zmetzing/rt-ihu/README

This repo holds the physical design files for the:

     Radiation Tolerant Internal Housekeeping Unit (RT-IHU)

The RT-IHU was conceived as a successor to the Fox-series IHU flight computer.
It aims tp increase reliability in higher Earth orbits where a harsher
radiation environment might cause early failure of the "legacy" IHU design.

The directory hierarchy is as follows:

pcb/<name>              Schematic and layout files for <name> board
kicad_lib               Symbol and footprint libraries for KiCAD
docs                    Design documentation for the supervisor

Z. Metzinger 14-Jan-2025

Credits
-------

Initial design/schematic/layout (v1.0, v1.1, v1.2) by Z. Metzinger (N0ZGO)
Design review and input from J. Brandenburg (KF5IDY), B. Davis, B. Fisher (WB1FJ),
       M. McCann (KB2GHZ), B. Reed (NX5R), E. Skoog (K1TVV), J. Trewitt (KF5COQ),
       and all the team members of AMSAT GOLF -- present and former.
KiCAD 7.x conversion and v1.2.1 layout by C. Castillo (KJ7ILB)

Release Notes
-------------

v1.2.1
    U37 and U39 are wired incorrectly and require blue-wire fixes
    U38 is DNI, but a blue wire must be installed between pins 1 and 5 on PCB
