zmetzing/rt-ihu/docs/rtihu_schematic.pdf

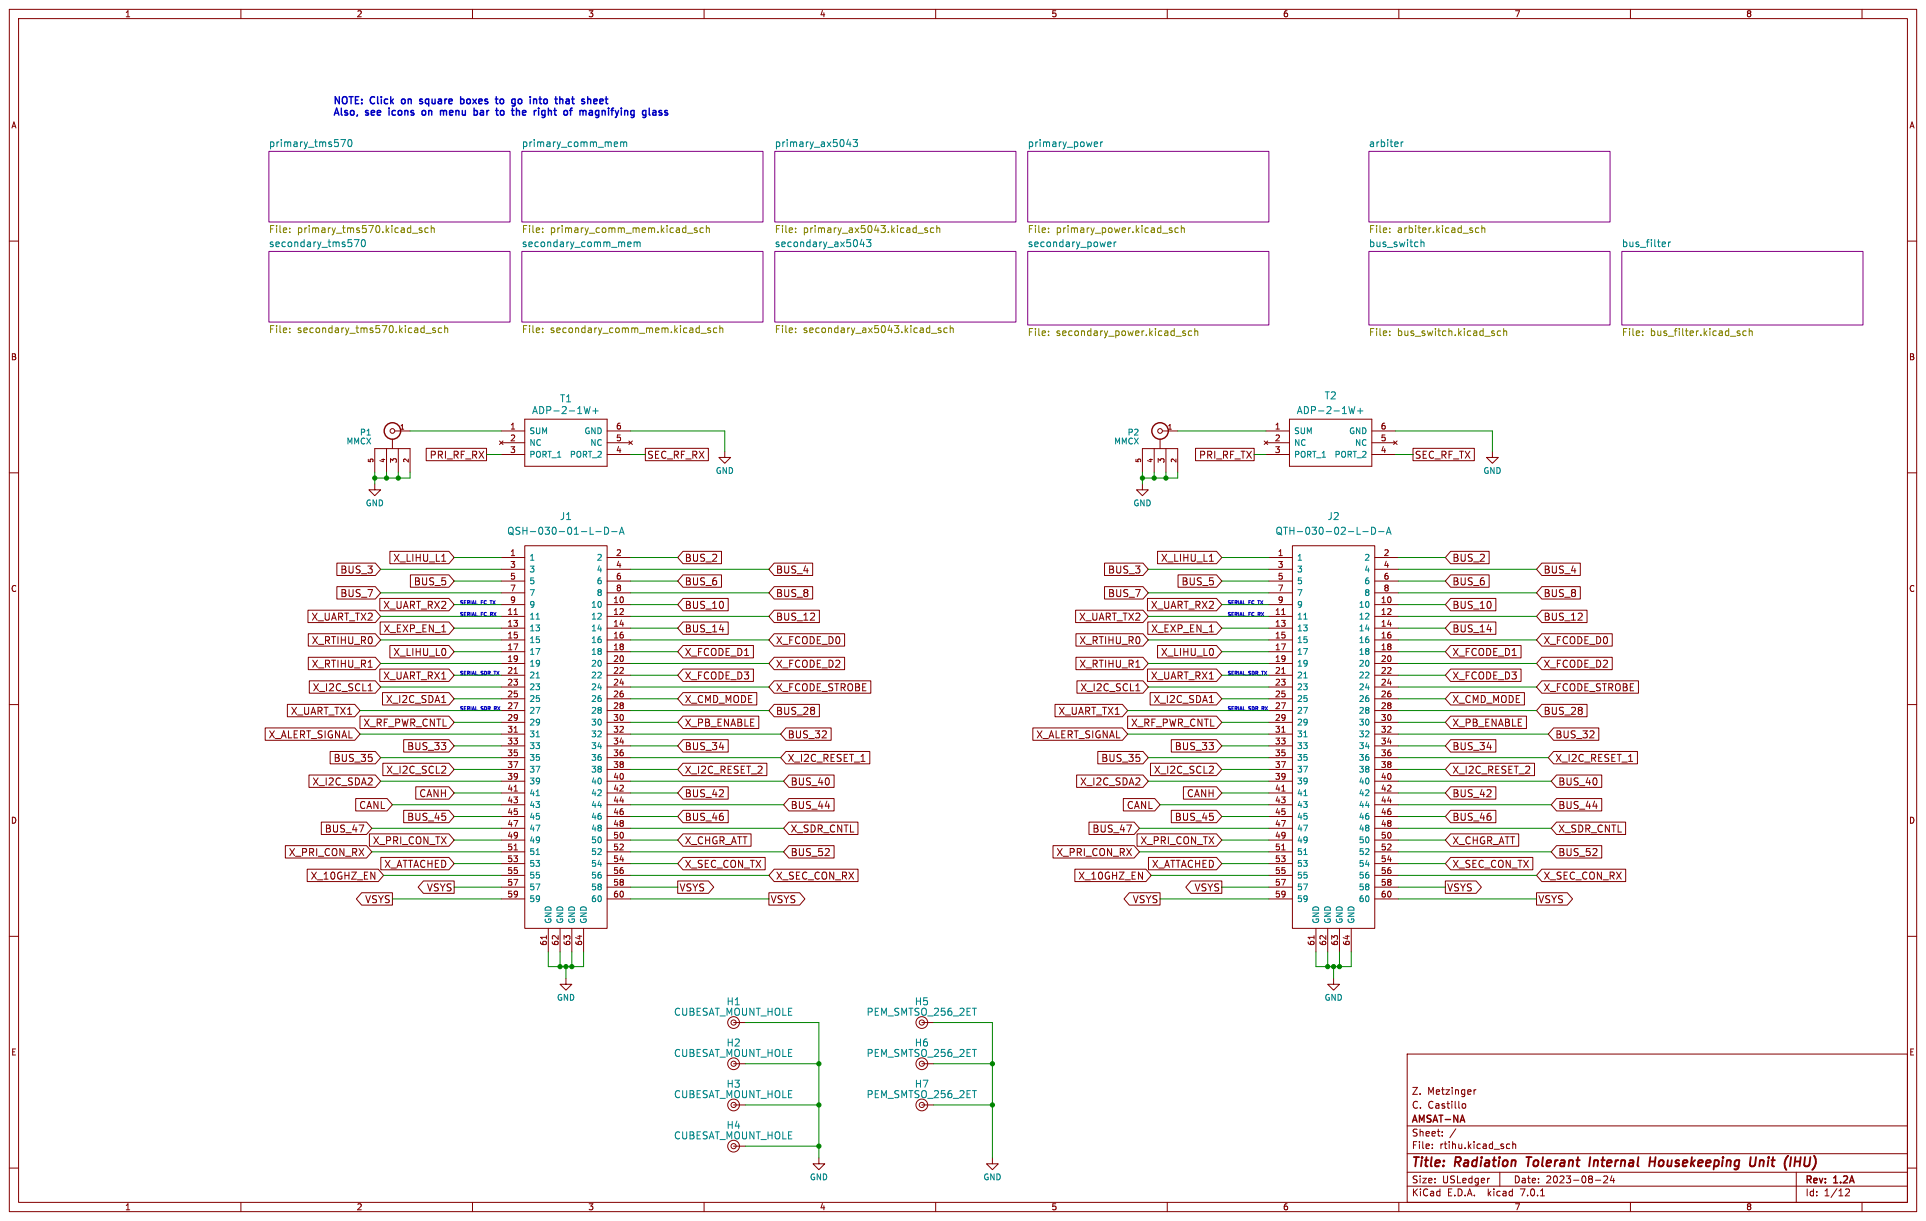
[picture p1: page 1]

NOTE: Click on square boxes to go into that sheet Also, see icons on menu bar to the right of magnifying glass

Id: 1/12 Title: Radiation Tolerant Internal Housekeeping Unit (IHU) File: rtihu.kicad_sch Sheet: / AMSAT-NA

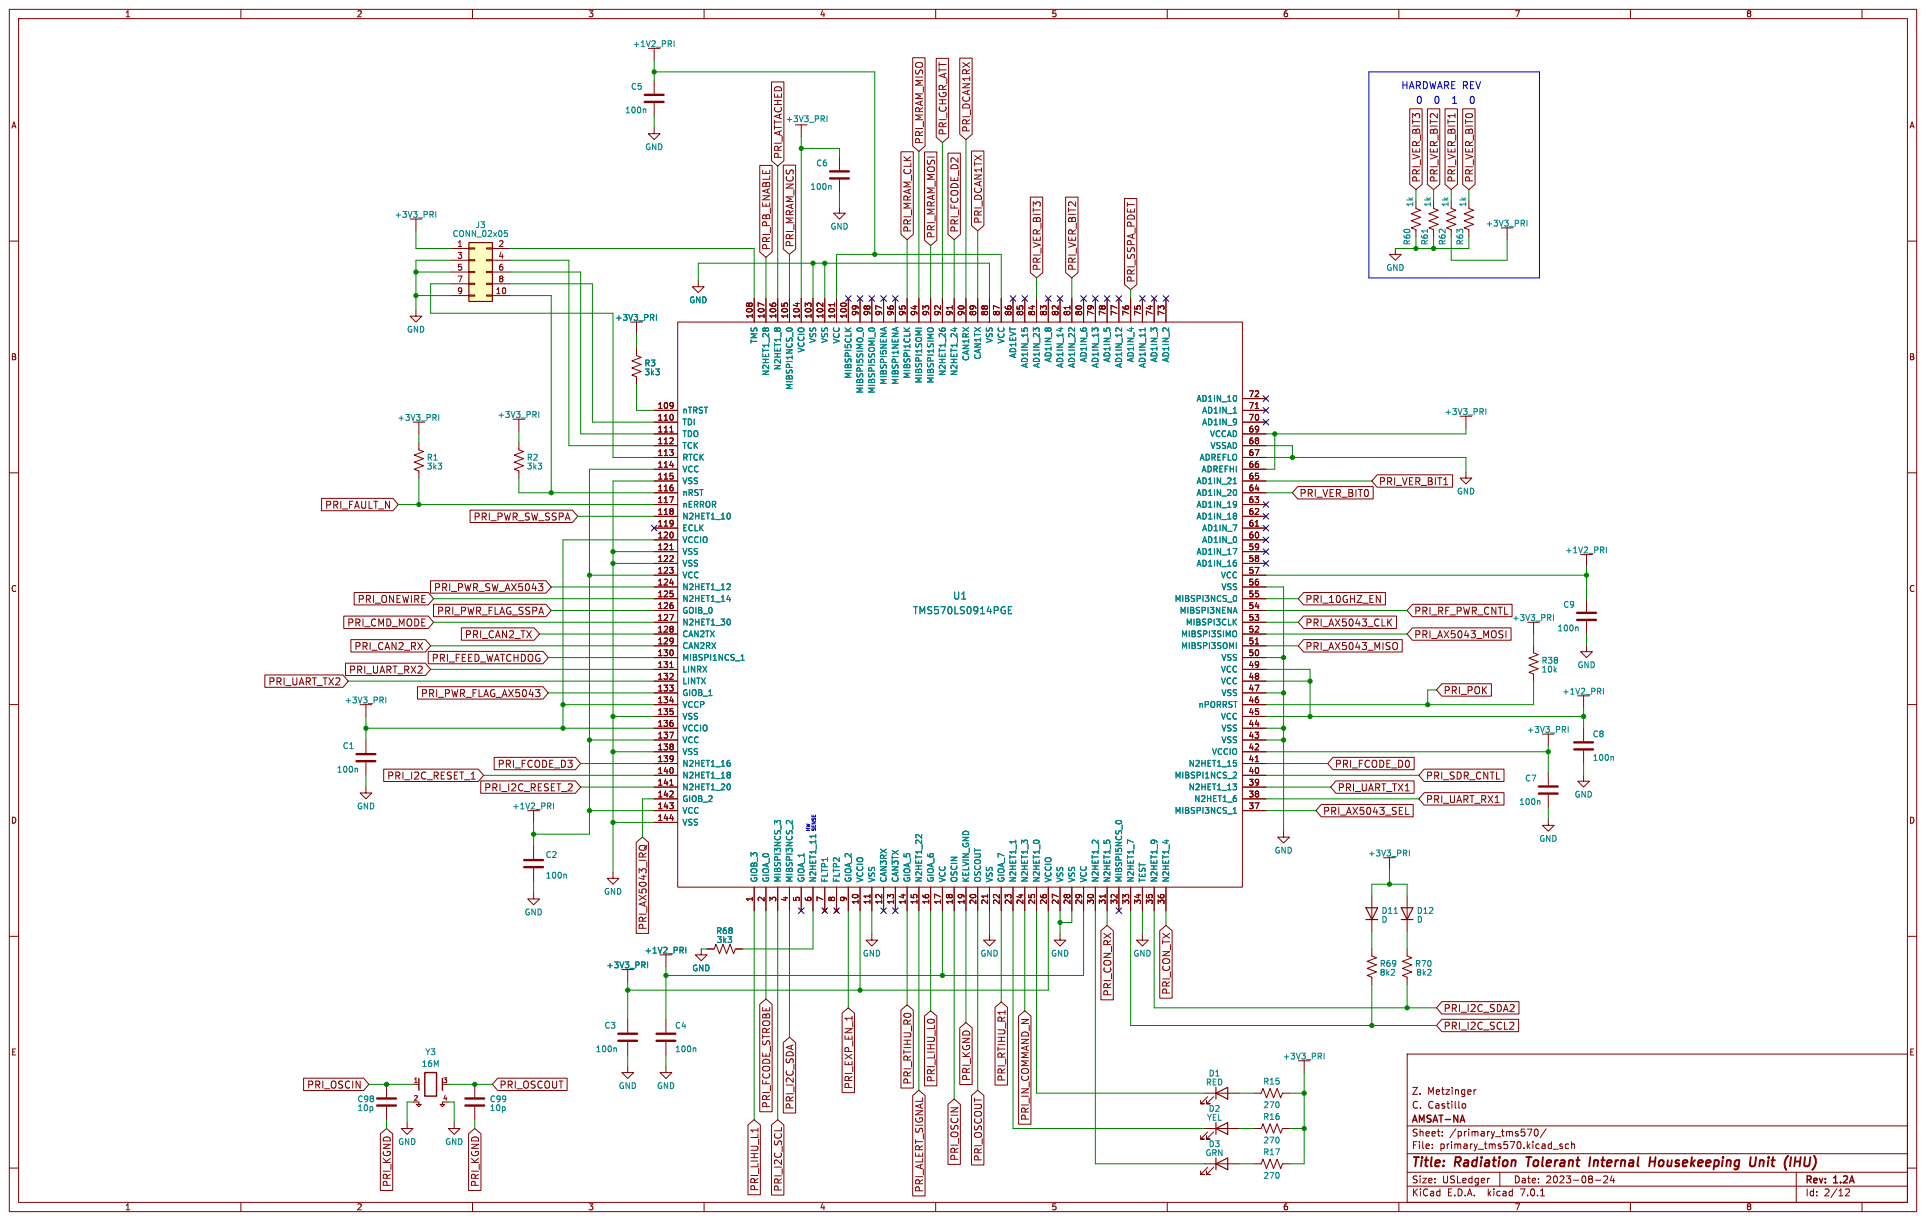
[picture p2: page 2]

C. Castillo Z. | Metzinger

primary_tms570.kicad_sch Sheet: /primary_tms570/ AMSAT-NA Id: 2/12 Title: Radiation Tolerant Internal Housekeeping Unit (IHU) File:

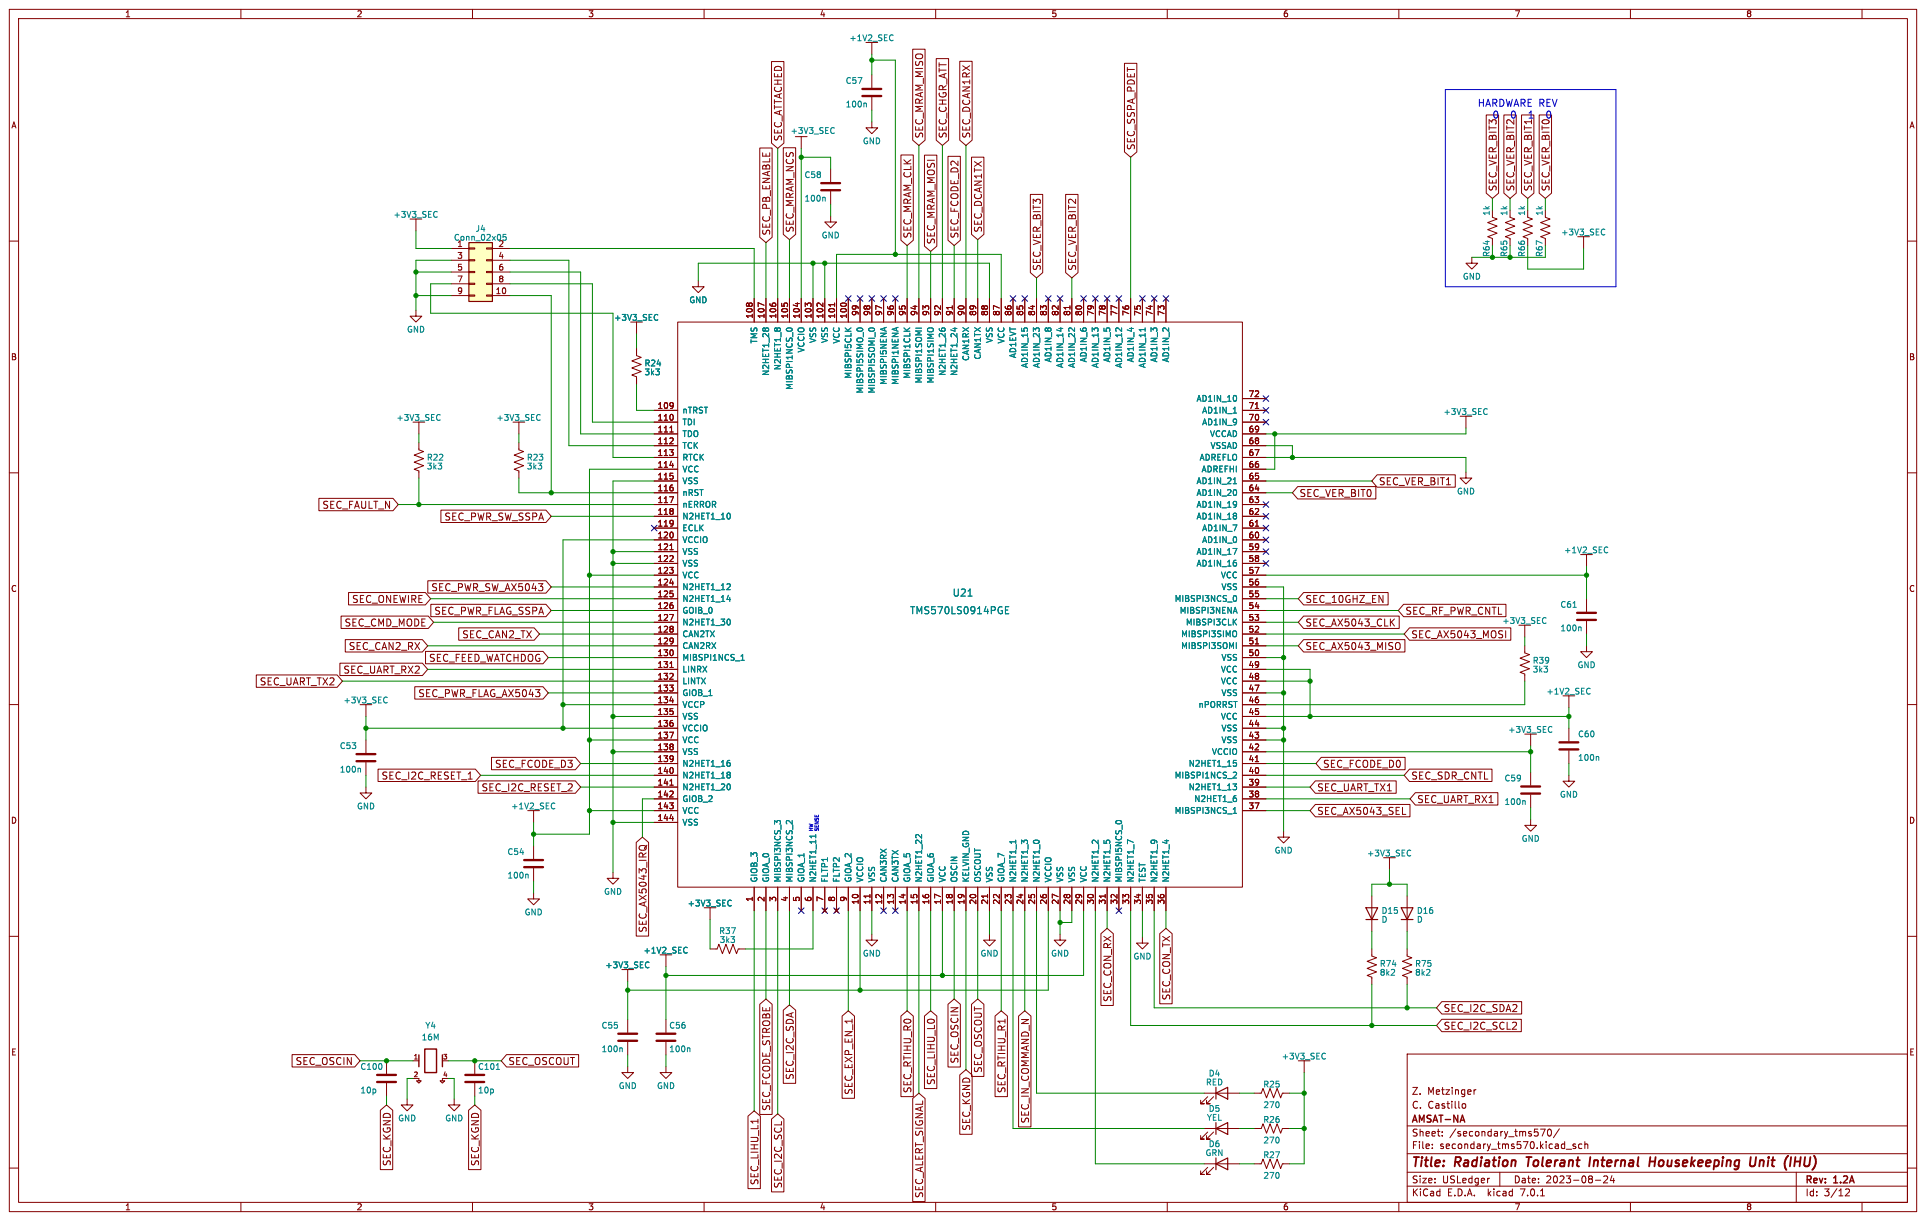
[picture p3: page 3]

Id: 3/12 Title: Radiation Tolerant Internal Housekeeping Unit (IHU) File: secondary_tms570.kicad_sch Sheet: /secondary_tms570/ AMSAT-NA

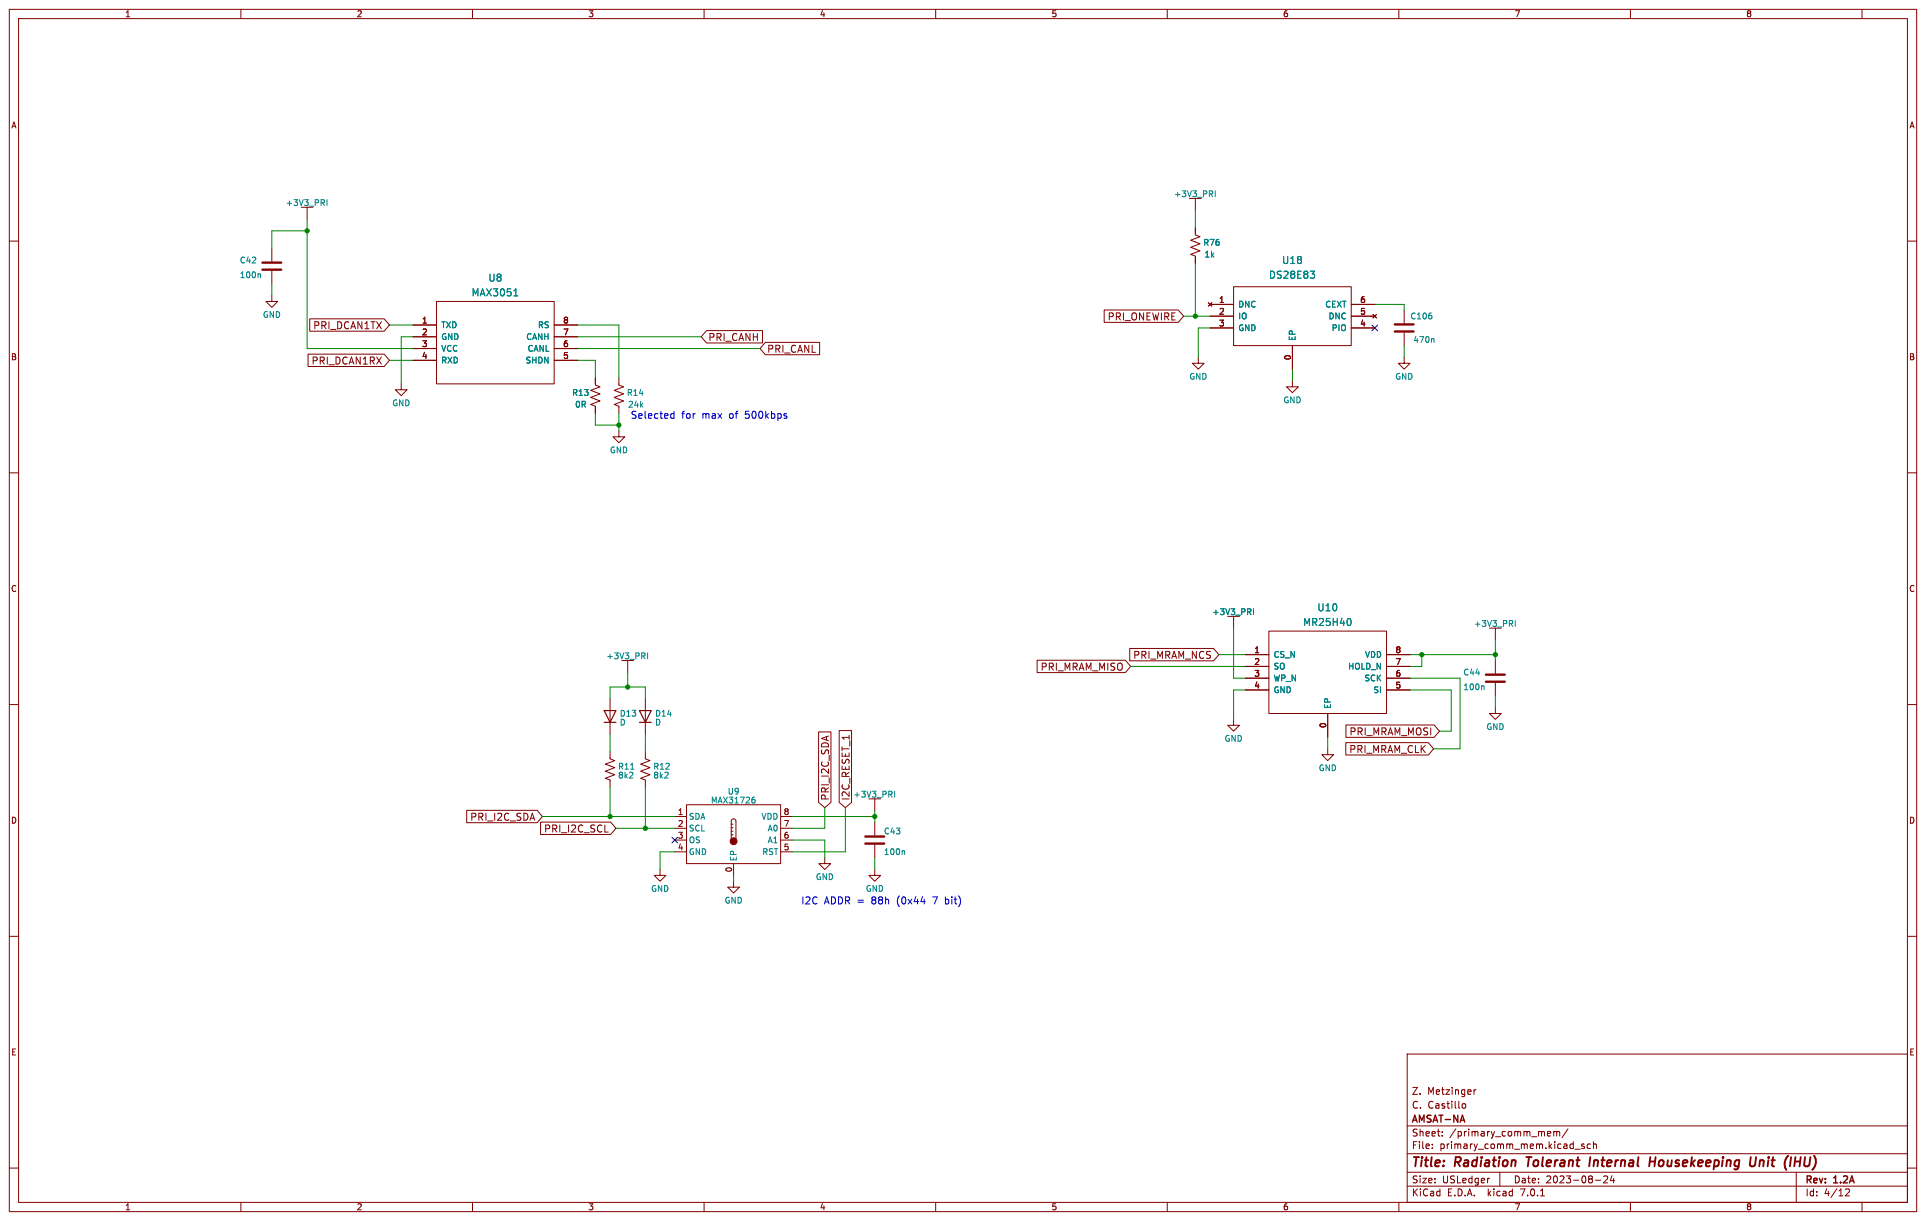
[picture p4: page 4]

0 CS_N 1 SO 2 WP_N 3 GND 4 SI 5 SCK 6 HOLD_N 7 VDD 8 U18 DS28E83 EP

0 CS_N 1 SO 2 WP_N 3 GND 4 SI 5 SCK 6 HOLD_N 7 VDD 8 U10 MR25H40 GND EP

Selected for max of 500kbps

0 SDA 1 SCL 2 OS 3 GND 4 RST 5 A1 6 A0 7 VDD 8 U9 MAX31726 D14 D GND

C. Castillo Z. | Metzinger

primary_comm_mem.kicad_sch Sheet: /primary_comm_mem/ AMSAT-NA Id: 4/12 Title: Radiation Tolerant Internal Housekeeping Unit (IHU) File:

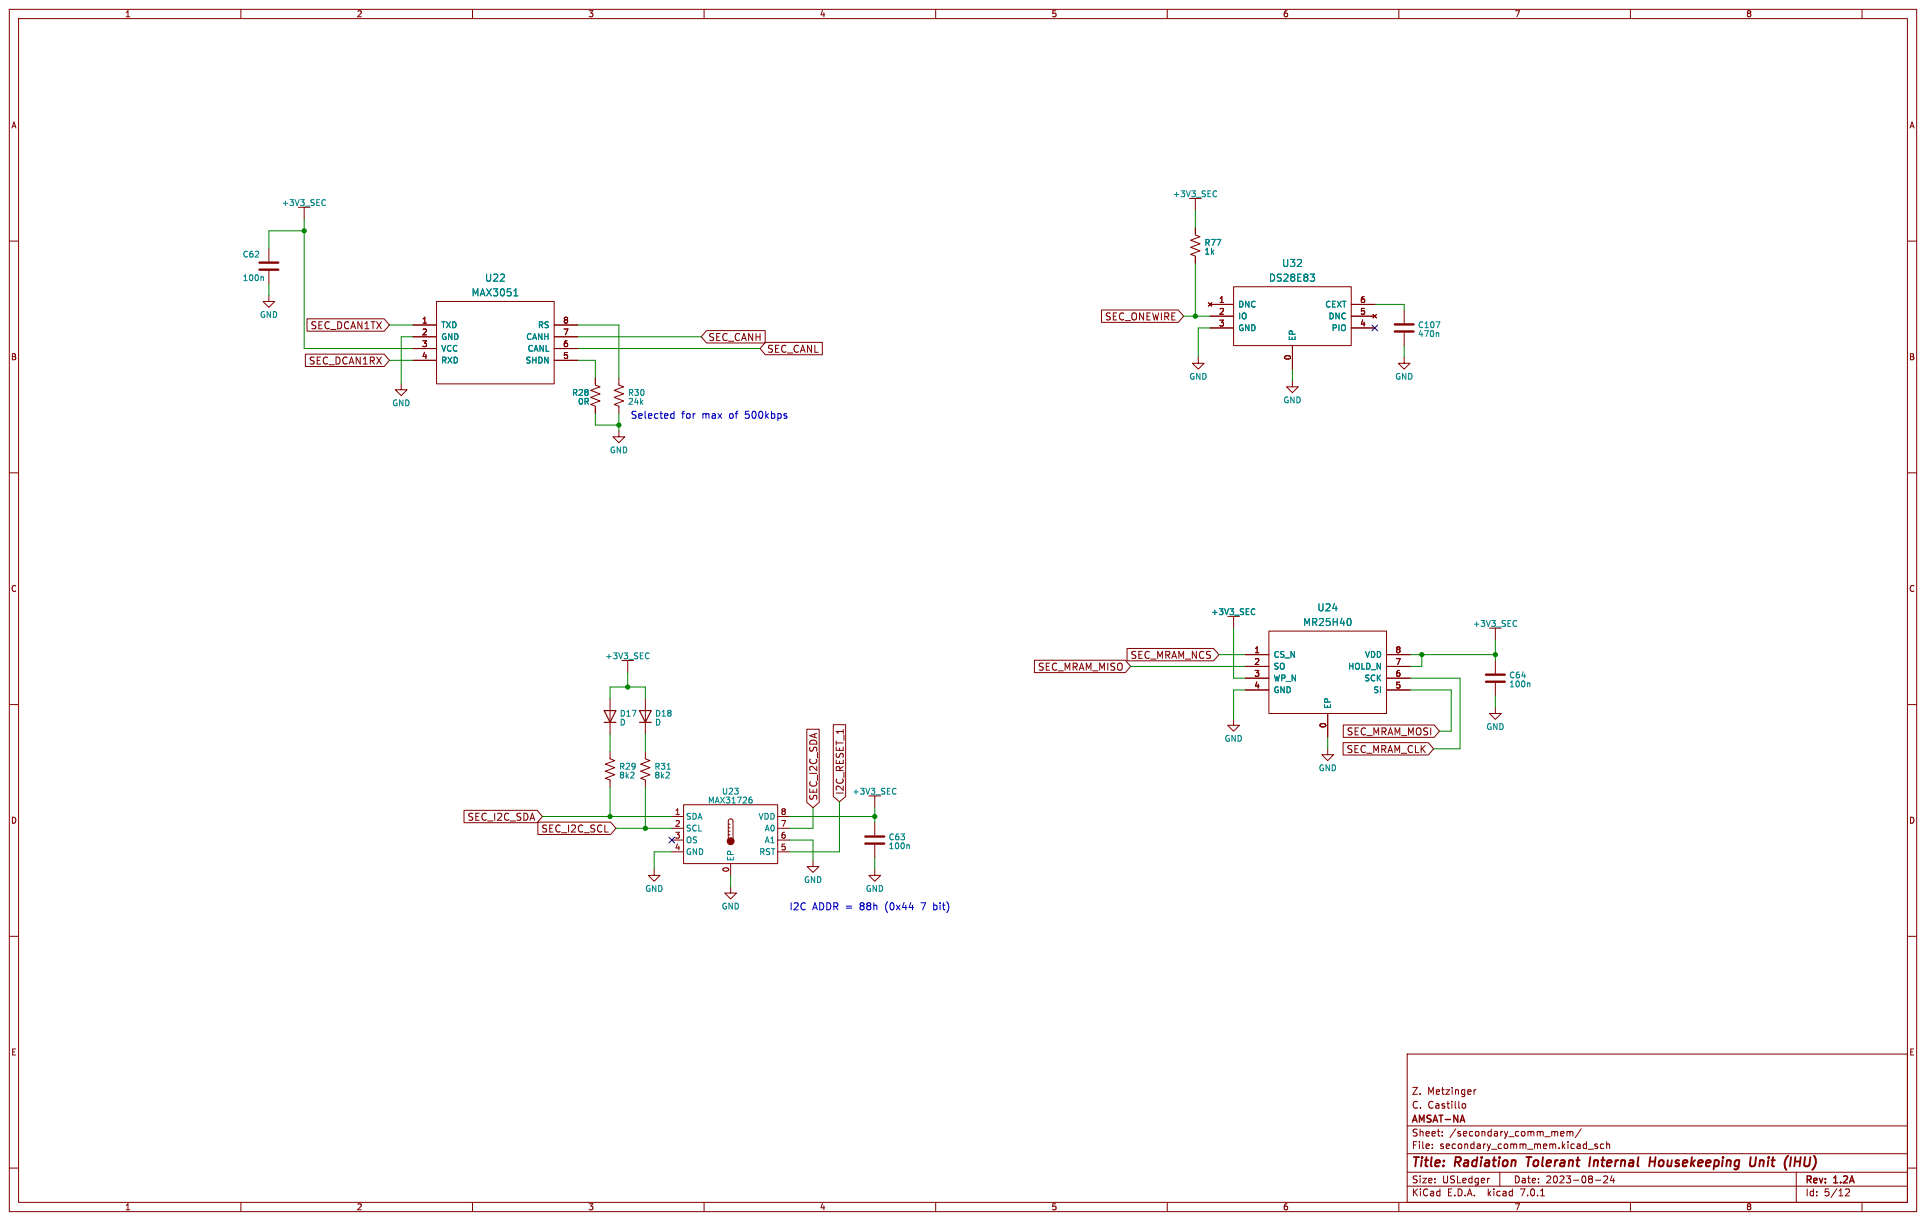
[picture p5: page 5]

Selected for max of 500kbps

0 CS_N 1 SO 2 WP_N 3 GND 4 SI 5 SCK 6 HOLD_N 7 VDD 8 U24 MR25H40 SEC_I2C_SDA

0 CS_N 1 SO 2 WP_N 3 GND 4 SI 5 SCK 6 HOLD_N 7 VDD 8 +3V3_SEC

0 SDA 1 SCL 2 OS 3 GND 4 RST 5 A1 6 A0 7 VDD 8 U23 MAX31726 GND

Id: 5/12 Title: Radiation Tolerant Internal Housekeeping Unit (IHU) File: secondary_comm_mem.kicad_sch Sheet: /secondary_comm_mem/ AMSAT-NA

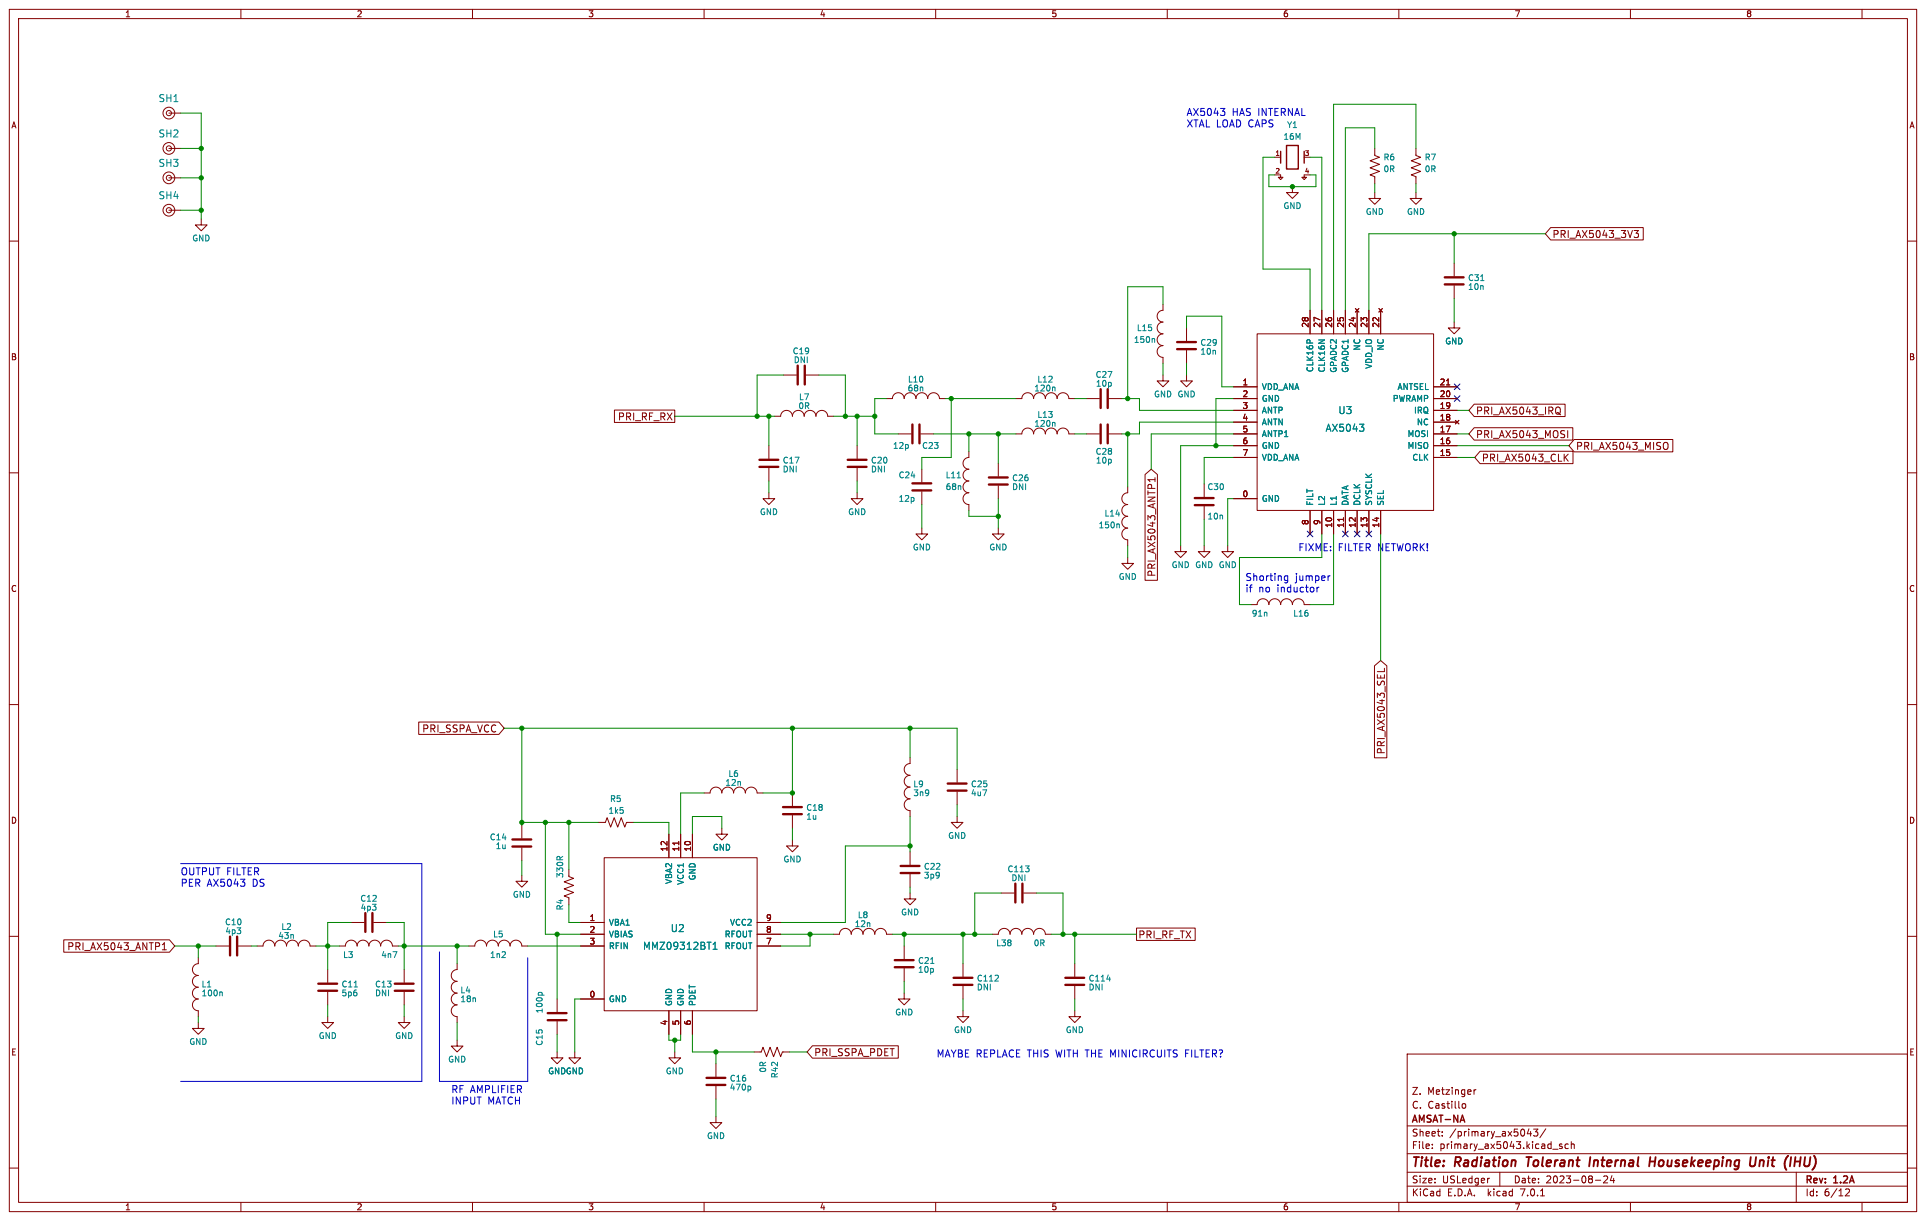
[picture p6: page 6]

AX5043 HAS INTERNAL XTAL LOAD CAPS

6 RFOUT 7 RFOUT 8 VCC2 9 GNDGND GND U3 AX5043 GND 0 VDD_ANA 1 L1 10 DATA 11 DCLK 12 SYSCLK 13 SEL 14 CLK 15 MISO 16 MOSI 17 NC 18

C. Castillo Z. | Metzinger

primary_ax5043.kicad_sch Sheet: /primary_ax5043/ AMSAT-NA Id: 6/12 Title: Radiation Tolerant Internal Housekeeping Unit (IHU) File:

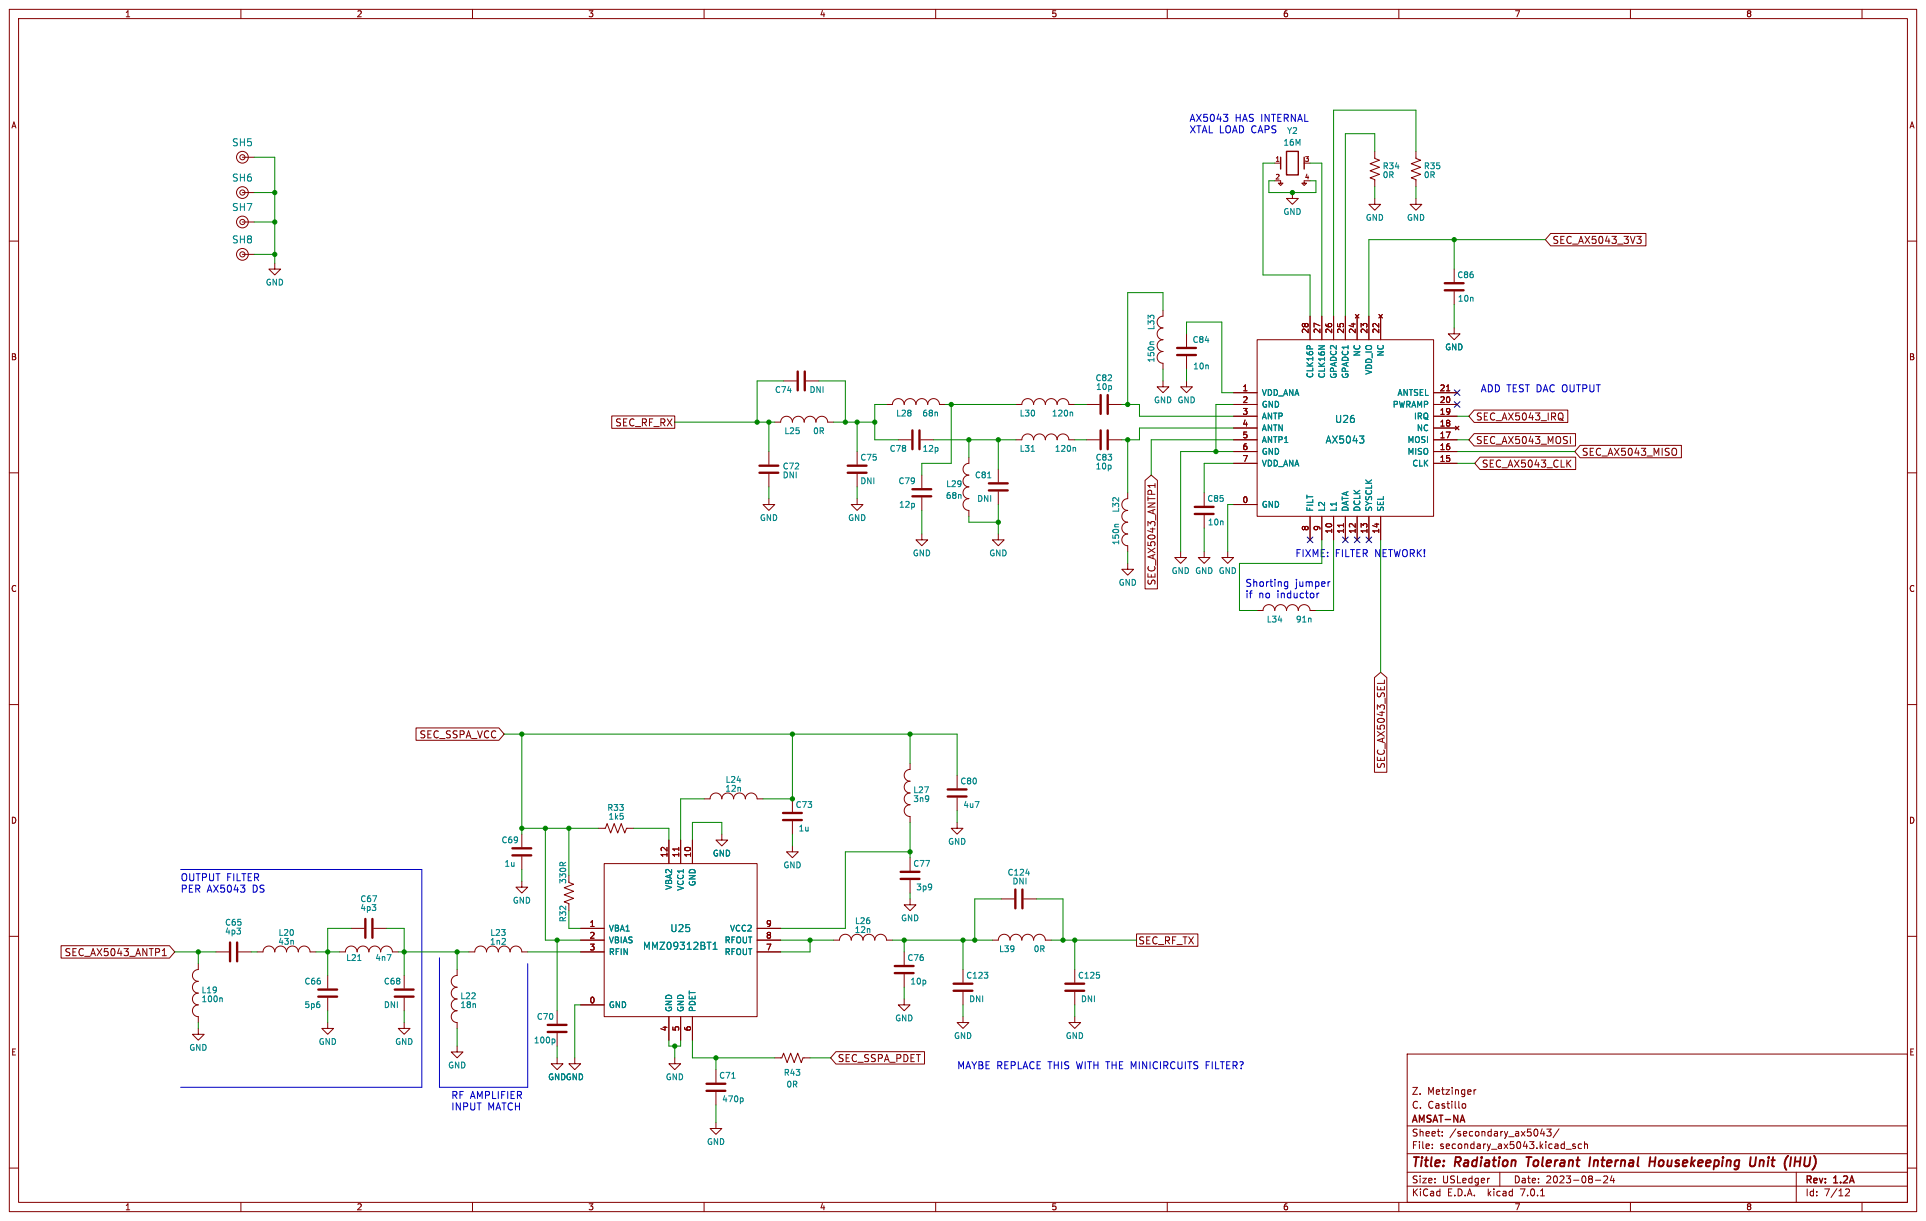
[picture p7: page 7]

FIXME: FILTER NETWORK! AX5043 HAS INTERNAL XTAL LOAD CAPS

ADD TEST DAC OUTPUT MAYBE REPLACE THIS WITH THE MINICIRCUITS FILTER?

if no inductor RF AMPLIFIER

6 RFOUT 7 RFOUT 8 VCC2 9 GND GNDGND

Id: 7/12 Title: Radiation Tolerant Internal Housekeeping Unit (IHU) File: secondary_ax5043.kicad_sch Sheet: /secondary_ax5043/ AMSAT-NA

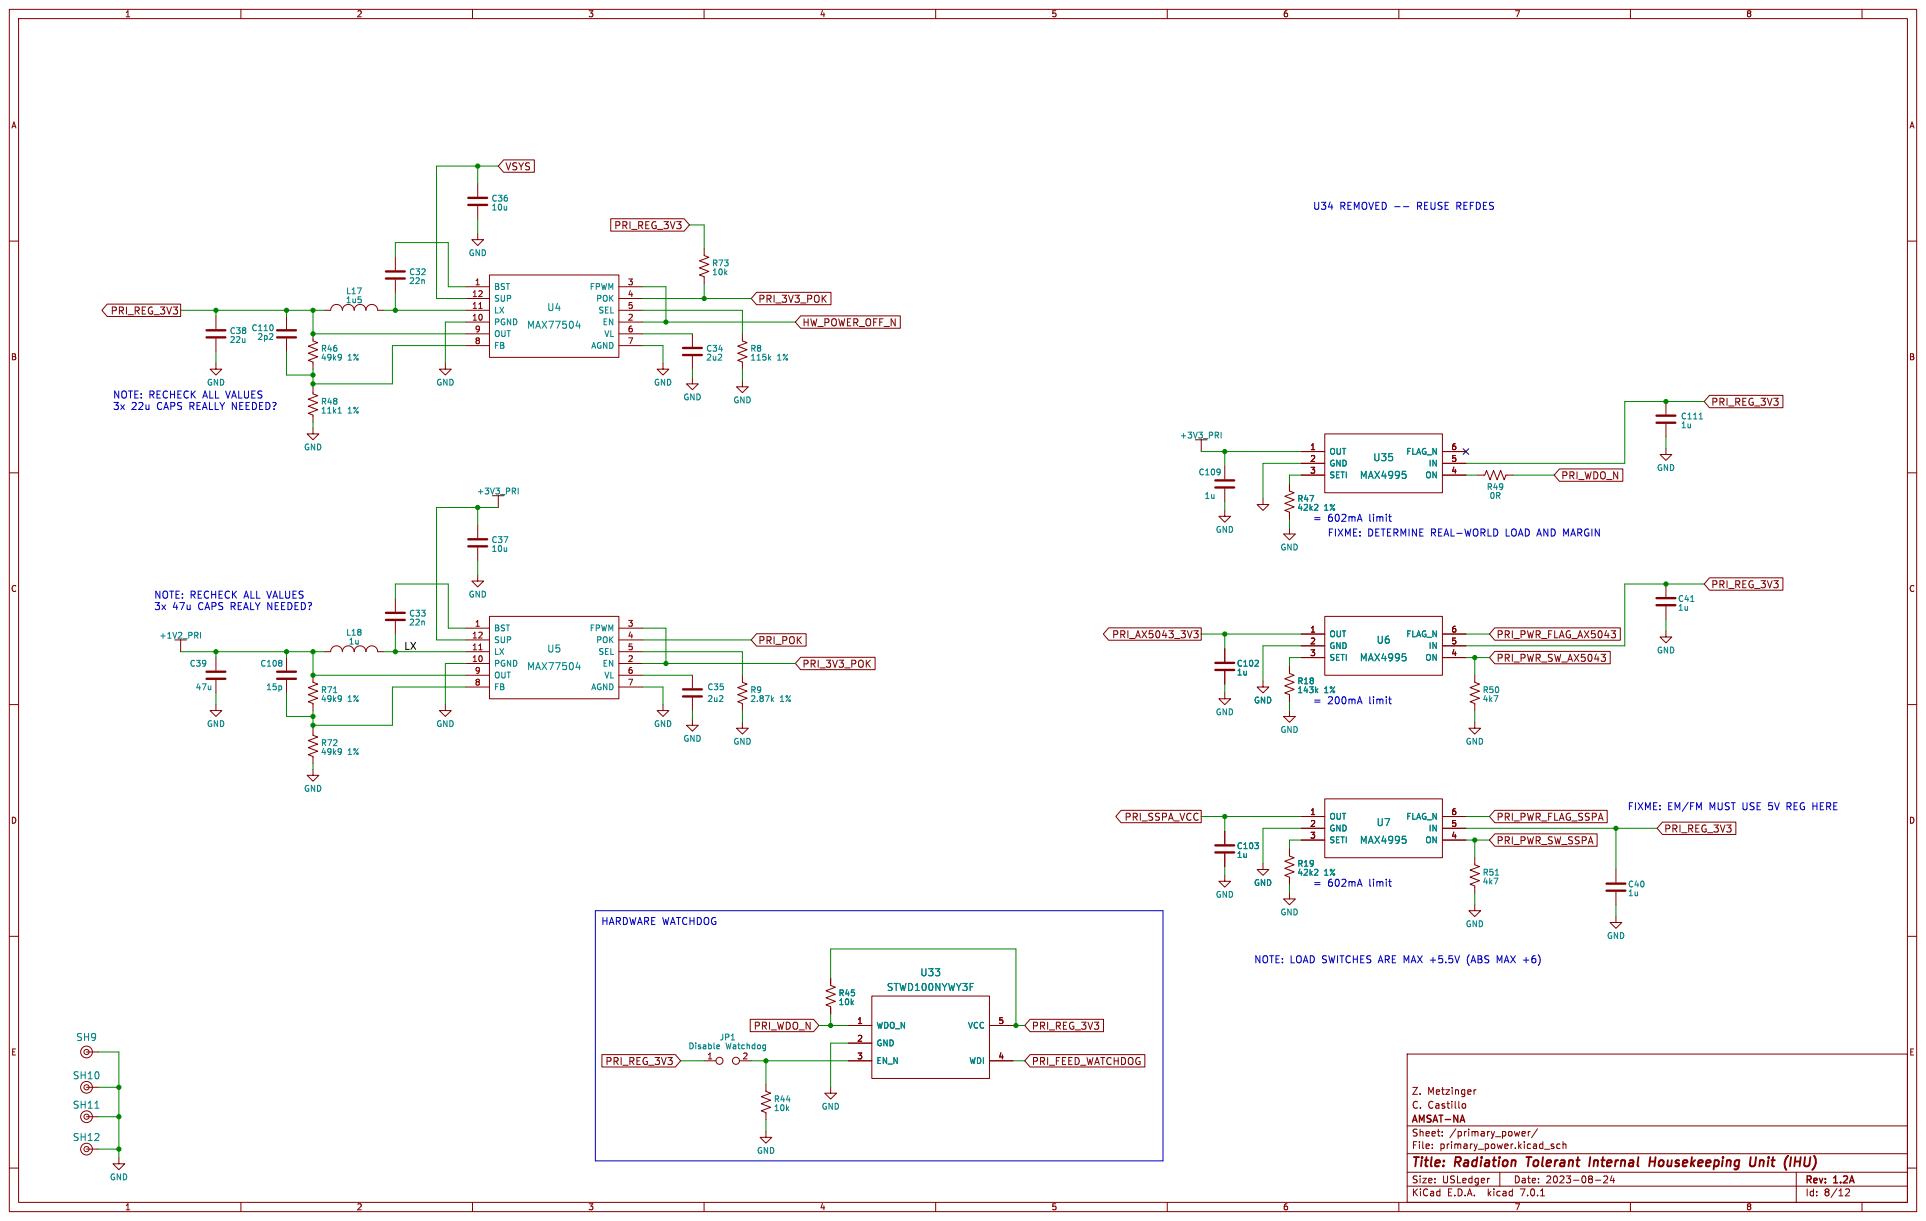
[picture p8: page 8]

NOTE: RECHECK ALL VALUES

FIXME: DETERMINE REAL-WORLD LOAD AND MARGIN

FIXME: EM/FM MUST USE 5V REG HERE

C. Castillo Z. | Metzinger

primary_power.kicad_sch Sheet: /primary_power/ AMSAT-NA | Id: 8/12 Title: Radiation Tolerant Internal Housekeeping Unit (IHU) File:

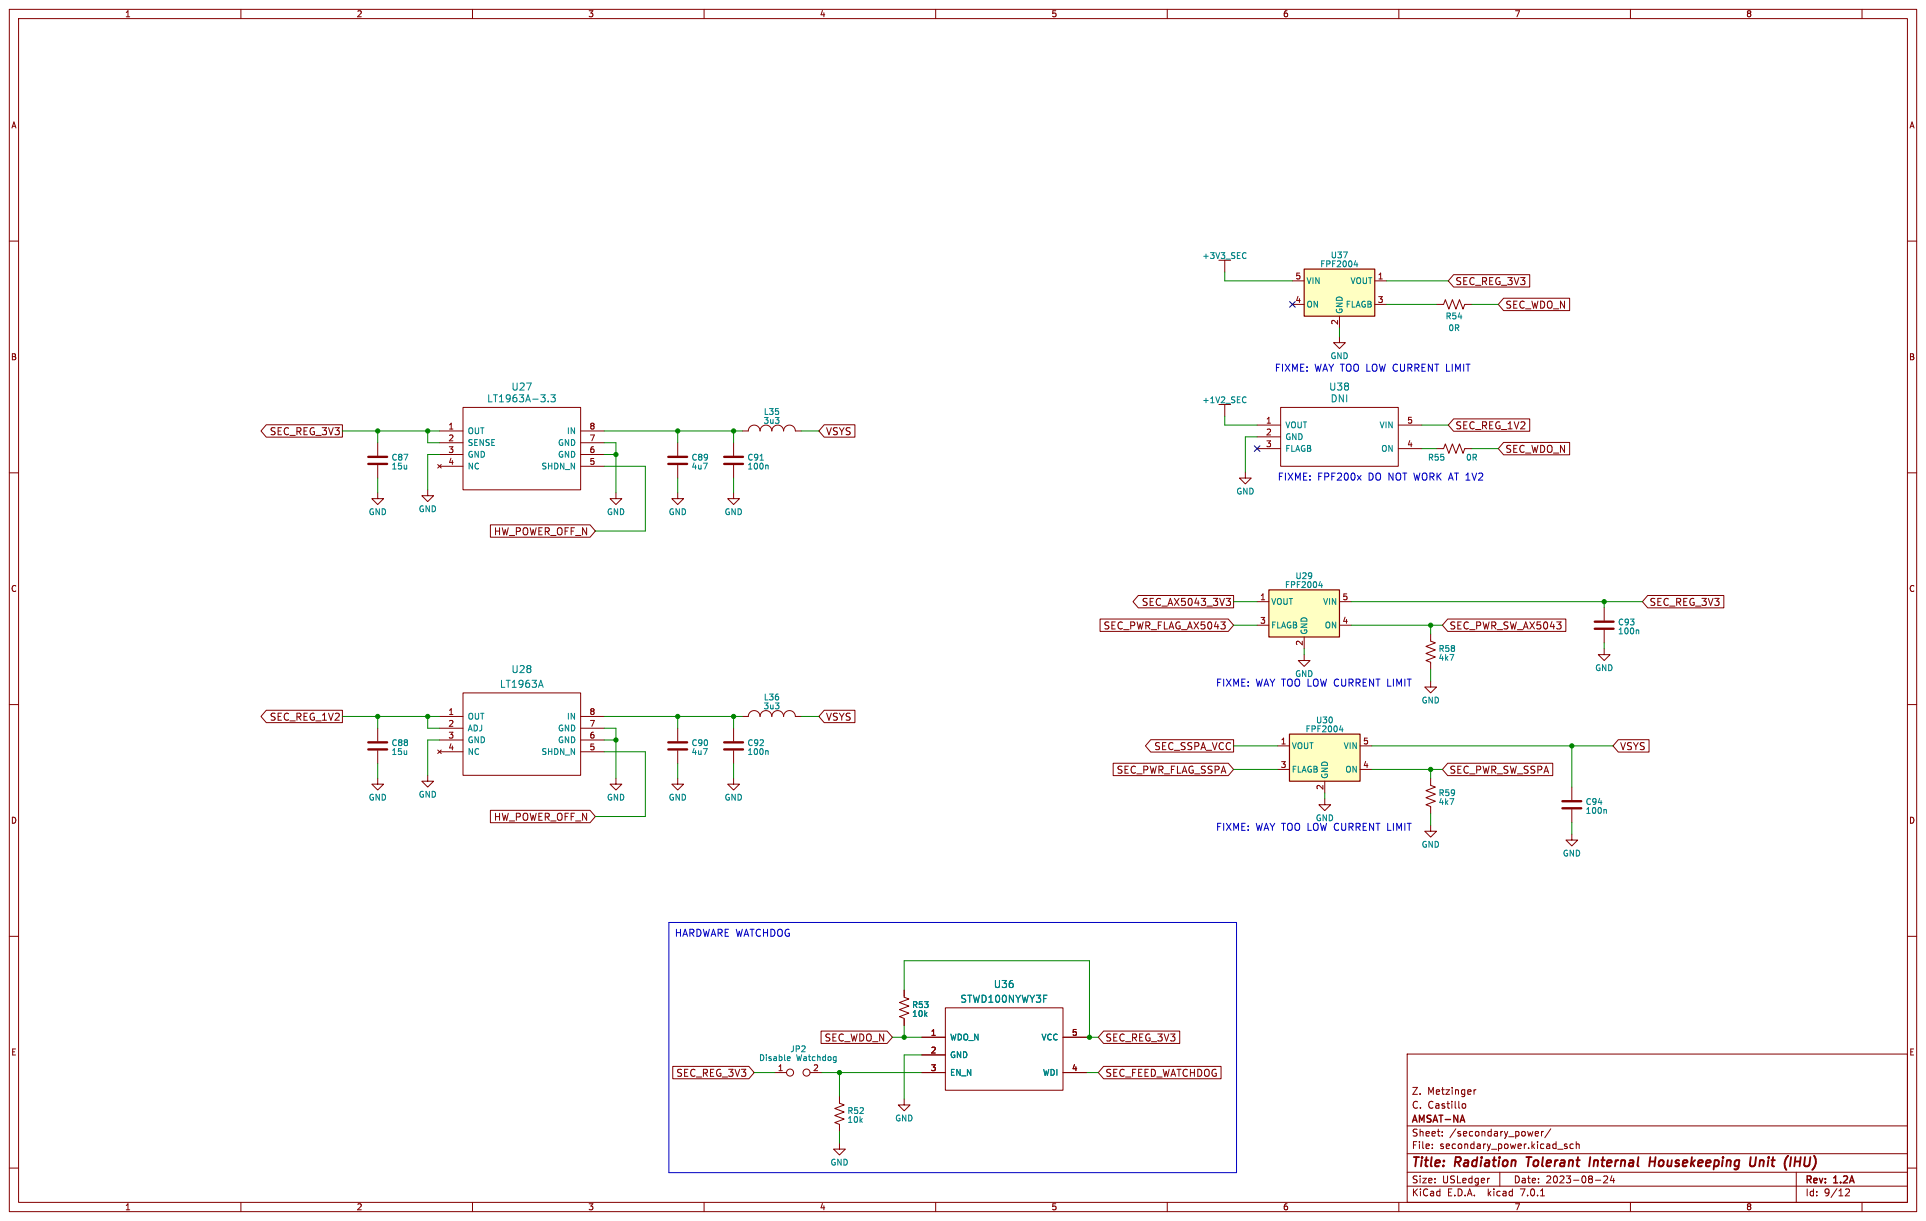
[picture p9: page 9]

2 FLAGB 3 ON 4 VIN 5 U29 FPF2004 GND

FIXME: WAY TOO LOW CURRENT LIMIT

2 FLAGB 3 ON 4 VIN 5 U30 FPF2004 GND GND

Id: 9/12 Title: Radiation Tolerant Internal Housekeeping Unit (IHU) File: secondary_power.kicad_sch Sheet: /secondary_power/ AMSAT-NA

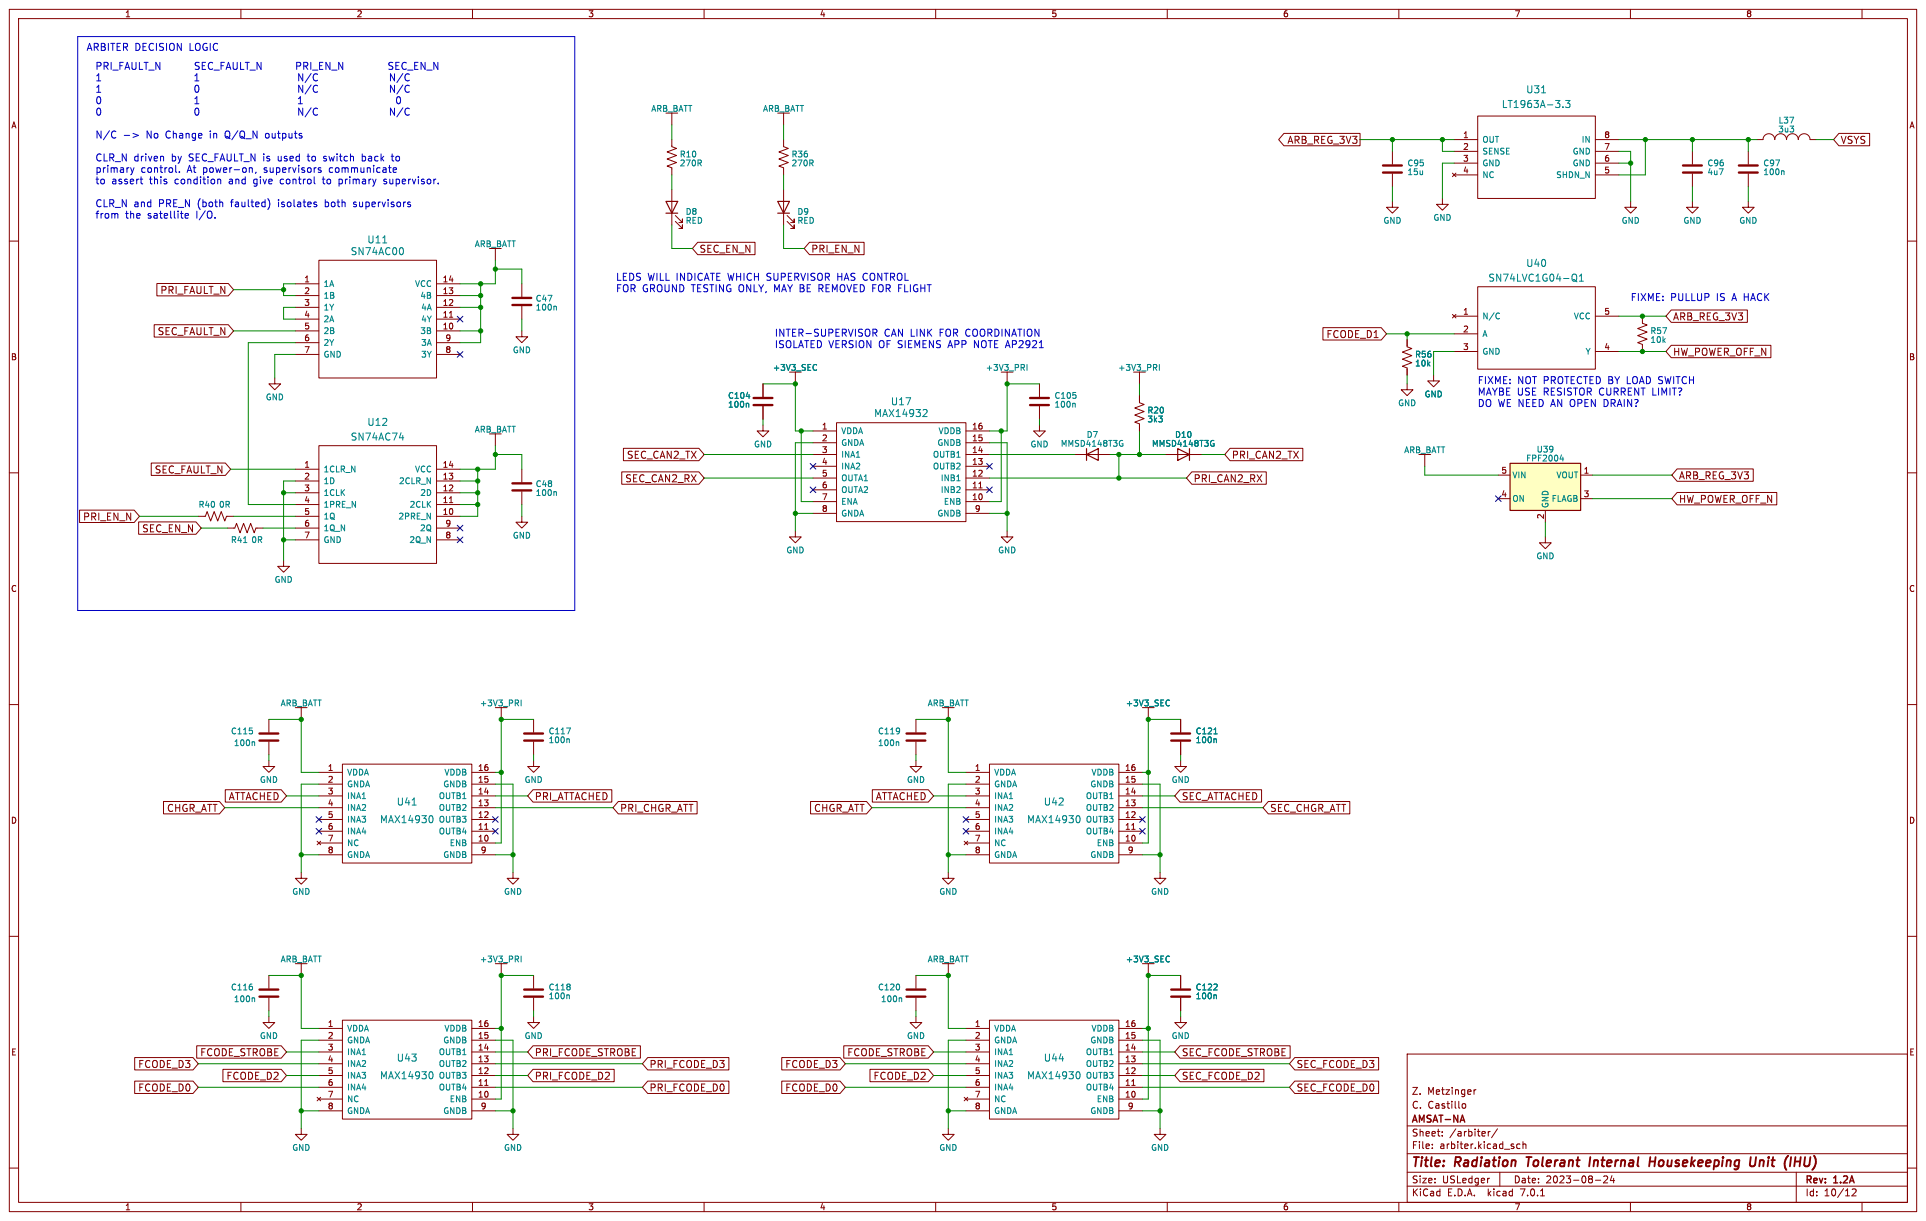
[picture p10: page 10]

ISOLATED VERSION OF SIEMENS APP NOTE AP2921 ARBITER DECISION LOGIC

CLR_N driven by SEC_FAULT_N is used to switch back to

LEDS WILL INDICATE WHICH SUPERVISOR HAS CONTROL
FOR GROUND TESTING ONLY, MAY BE REMOVED FOR FLIGHT

FIXME: NOT PROTECTED BY LOAD SWITCH MAYBE USE RESISTOR CURRENT LIMIT? DO WE NEED AN OPEN DRAIN?FIXME: PULLUP IS A HACK

INTER-SUPERVISOR CAN LINK FOR COORDINATION

2 FLAGB 3 ON 4 VIN 5 U39 FPF2004 VDDA 1 ENB 10

Id: 10/12 Title: Radiation Tolerant Internal Housekeeping Unit (IHU) File: arbiter.kicad_sch Sheet: /arbiter/ AMSAT-NA

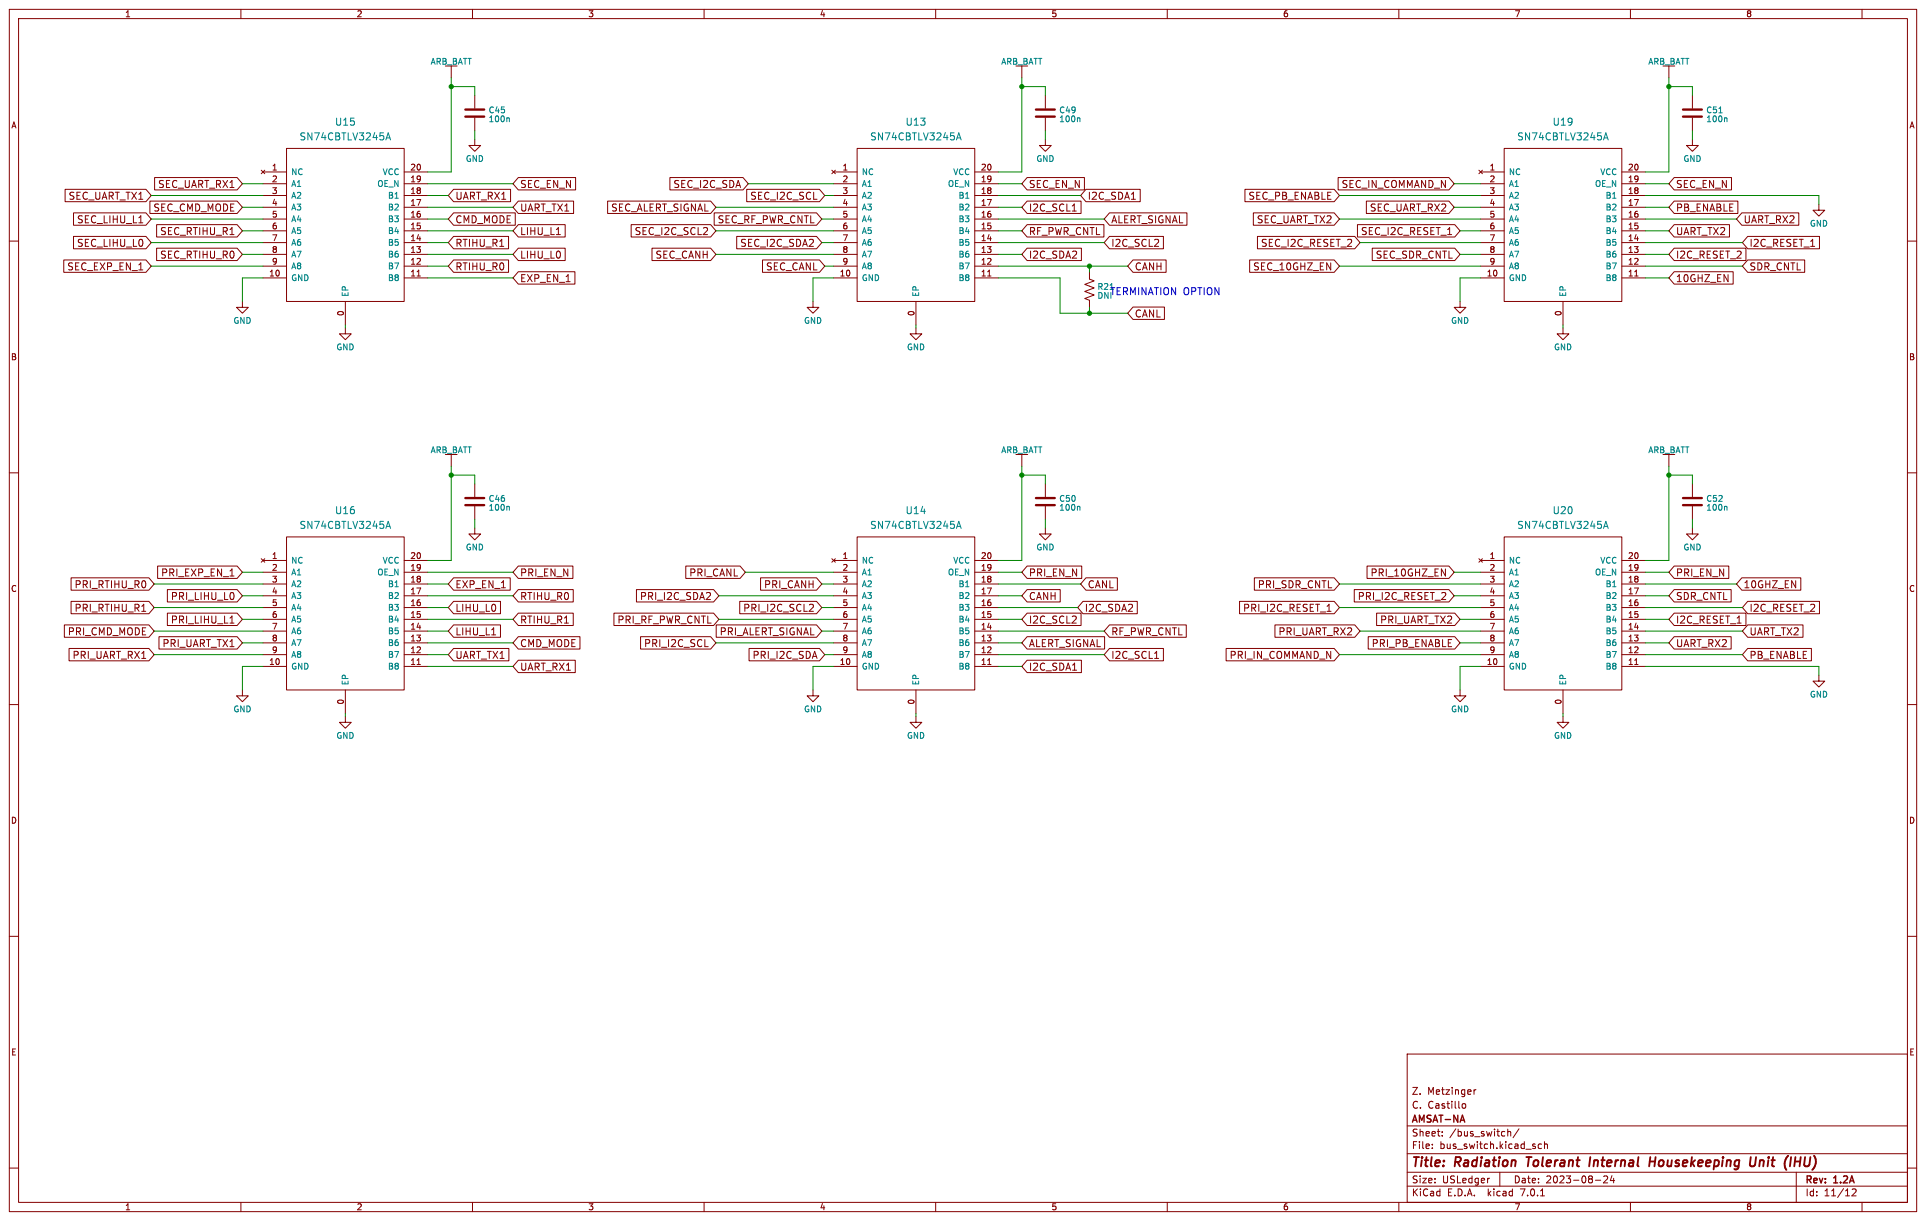
[picture p11: page 11]

0 NC 1 GND 10 B8 11 B7 12 B6 13 B5 14 B4 15 B3 16 B2 17 B1 18 OE_N 19 A1 2 VCC 20 A2 3 A3 4 A4 5 A5 6 A6 7 A7 8 A8 9 U15 SN74CBTLV3245A EP

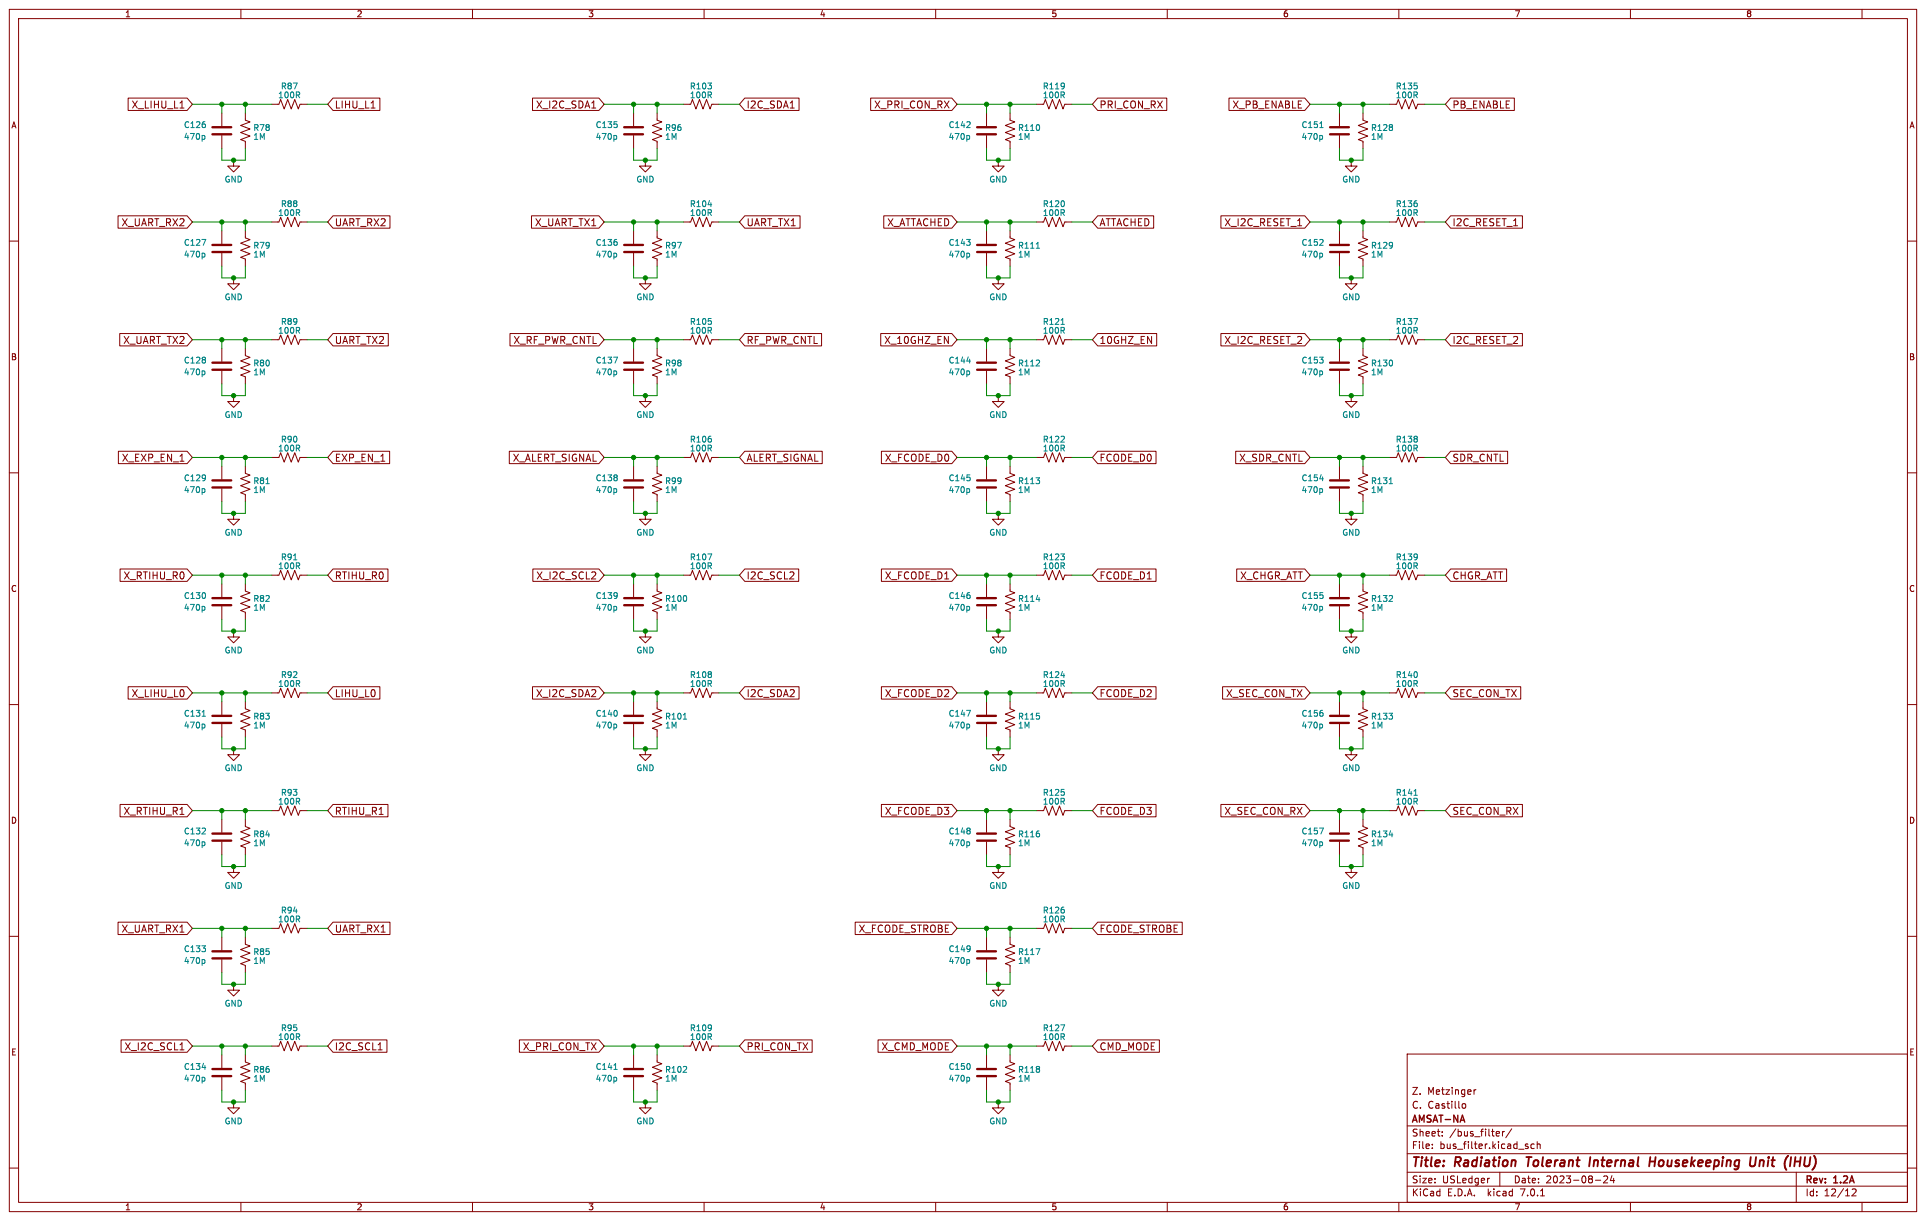
[picture p12: page 12]
