zmetzing/rt-ihu/docs/rt-ihu-block-diagram.pdf

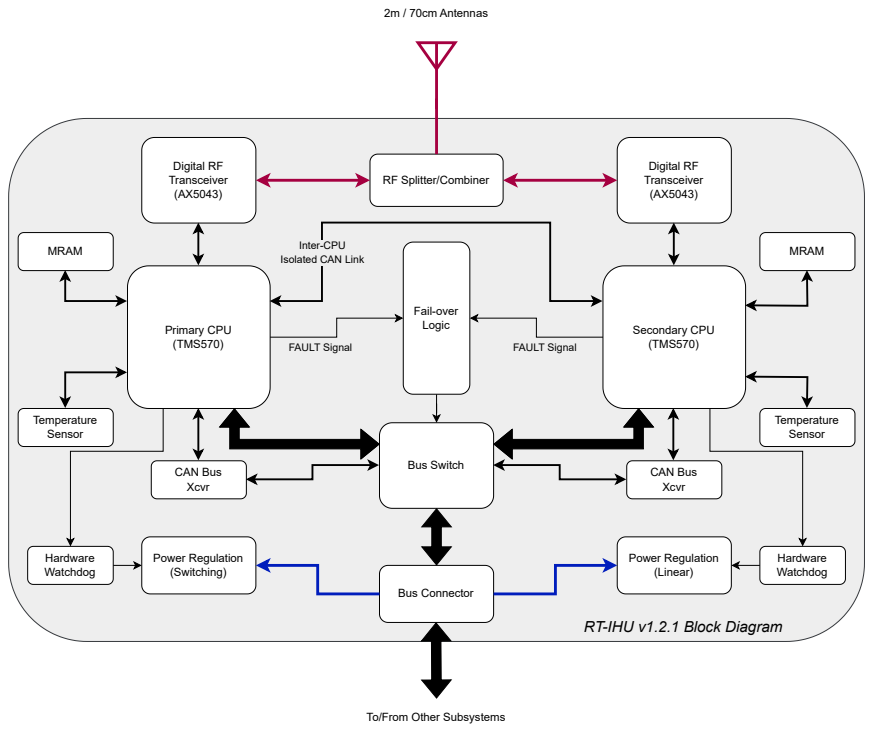
[picture p13: page 1]
Bus Connector; Power Regulation (Switching); Power Regulation (Linear); Fail-over Logic; Bus Switch; Primary CPU (TMS570); Secondary CPU (TMS570); CAN Bus Xcvr; FAULT Signal; Digital RF Transceiver (AX5043); MRAM; Temperature Sensor; 2m / 70cm Antennas; Hardware Watchdog

RF Splitter/Combiner

Inter-CPU
Isolated CAN Link

RT-IHU v1.2.1 Block Diagram

To/From Other Subsystems
