zmetzing/rt-ihu/pcb/arbiter.kicad_sch

## KiCad design pcb/arbiter.kicad_sch (2025-01-14)

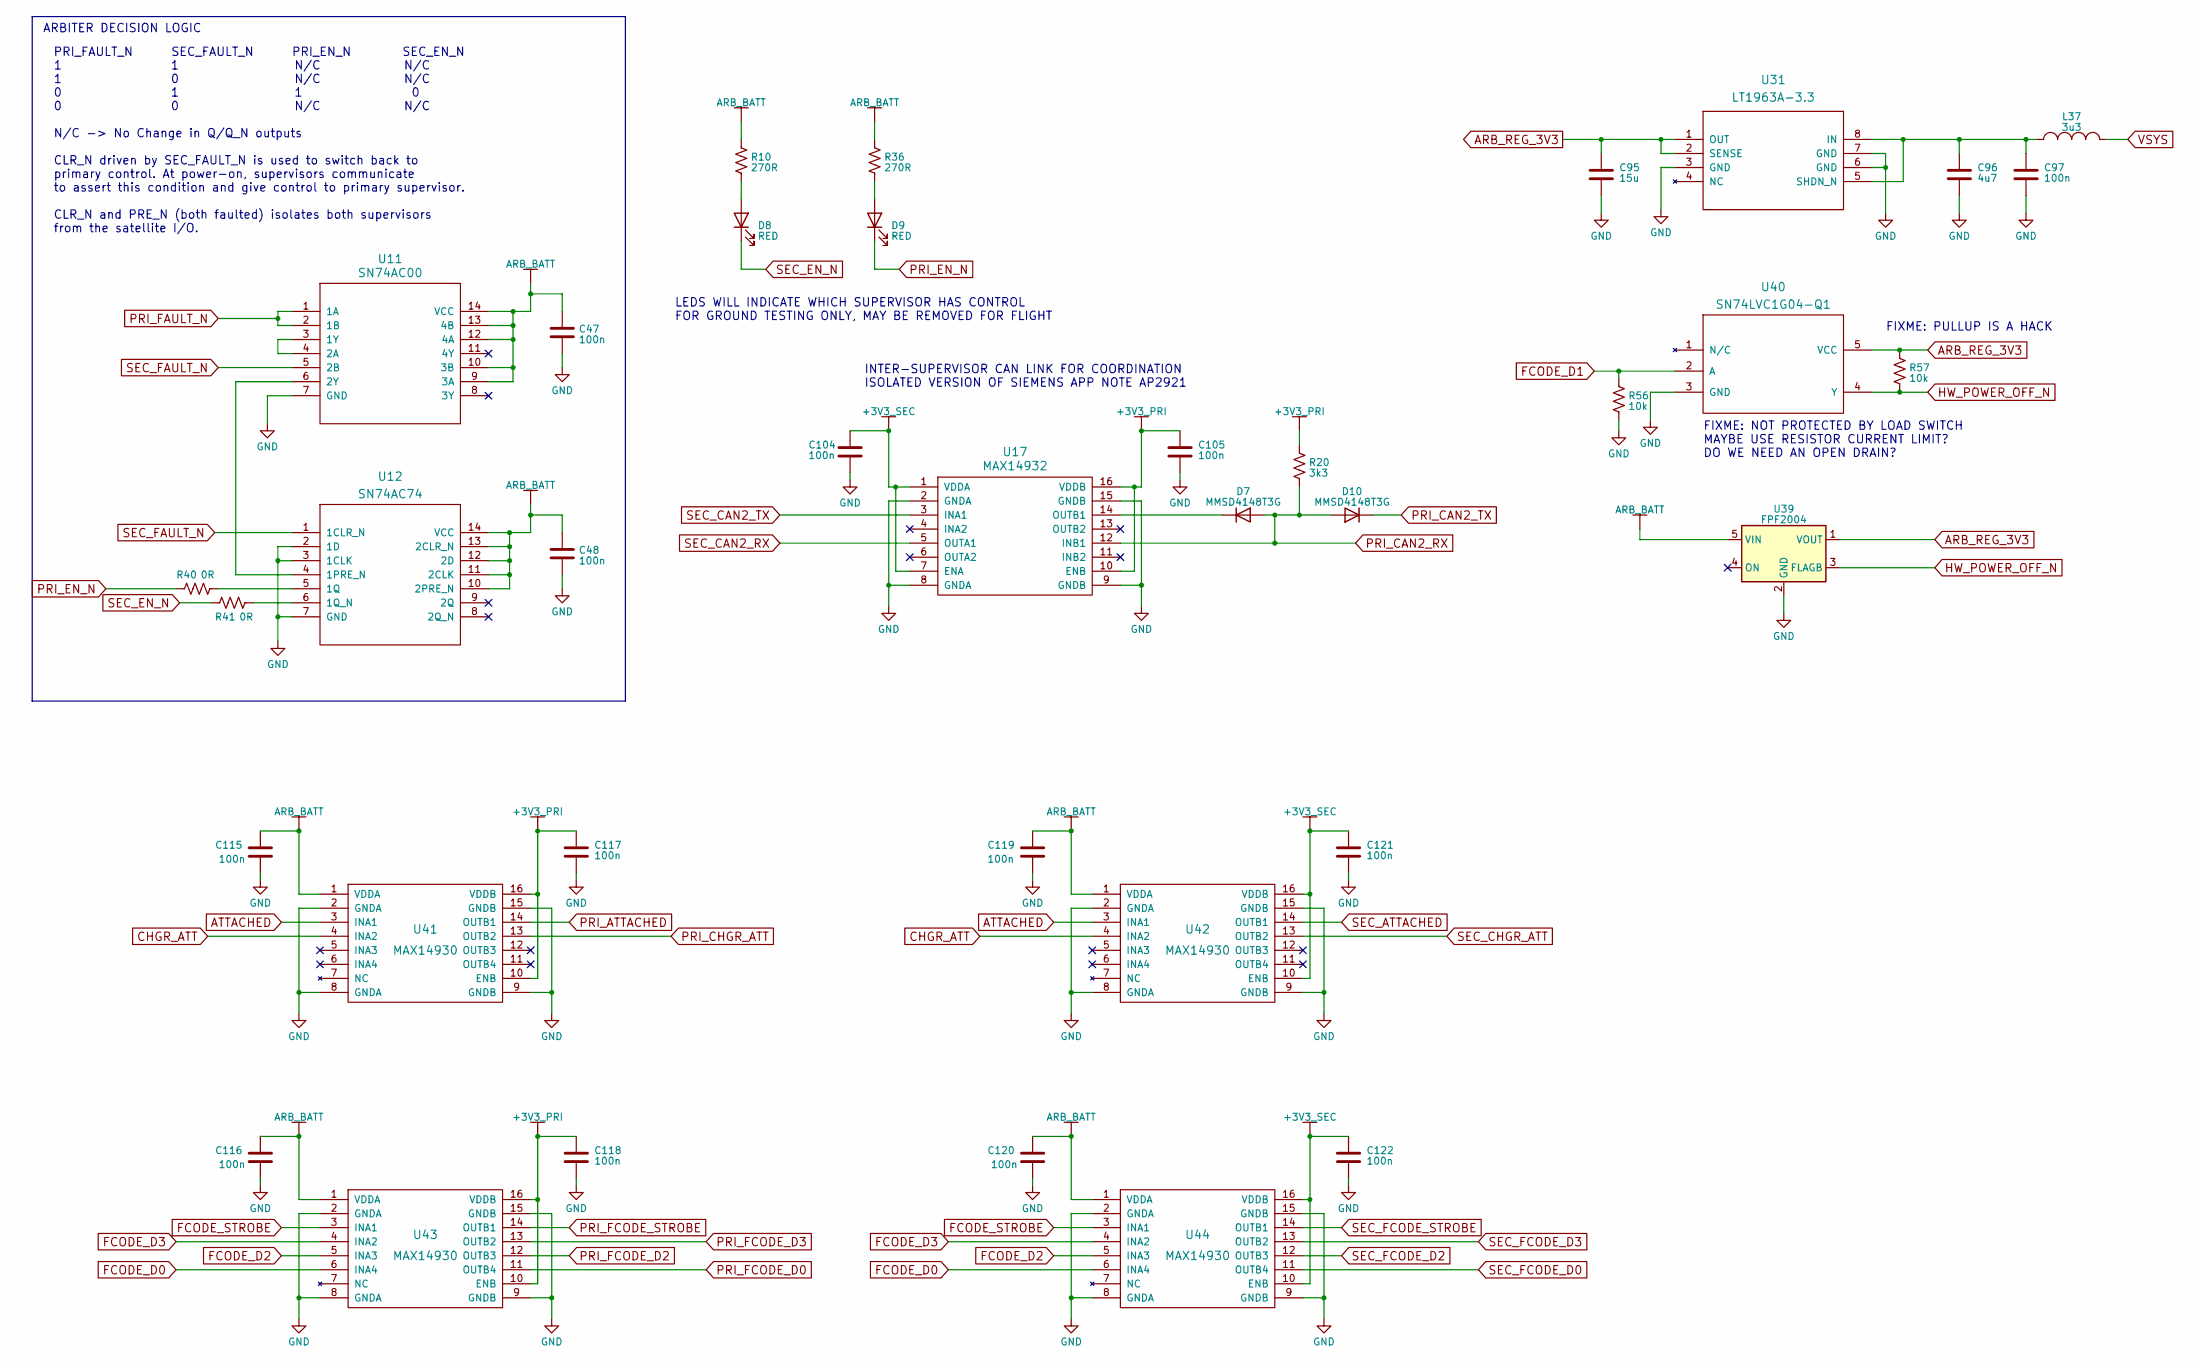
[picture p14: schematic arbiter.kicad_sch]

Parts:
C47, C48, C97, C104, C105, C115, C116, C117, C118, C119, C120, C121, C122: 100n
C95: 15u
C96: 4u7
D7, D10: MMSD4148T3G
D8, D9: RED
L37: 3u3
R10, R36: 270R
R20: 3k3
R40, R41: 0R
R56, R57: 10k
U11: SN74AC00
U12: SN74AC74
U17: MAX14932
U31: LT1963A-3.3
U39: FPF2004; SOT-353_SC-70-5
U40: SN74LVC1G04-Q1
U41, U42, U43, U44: MAX14930

Connections:
+3V3_PRI: C105.1, C117.1, C118.1, R20.1, U17.10 (ENB), U17.16 (VDDB), U41.10 (ENB), U41.16 (VDDB), U43.10 (ENB), U43.16 (VDDB)
+3V3_SEC: C104.1, C121.1, C122.1, U17.1 (VDDA), U17.7 (ENA), U42.10 (ENB), U42.16 (VDDB), U44.10 (ENB), U44.16 (VDDB)
ARB_BATT: C47.1, C48.1, C115.1, C116.1, C119.1, C120.1, R10.2, R36.2, U11.9 (3A), U11.10 (3B), U11.12 (4A), U11.13 (4B), U11.14 (VCC), U12.10 (2PRE_N), U12.11 (2CLK), U12.12 (2D), U12.13 (2CLR_N), U12.14 (VCC), U39.5 (VIN), U41.1 (VDDA), U42.1 (VDDA), U43.1 (VDDA), U44.1 (VDDA)
ARB_REG_3V3: C95.1, R57.1, U31.1 (OUT), U31.2 (SENSE), U39.1 (VOUT), U40.5 (VCC)
ATTACHED: U41.3 (INA1), U42.3 (INA1)
CHGR_ATT: U41.4 (INA2), U42.4 (INA2)
FCODE_D0: U43.6 (INA4), U44.6 (INA4)
FCODE_D1: R56.1, U40.2 (A)
FCODE_D2: U43.5 (INA3), U44.5 (INA3)
FCODE_D3: U43.4 (INA2), U44.4 (INA2)
FCODE_STROBE: U43.3 (INA1), U44.3 (INA1)
GND: C47.2, C48.2, C95.2, C96.2, C97.2, C104.2, C105.2, C115.2, C116.2, C117.2, C118.2, C119.2, C120.2, C121.2, C122.2, R56.2, U11.7 (GND), U12.2 (1D), U12.3 (1CLK), U12.7 (GND), U17.2 (GNDA), U17.8 (GNDA), U17.9 (GNDB), U17.15 (GNDB), U31.3 (GND), U31.6 (GND), U31.7 (GND), U39.2 (GND), U40.3 (GND), U41.2 (GNDA), U41.8 (GNDA), U41.9 (GNDB), U41.15 (GNDB), U42.2 (GNDA), U42.8 (GNDA), U42.9 (GNDB), U42.15 (GNDB), U43.2 (GNDA), U43.8 (GNDA), U43.9 (GNDB), U43.15 (GNDB), U44.2 (GNDA), U44.8 (GNDA), U44.9 (GNDB), U44.15 (GNDB)
HW_POWER_OFF_N: R57.2, U39.3 (FLAGB), U40.4 (Y)
unnamed: C96.1, C97.1, L37.1, U31.5 (SHDN_N), U31.8 (IN)
unnamed: D7.1 (K), U17.14 (OUTB1)
unnamed: D8.2 (A), R10.1
unnamed: D9.2 (A), R36.1
unnamed: R40.2, U12.5 (1Q)
unnamed: R41.2, U12.6 (1Q_N)
unnamed: U11.3 (1Y), U11.4 (2A)
unnamed: U11.6 (2Y), U12.4 (1PRE_N)
PRI_ATTACHED: U41.14 (OUTB1)
PRI_CAN2_RX: D7.2 (A), D10.2 (A), R20.2, U17.12 (INB1)
PRI_CAN2_TX: D10.1 (K)
PRI_CHGR_ATT: U41.13 (OUTB2)
PRI_EN_N: D9.1 (K), R40.1
PRI_FAULT_N: U11.1 (1A), U11.2 (1B)
PRI_FCODE_D0: U43.11 (OUTB4)
PRI_FCODE_D2: U43.12 (OUTB3)
PRI_FCODE_D3: U43.13 (OUTB2)
PRI_FCODE_STROBE: U43.14 (OUTB1)
SEC_ATTACHED: U42.14 (OUTB1)
SEC_CAN2_RX: U17.5 (OUTA1)
SEC_CAN2_TX: U17.3 (INA1)
SEC_CHGR_ATT: U42.13 (OUTB2)
SEC_EN_N: D8.1 (K), R41.1
SEC_FAULT_N: U11.5 (2B), U12.1 (1CLR_N)
SEC_FCODE_D0: U44.11 (OUTB4)
SEC_FCODE_D2: U44.12 (OUTB3)
SEC_FCODE_D3: U44.13 (OUTB2)
SEC_FCODE_STROBE: U44.14 (OUTB1)
VSYS: L37.2

Notes on the sheet:
ARBITER DECISION LOGIC
FIXME: NOT PROTECTED BY LOAD SWITCH MAYBE USE RESISTOR CURRENT LIMIT? DO WE NEED AN OPEN DRAIN?
PRI_FAULT_N SEC_FAULT_N PRI_EN_N SEC_EN_N 1 1 N/C N/C 1 0 N/C N/C 0 1 1 0 0 0 N/C N/C N/C -> No Change in Q/Q_N outputs CLR_N driven by SEC_FAULT_N is used to switch back to primary control. At power-on, supervisors communicate to assert this condition and give control to primary supervisor. CLR_N 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
LEDS WILL INDICATE WHICH SUPERVISOR HAS CONTROL FOR GROUND TESTING ONLY, MAY BE REMOVED FOR FLIGHT
FIXME: PULLUP IS A HACK
INTER-SUPERVISOR CAN LINK FOR COORDINATION ISOLATED VERSION OF SIEMENS APP NOTE AP2921
