zmetzing/rt-ihu/pcb/bus_filter.kicad_sch

## KiCad design pcb/bus_filter.kicad_sch (2025-01-14)

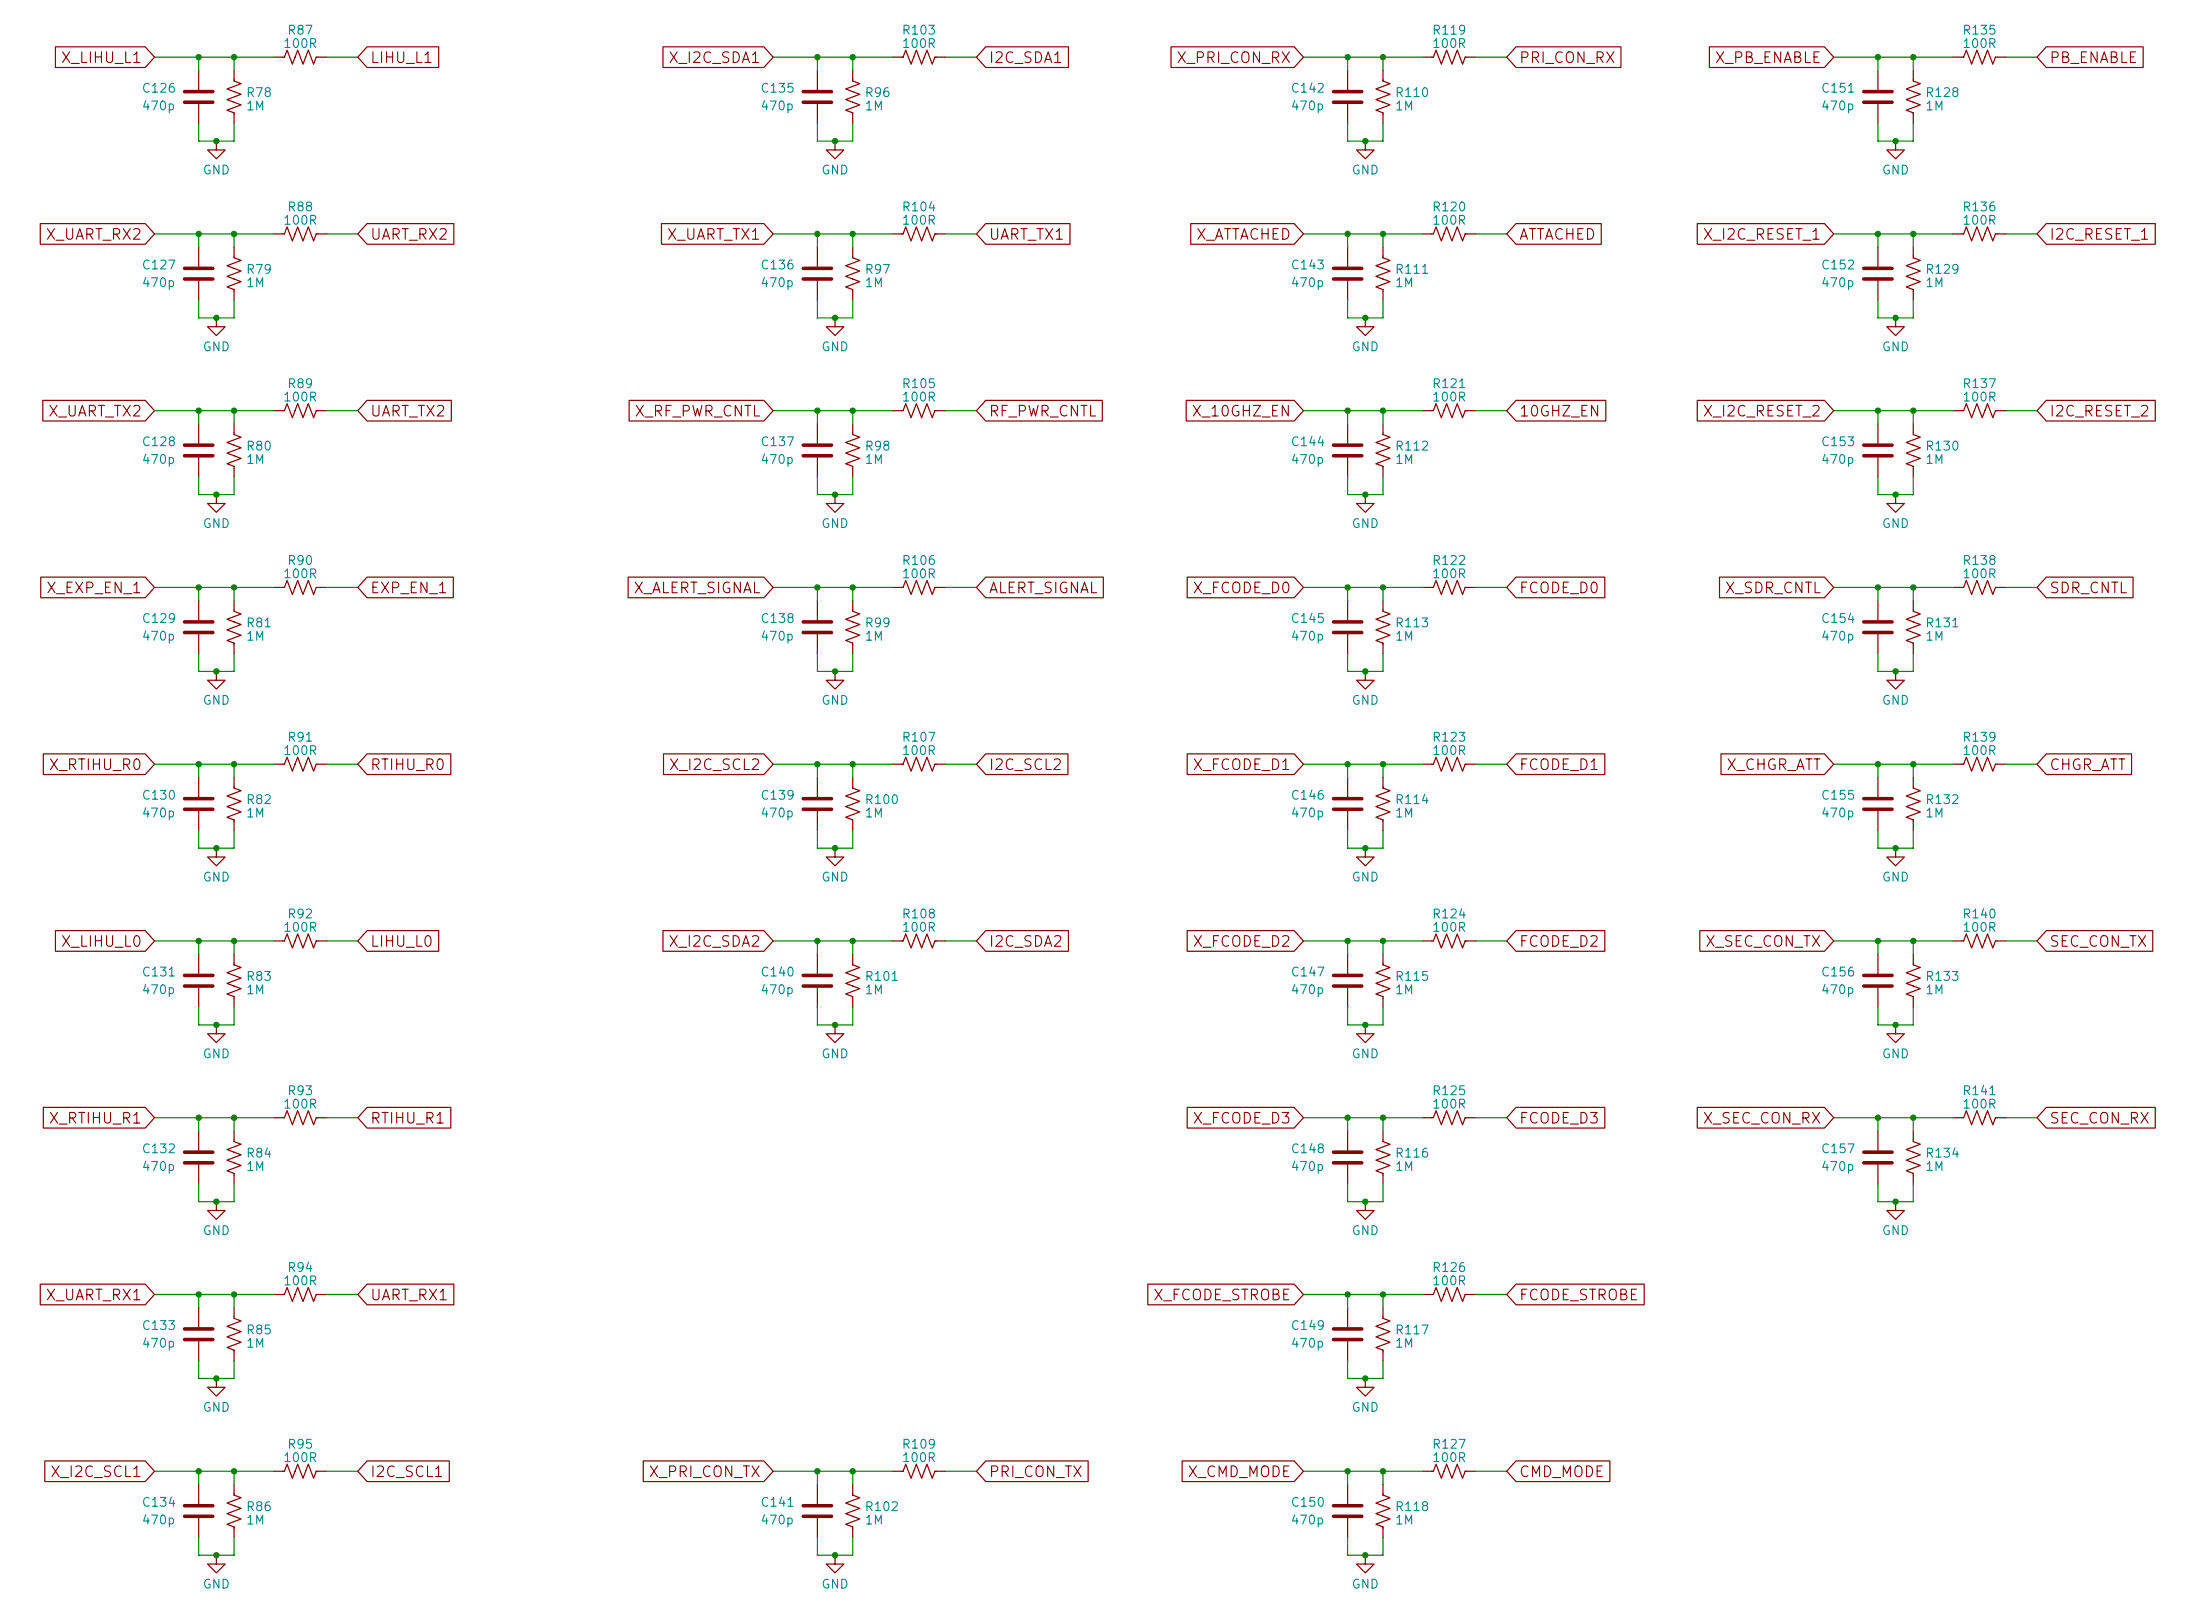
[picture p15: schematic bus_filter.kicad_sch]

Parts:
C126, C127, C128, C129, C130, C131, C132, C133, C134, C135, C136, C137, C138, C139, C140, C141, C142, C143, C144, C145, C146, C147, C148, C149, C150, C151, C152, C153, C154, C155, C156, C157: 470p
R78, R79, R80, R81, R82, R83, R84, R85, R86, R96, R97, R98, R99, R100, R101, R102, R110, R111, R112, R113, R114, R115, R116, R117, R118, R128, R129, R130, R131, R132, R133, R134: 1M
R87, R88, R89, R90, R91, R92, R93, R94, R95, R103, R104, R105, R106, R107, R108, R109, R119, R120, R121, R122, R123, R124, R125, R126, R127, R135, R136, R137, R138, R139, R140, R141: 100R

Connections:
10GHZ_EN: R121.2
ALERT_SIGNAL: R106.1
ATTACHED: R120.2
CHGR_ATT: R139.1
CMD_MODE: R127.2
EXP_EN_1: R90.2
FCODE_D0: R122.2
FCODE_D1: R123.2
FCODE_D2: R124.2
FCODE_D3: R125.2
FCODE_STROBE: R126.2
GND: C126.2, C127.2, C128.2, C129.2, C130.2, C131.2, C132.2, C133.2, C134.2, C135.2, C136.2, C137.2, C138.2, C139.2, C140.2, C141.2, C142.2, C143.2, C144.2, C145.2, C146.2, C147.2, C148.2, C149.2, C150.2, C151.2, C152.2, C153.2, C154.2, C155.2, C156.2, C157.2, R78.2, R79.2, R80.2, R81.2, R82.2, R83.2, R84.2, R85.2, R86.2, R96.1, R97.1, R98.1, R99.1, R100.1, R101.1, R102.1, R110.2, R111.2, R112.2, R113.2, R114.2, R115.2, R116.2, R117.2, R118.2, R128.1, R129.1, R130.1, R131.1, R132.1, R133.1, R134.1
I2C_RESET_1: R136.1
I2C_RESET_2: R137.1
I2C_SCL1: R95.2
I2C_SCL2: R107.1
I2C_SDA1: R103.1
I2C_SDA2: R108.1
LIHU_L0: R92.2
LIHU_L1: R87.2
PB_ENABLE: R135.1
PRI_CON_RX: R119.2
PRI_CON_TX: R109.1
RF_PWR_CNTL: R105.1
RTIHU_R0: R91.2
RTIHU_R1: R93.2
SDR_CNTL: R138.1
SEC_CON_RX: R141.1
SEC_CON_TX: R140.1
UART_RX1: R94.2
UART_RX2: R88.2
UART_TX1: R104.1
UART_TX2: R89.2
X_10GHZ_EN: C144.1, R112.1, R121.1
X_ALERT_SIGNAL: C138.1, R99.2, R106.2
X_ATTACHED: C143.1, R111.1, R120.1
X_CHGR_ATT: C155.1, R132.2, R139.2
X_CMD_MODE: C150.1, R118.1, R127.1
X_EXP_EN_1: C129.1, R81.1, R90.1
X_FCODE_D0: C145.1, R113.1, R122.1
X_FCODE_D1: C146.1, R114.1, R123.1
X_FCODE_D2: C147.1, R115.1, R124.1
X_FCODE_D3: C148.1, R116.1, R125.1
X_FCODE_STROBE: C149.1, R117.1, R126.1
X_I2C_RESET_1: C152.1, R129.2, R136.2
X_I2C_RESET_2: C153.1, R130.2, R137.2
X_I2C_SCL1: C134.1, R86.1, R95.1
X_I2C_SCL2: C139.1, R100.2, R107.2
X_I2C_SDA1: C135.1, R96.2, R103.2
X_I2C_SDA2: C140.1, R101.2, R108.2
X_LIHU_L0: C131.1, R83.1, R92.1
X_LIHU_L1: C126.1, R78.1, R87.1
X_PB_ENABLE: C151.1, R128.2, R135.2
X_PRI_CON_RX: C142.1, R110.1, R119.1
X_PRI_CON_TX: C141.1, R102.2, R109.2
X_RF_PWR_CNTL: C137.1, R98.2, R105.2
X_RTIHU_R0: C130.1, R82.1, R91.1
X_RTIHU_R1: C132.1, R84.1, R93.1
X_SDR_CNTL: C154.1, R131.2, R138.2
X_SEC_CON_RX: C157.1, R134.2, R141.2
X_SEC_CON_TX: C156.1, R133.2, R140.2
X_UART_RX1: C133.1, R85.1, R94.1
X_UART_RX2: C127.1, R79.1, R88.1
X_UART_TX1: C136.1, R97.2, R104.2
X_UART_TX2: C128.1, R80.1, R89.1
