zmetzing/rt-ihu/pcb/bus_switch.kicad_sch

## KiCad design pcb/bus_switch.kicad_sch (2025-01-14)

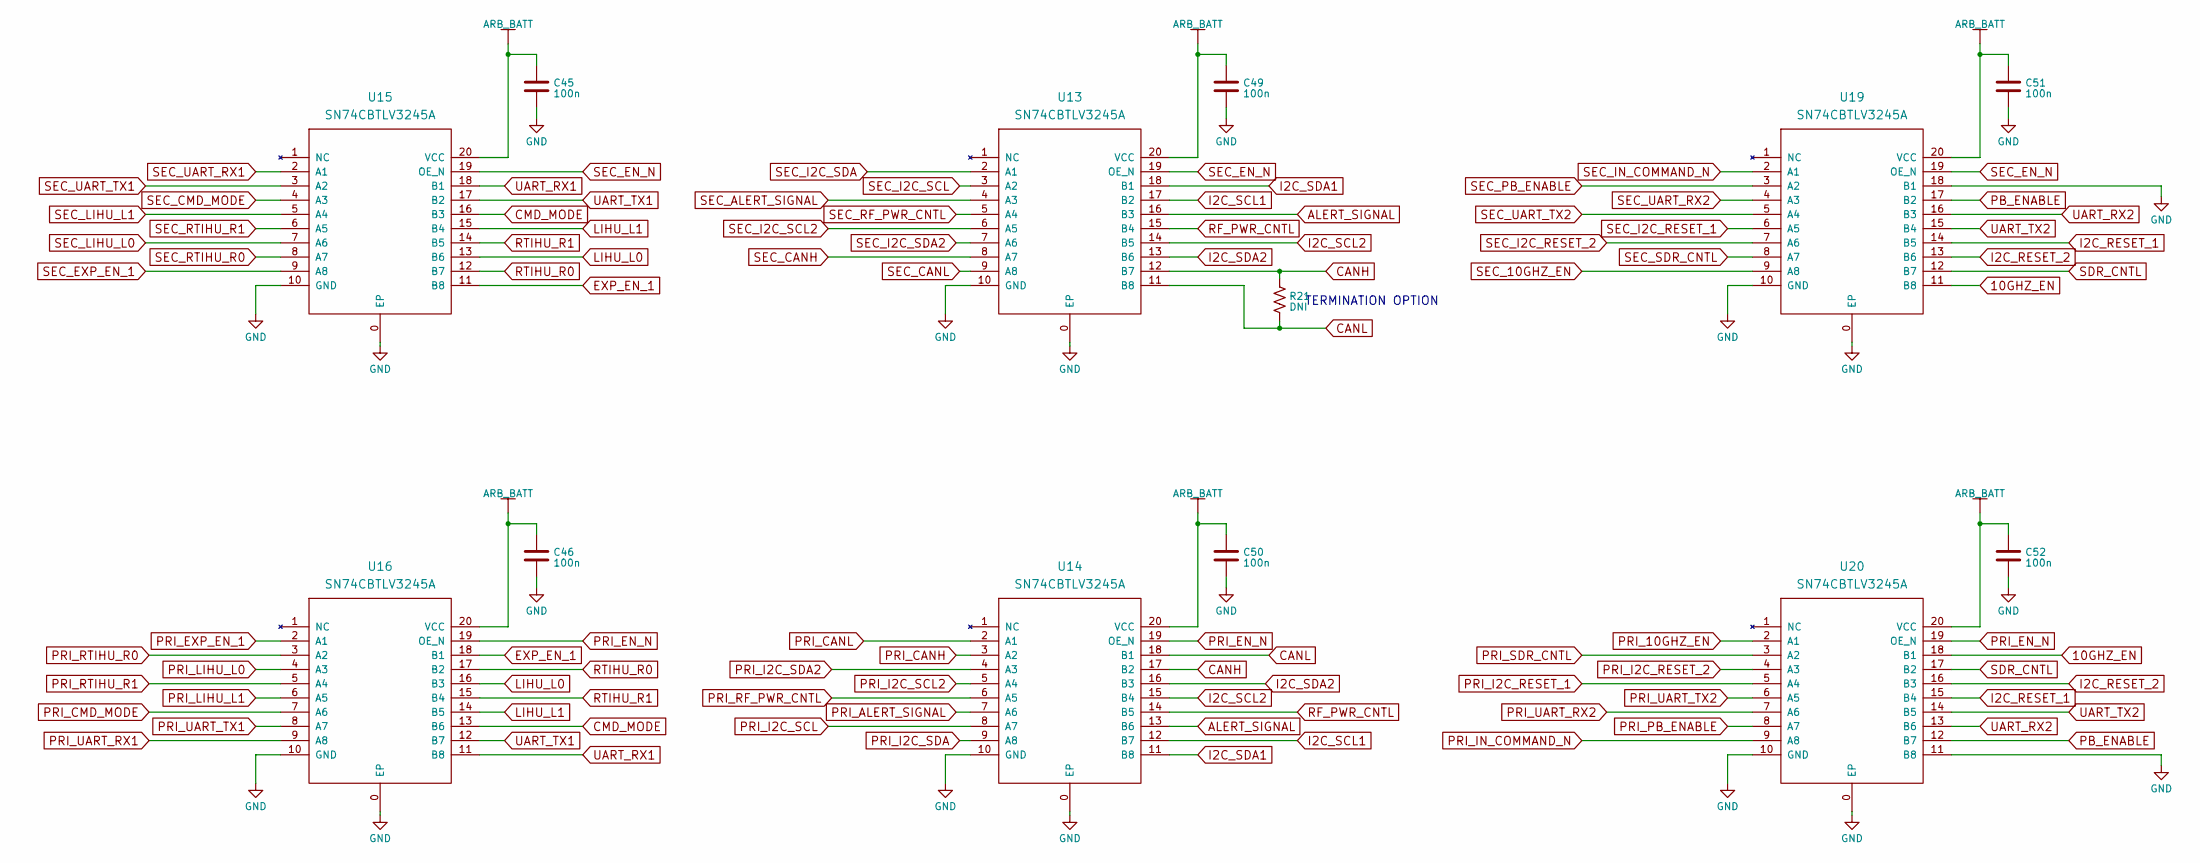
[picture p16: schematic bus_switch.kicad_sch]

Parts:
C45, C46, C49, C50, C51, C52: 100n
R21: DNI
U13, U14, U15, U16, U19, U20: SN74CBTLV3245A

Connections:
10GHZ_EN: U19.11 (B8), U20.18 (B1)
ALERT_SIGNAL: U13.16 (B3), U14.13 (B6)
ARB_BATT: C45.1, C46.1, C49.1, C50.1, C51.1, C52.1, U13.20 (VCC), U14.20 (VCC), U15.20 (VCC), U16.20 (VCC), U19.20 (VCC), U20.20 (VCC)
CANH: R21.1, U13.12 (B7), U14.17 (B2)
CANL: R21.2, U13.11 (B8), U14.18 (B1)
CMD_MODE: U15.16 (B3), U16.13 (B6)
EXP_EN_1: U15.11 (B8), U16.18 (B1)
GND: C45.2, C46.2, C49.2, C50.2, C51.2, C52.2, U13.0 (EP), U13.10 (GND), U14.0 (EP), U14.10 (GND), U15.0 (EP), U15.10 (GND), U16.0 (EP), U16.10 (GND), U19.0 (EP), U19.10 (GND), U19.18 (B1), U20.0 (EP), U20.10 (GND), U20.11 (B8)
I2C_RESET_1: U19.14 (B5), U20.15 (B4)
I2C_RESET_2: U19.13 (B6), U20.16 (B3)
I2C_SCL1: U13.17 (B2), U14.12 (B7)
I2C_SCL2: U13.14 (B5), U14.15 (B4)
I2C_SDA1: U13.18 (B1), U14.11 (B8)
I2C_SDA2: U13.13 (B6), U14.16 (B3)
LIHU_L0: U15.13 (B6), U16.16 (B3)
LIHU_L1: U15.15 (B4), U16.14 (B5)
PB_ENABLE: U19.17 (B2), U20.12 (B7)
PRI_10GHZ_EN: U20.2 (A1)
PRI_ALERT_SIGNAL: U14.7 (A6)
PRI_CANH: U14.3 (A2)
PRI_CANL: U14.2 (A1)
PRI_CMD_MODE: U16.7 (A6)
PRI_EN_N: U14.19 (OE_N), U16.19 (OE_N), U20.19 (OE_N)
PRI_EXP_EN_1: U16.2 (A1)
PRI_I2C_RESET_1: U20.5 (A4)
PRI_I2C_RESET_2: U20.4 (A3)
PRI_I2C_SCL: U14.8 (A7)
PRI_I2C_SCL2: U14.5 (A4)
PRI_I2C_SDA: U14.9 (A8)
PRI_I2C_SDA2: U14.4 (A3)
PRI_IN_COMMAND_N: U20.9 (A8)
PRI_LIHU_L0: U16.4 (A3)
PRI_LIHU_L1: U16.6 (A5)
PRI_PB_ENABLE: U20.8 (A7)
PRI_RF_PWR_CNTL: U14.6 (A5)
PRI_RTIHU_R0: U16.3 (A2)
PRI_RTIHU_R1: U16.5 (A4)
PRI_SDR_CNTL: U20.3 (A2)
PRI_UART_RX1: U16.9 (A8)
PRI_UART_RX2: U20.7 (A6)
PRI_UART_TX1: U16.8 (A7)
PRI_UART_TX2: U20.6 (A5)
RF_PWR_CNTL: U13.15 (B4), U14.14 (B5)
RTIHU_R0: U15.12 (B7), U16.17 (B2)
RTIHU_R1: U15.14 (B5), U16.15 (B4)
SDR_CNTL: U19.12 (B7), U20.17 (B2)
SEC_10GHZ_EN: U19.9 (A8)
SEC_ALERT_SIGNAL: U13.4 (A3)
SEC_CANH: U13.8 (A7)
SEC_CANL: U13.9 (A8)
SEC_CMD_MODE: U15.4 (A3)
SEC_EN_N: U13.19 (OE_N), U15.19 (OE_N), U19.19 (OE_N)
SEC_EXP_EN_1: U15.9 (A8)
SEC_I2C_RESET_1: U19.6 (A5)
SEC_I2C_RESET_2: U19.7 (A6)
SEC_I2C_SCL: U13.3 (A2)
SEC_I2C_SCL2: U13.6 (A5)
SEC_I2C_SDA: U13.2 (A1)
SEC_I2C_SDA2: U13.7 (A6)
SEC_IN_COMMAND_N: U19.2 (A1)
SEC_LIHU_L0: U15.7 (A6)
SEC_LIHU_L1: U15.5 (A4)
SEC_PB_ENABLE: U19.3 (A2)
SEC_RF_PWR_CNTL: U13.5 (A4)
SEC_RTIHU_R0: U15.8 (A7)
SEC_RTIHU_R1: U15.6 (A5)
SEC_SDR_CNTL: U19.8 (A7)
SEC_UART_RX1: U15.2 (A1)
SEC_UART_RX2: U19.4 (A3)
SEC_UART_TX1: U15.3 (A2)
SEC_UART_TX2: U19.5 (A4)
UART_RX1: U15.18 (B1), U16.11 (B8)
UART_RX2: U19.16 (B3), U20.13 (B6)
UART_TX1: U15.17 (B2), U16.12 (B7)
UART_TX2: U19.15 (B4), U20.14 (B5)

Notes on the sheet:
TERMINATION OPTION
