zmetzing/rt-ihu/pcb/primary_ax5043.kicad_sch

## KiCad design pcb/primary_ax5043.kicad_sch (2025-01-14)

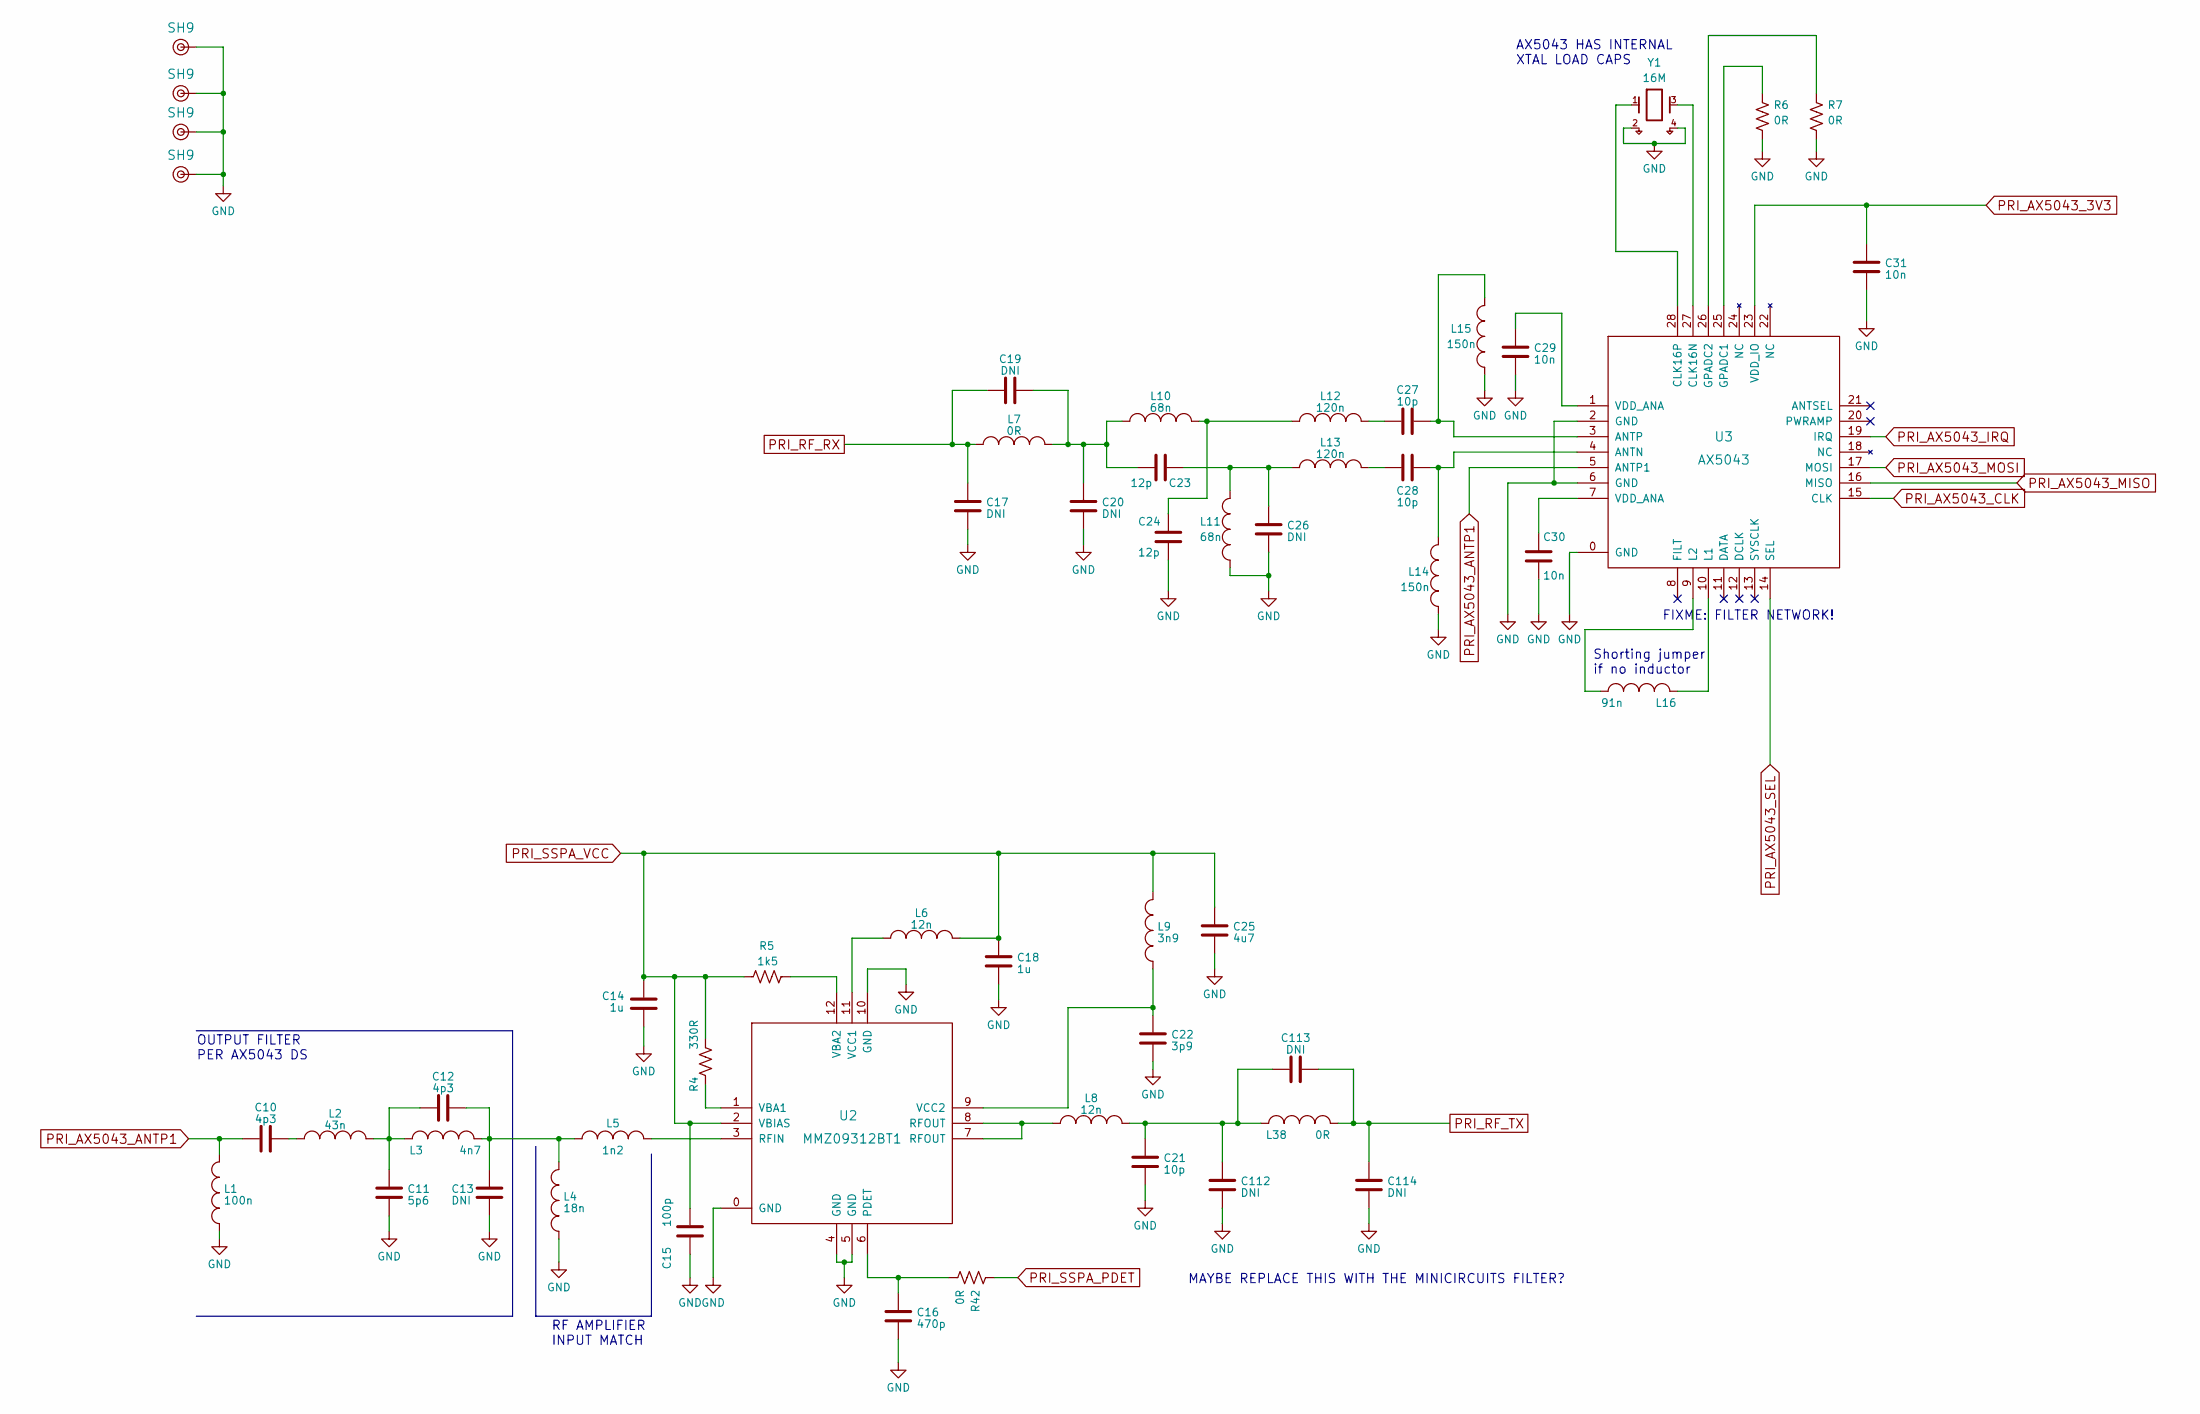
[picture p17: schematic primary_ax5043.kicad_sch]

Parts:
C10, C12: 4p3
C11: 5p6
C13, C17, C19, C20, C26, C112, C113, C114: DNI
C14, C18: 1u
C15: 100p
C16: 470p
C21, C27, C28: 10p
C22: 3p9
C23, C24: 12p
C25: 4u7
C29, C30, C31: 10n
L1: 100n
L2: 43n
L3: 4n7
L4: 18n
L5: 1n2
L6, L8: 12n
L7, L38: 0R
L9: 3n9
L10, L11: 68n
L12, L13: 120n
L14, L15: 150n
L16: 91n
R4: 330R
R5: 1k5
R6, R7, R42: 0R
SH9: (no value)
U2: MMZ09312BT1
U3: AX5043
Y1: 16M

Connections:
GND: C11.2, C13.2, C14.2, C15.2, C16.2, C17.2, C18.2, C20.2, C21.2, C22.2, C24.2, C25.2, C26.2, C29.2, C30.2, C31.2, C112.2, C114.2, L1.1, L4.1, L11.1, L14.1, L15.1, R6.1, R7.1, SH9.1, U2.0 (GND), U2.4 (GND), U2.5 (GND), U2.10 (GND), U3.0 (GND), U3.2 (GND), U3.6 (GND), Y1.2, Y1.4
unnamed: C10.2, L2.1
unnamed: C11.1, C12.1, L2.2, L3.1
unnamed: C12.2, C13.1, L3.2, L4.2, L5.1
unnamed: C16.1, R42.2, U2.6 (PDET)
unnamed: C19.2, C20.1, C23.1, L7.2, L10.1
unnamed: C22.1, L9.1, U2.9 (VCC2)
unnamed: C23.2, C26.1, L11.2, L13.1
unnamed: C24.1, L10.2, L12.1
unnamed: C27.1, L12.2
unnamed: C27.2, L15.2, U3.3 (ANTP)
unnamed: C28.1, L13.2
unnamed: C28.2, L14.2, U3.4 (ANTN)
unnamed: C29.1, U3.1 (VDD_ANA)
unnamed: C30.1, U3.7 (VDD_ANA)
unnamed: C21.1, C112.1, C113.1, L8.2, L38.1
unnamed: L5.2, U2.3 (RFIN)
unnamed: L6.1, U2.11 (VCC1)
unnamed: L8.1, U2.7 (RFOUT), U2.8 (RFOUT)
unnamed: L16.1, U3.9 (L2)
unnamed: L16.2, U3.10 (L1)
unnamed: R4.2, U2.1 (VBA1)
unnamed: R5.2, U2.12 (VBA2)
unnamed: R6.2, U3.25 (GPADC1)
unnamed: R7.2, U3.26 (GPADC2)
unnamed: U3.27 (CLK16N), Y1.3
unnamed: U3.28 (CLK16P), Y1.1
PRI_AX5043_3V3: C31.1, U3.23 (VDD_IO)
PRI_AX5043_ANTP1: C10.1, L1.2, U3.5 (ANTP1)
PRI_AX5043_CLK: U3.15 (CLK)
PRI_AX5043_IRQ: U3.19 (IRQ)
PRI_AX5043_MISO: U3.16 (MISO)
PRI_AX5043_MOSI: U3.17 (MOSI)
PRI_AX5043_SEL: U3.14 (SEL)
PRI_RF_RX: C17.1, C19.1, L7.1
PRI_RF_TX: C113.2, C114.1, L38.2
PRI_SSPA_PDET: R42.1
PRI_SSPA_VCC: C14.1, C15.1, C18.1, C25.1, L6.2, L9.2, R4.1, R5.1, U2.2 (VBIAS)

Notes on the sheet:
Shorting jumper if no inductor
OUTPUT FILTER PER AX5043 DS
FIXME: FILTER NETWORK!
MAYBE REPLACE THIS WITH THE MINICIRCUITS FILTER?
RF AMPLIFIER INPUT MATCH
AX5043 HAS INTERNAL XTAL LOAD CAPS
