zmetzing/rt-ihu/pcb/primary_comm_mem.kicad_sch

## KiCad design pcb/primary_comm_mem.kicad_sch (2025-01-14)

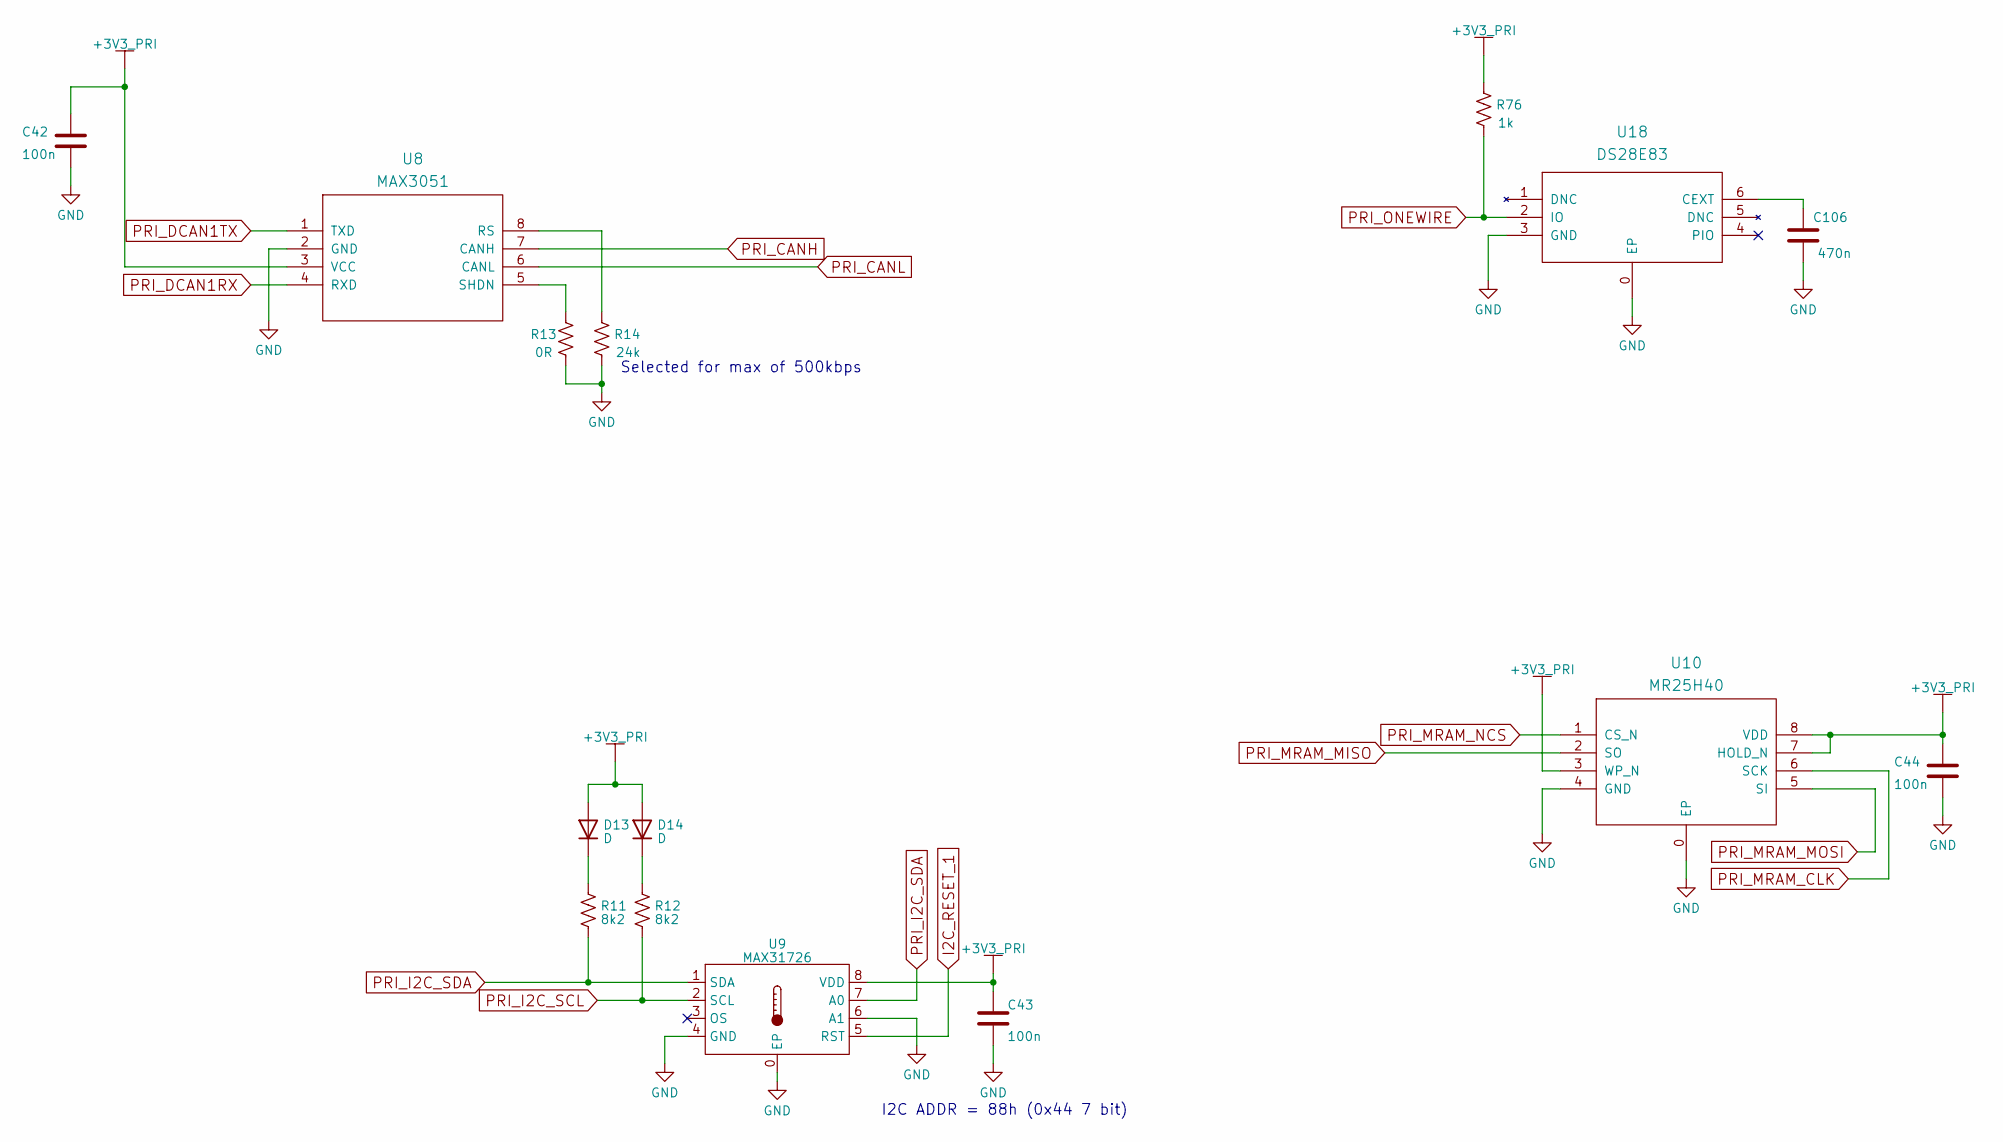
[picture p18: schematic primary_comm_mem.kicad_sch]

Parts:
C42, C43, C44: 100n
C106: 470n
D13, D14: D
R11, R12: 8k2
R13: 0R
R14: 24k
R76: 1k
U8: MAX3051
U9: MAX31726; TDFN8_CP1.58x2.53
U10: MR25H40
U18: DS28E83

Connections:
+3V3_PRI: C42.1, C43.1, C44.1, D13.2 (A), D14.2 (A), R76.1, U8.3 (VCC), U9.8 (VDD), U10.3 (WP_N), U10.7 (HOLD_N), U10.8 (VDD)
GND: C42.2, C43.2, C44.2, C106.2, R13.2, R14.2, U8.2 (GND), U9.0 (EP), U9.4 (GND), U9.6 (A1), U10.0 (EP), U10.4 (GND), U18.0 (EP), U18.3 (GND)
I2C_RESET_1: U9.5 (RST)
unnamed: C106.1, U18.6 (CEXT)
unnamed: D13.1 (K), R11.1
unnamed: D14.1 (K), R12.1
unnamed: R13.1, U8.5 (SHDN)
unnamed: R14.1, U8.8 (RS)
PRI_CANH: U8.7 (CANH)
PRI_CANL: U8.6 (CANL)
PRI_DCAN1RX: U8.4 (RXD)
PRI_DCAN1TX: U8.1 (TXD)
PRI_I2C_SCL: R12.2, U9.2 (SCL)
PRI_I2C_SDA: R11.2, U9.1 (SDA), U9.7 (A0)
PRI_MRAM_CLK: U10.6 (SCK)
PRI_MRAM_MISO: U10.2 (SO)
PRI_MRAM_MOSI: U10.5 (SI)
PRI_MRAM_NCS: U10.1 (CS_N)
PRI_ONEWIRE: R76.2, U18.2 (IO)

Notes on the sheet:
I2C ADDR = 88h (0x44 7 bit)
Selected for max of 500kbps
