zmetzing/rt-ihu/pcb/primary_power.kicad_sch

## KiCad design pcb/primary_power.kicad_sch (2025-01-14)

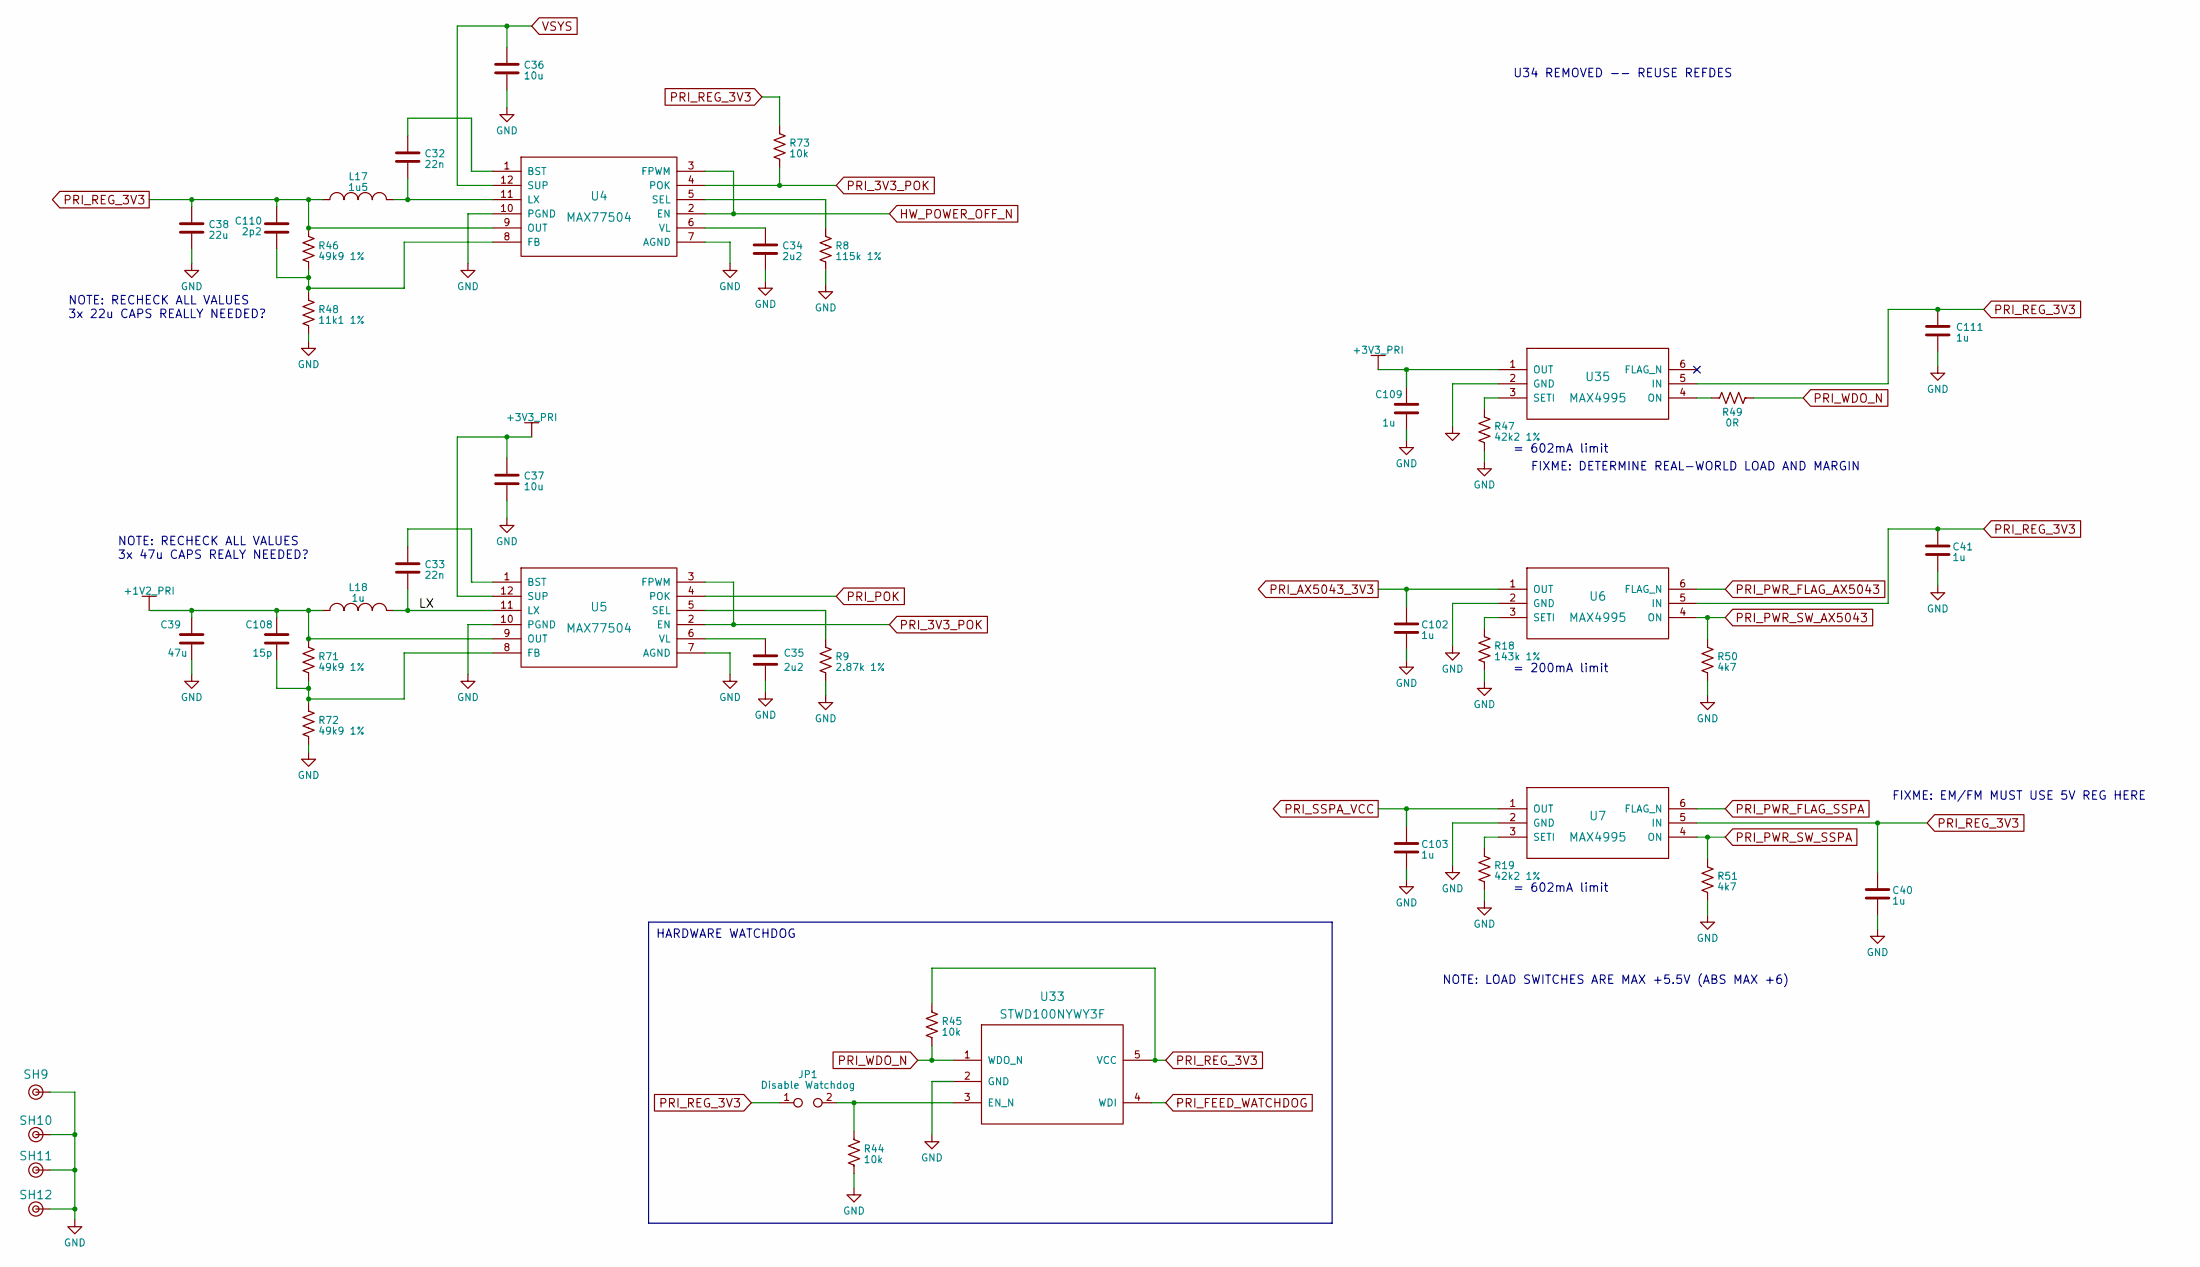
[picture p19: schematic primary_power.kicad_sch]

Parts:
C32, C33: 22n
C34, C35: 2u2
C36, C37: 10u
C38: 22u
C39: 47u
C40, C41, C102, C103, C109, C111: 1u
C108: 15p
C110: 2p2
JP1: Disable Watchdog
L17: 1u5
L18: 1u
R8: 115k 1%
R9: 2.87k 1%
R18: 143k 1%
R19, R47: 42k2 1%
R44, R45, R73: 10k
R46, R71, R72: 49k9 1%
R48: 11k1 1%
R49: 0R
R50, R51: 4k7
SH9, SH10, SH11, SH12: (no value)
U4, U5: MAX77504
U6, U7, U35: MAX4995
U33: STWD100NYWY3F

Connections:
+1V2_PRI: C39.1, C108.1, L18.1, R71.1, U5.9 (OUT)
+3V3_PRI: C37.1, C109.1, U5.12 (SUP), U35.1 (OUT)
GND: C34.2, C35.2, C36.2, C37.2, C38.2, C39.2, C40.2, C41.2, C102.2, C103.2, C109.2, C111.2, R8.2, R9.2, R18.2, R19.2, R44.2, R47.2, R48.2, R50.2, R51.2, R72.2, SH9.1, SH10.1, SH11.1, SH12.1, U4.7 (AGND), U4.10 (PGND), U5.7 (AGND), U5.10 (PGND), U6.2 (GND), U7.2 (GND), U33.2 (GND), U35.2 (GND)
HW_POWER_OFF_N: U4.2 (EN), U4.3 (FPWM)
LX: C33.2, L18.2, U5.11 (LX)
unnamed: C32.1, U4.1 (BST)
unnamed: C32.2, L17.2, U4.11 (LX)
unnamed: C33.1, U5.1 (BST)
unnamed: C34.1, U4.6 (VL)
unnamed: C35.1, U5.6 (VL)
unnamed: C108.2, R71.2, R72.1, U5.8 (FB)
unnamed: C110.2, R46.2, R48.1, U4.8 (FB)
unnamed: JP1.2, R44.1, U33.3 (EN_N)
unnamed: R8.1, U4.5 (SEL)
unnamed: R9.1, U5.5 (SEL)
unnamed: R18.1, U6.3 (SETI)
unnamed: R19.1, U7.3 (SETI)
unnamed: R47.1, U35.3 (SETI)
unnamed: R49.2, U35.4 (ON)
PRI_3V3_POK: R73.2, U4.4 (POK), U5.2 (EN), U5.3 (FPWM)
PRI_AX5043_3V3: C102.1, U6.1 (OUT)
PRI_FEED_WATCHDOG: U33.4 (WDI)
PRI_POK: U5.4 (POK)
PRI_PWR_FLAG_AX5043: U6.6 (FLAG_N)
PRI_PWR_FLAG_SSPA: U7.6 (FLAG_N)
PRI_PWR_SW_AX5043: R50.1, U6.4 (ON)
PRI_PWR_SW_SSPA: R51.1, U7.4 (ON)
PRI_REG_3V3: C38.1, C40.1, C41.1, C110.1, C111.1, JP1.1, L17.1, R45.1, R46.1, R73.1, U4.9 (OUT), U6.5 (IN), U7.5 (IN), U33.5 (VCC), U35.5 (IN)
PRI_SSPA_VCC: C103.1, U7.1 (OUT)
PRI_WDO_N: R45.2, R49.1, U33.1 (WDO_N)
VSYS: C36.1, U4.12 (SUP)

Notes on the sheet:
U34 REMOVED -- REUSE REFDES
FIXME: EM/FM MUST USE 5V REG HERE
NOTE: LOAD SWITCHES ARE MAX +5.5V (ABS MAX +6)
HARDWARE WATCHDOG
= 200mA limit
FIXME: DETERMINE REAL-WORLD LOAD AND MARGIN
NOTE: RECHECK ALL VALUES 3x 47u CAPS REALY NEEDED?
= 602mA limit
NOTE: RECHECK ALL VALUES 3x 22u CAPS REALLY NEEDED?
