zmetzing/rt-ihu/pcb/primary_tms570.kicad_sch

## KiCad design pcb/primary_tms570.kicad_sch (2025-01-14)

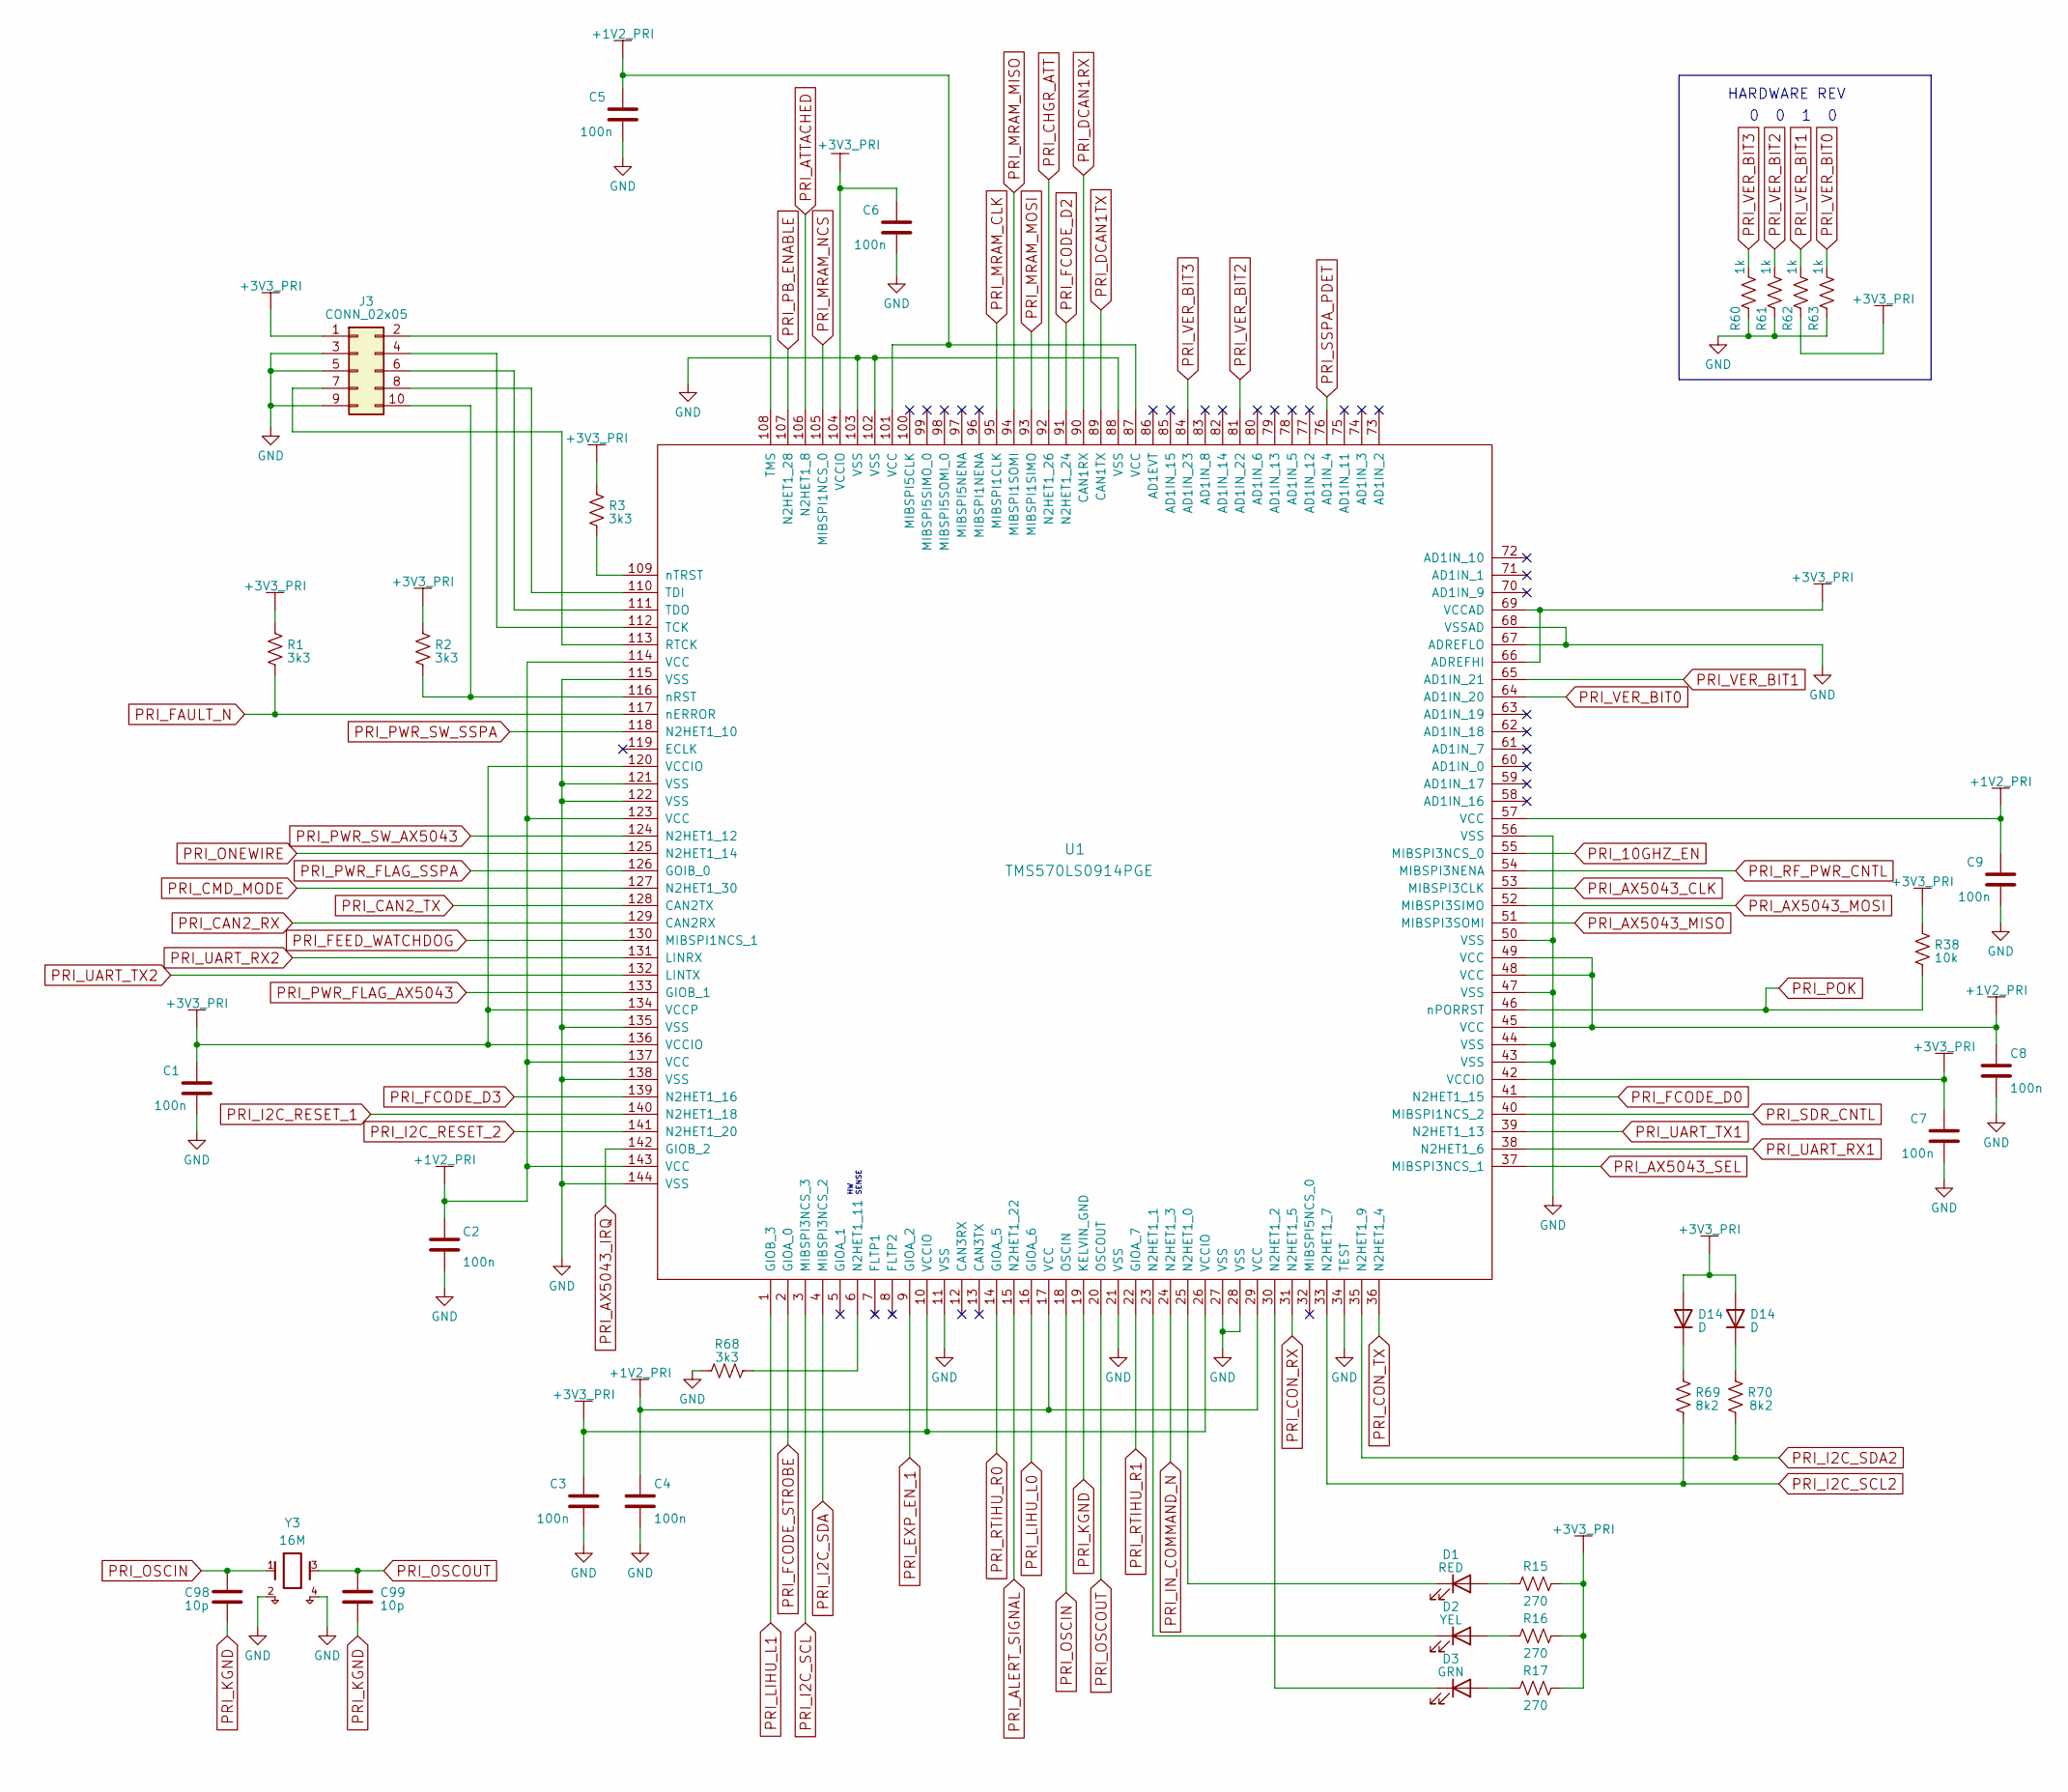
[picture p20: schematic primary_tms570.kicad_sch]

Parts:
C1, C2, C3, C4, C5, C6, C7, C8, C9: 100n
C98, C99: 10p
D1: RED
D2: YEL
D3: GRN
D14: D
J3: CONN_02x05
R1, R2, R3, R68: 3k3
R15, R16, R17: 270
R38: 10k
R60, R61, R62, R63: 1k
R69, R70: 8k2
U1: TMS570LS0914PGE
Y3: 16M

Connections:
+1V2_PRI: C2.1, C4.1, C5.1, C8.1, C9.1, U1.17 (VCC), U1.29 (VCC), U1.45 (VCC), U1.48 (VCC), U1.49 (VCC), U1.57 (VCC), U1.87 (VCC), U1.101 (VCC), U1.114 (VCC), U1.123 (VCC), U1.137 (VCC), U1.143 (VCC)
+3V3_PRI: C1.1, C3.1, C6.1, C7.1, D14.2 (A), J3.1, R1.1, R2.1, R3.1, R15.2, R16.2, R17.2, R38.1, R62.2, U1.10 (VCCIO), U1.26 (VCCIO), U1.42 (VCCIO), U1.66 (ADREFHI), U1.69 (VCCAD), U1.104 (VCCIO), U1.120 (VCCIO), U1.134 (VCCP), U1.136 (VCCIO)
GND: C1.2, C2.2, C3.2, C4.2, C5.2, C6.2, C7.2, C8.2, C9.2, J3.3, J3.5, J3.9, R60.2, R61.2, R63.2, R68.1, U1.11 (VSS), U1.21 (VSS), U1.27 (VSS), U1.28 (VSS), U1.34 (TEST), U1.43 (VSS), U1.44 (VSS), U1.47 (VSS), U1.50 (VSS), U1.56 (VSS), U1.67 (ADREFLO), U1.68 (VSSAD), U1.88 (VSS), U1.102 (VSS), U1.103 (VSS), U1.115 (VSS), U1.121 (VSS), U1.122 (VSS), U1.135 (VSS), U1.138 (VSS), U1.144 (VSS), Y3.2, Y3.4
unnamed: D1.1 (K), U1.25 (N2HET1_0)
unnamed: D1.2 (A), R15.1
unnamed: D2.1 (K), U1.23 (N2HET1_1)
unnamed: D2.2 (A), R16.1
unnamed: D3.1 (K), U1.30 (N2HET1_2)
unnamed: D3.2 (A), R17.1
unnamed: D14.1 (K), R69.1, R70.1
unnamed: J3.2, U1.108 (TMS)
unnamed: J3.4, U1.112 (TCK)
unnamed: J3.6, U1.111 (TDO)
unnamed: J3.7, U1.113 (RTCK)
unnamed: J3.8, U1.110 (TDI)
unnamed: J3.10, R2.2, U1.116 (nRST)
unnamed: R3.2, U1.109 (nTRST)
unnamed: R68.2, U1.6 (N2HET1_11)
PRI_10GHZ_EN: U1.55 (MIBSPI3NCS_0)
PRI_ALERT_SIGNAL: U1.15 (N2HET1_22)
PRI_ATTACHED: U1.106 (N2HET1_8)
PRI_AX5043_CLK: U1.53 (MIBSPI3CLK)
PRI_AX5043_IRQ: U1.142 (GIOB_2)
PRI_AX5043_MISO: U1.51 (MIBSPI3SOMI)
PRI_AX5043_MOSI: U1.52 (MIBSPI3SIMO)
PRI_AX5043_SEL: U1.37 (MIBSPI3NCS_1)
PRI_CAN2_RX: U1.129 (CAN2RX)
PRI_CAN2_TX: U1.128 (CAN2TX)
PRI_CHGR_ATT: U1.92 (N2HET1_26)
PRI_CMD_MODE: U1.127 (N2HET1_30)
PRI_CON_RX: U1.31 (N2HET1_5)
PRI_CON_TX: U1.36 (N2HET1_4)
PRI_DCAN1RX: U1.90 (CAN1RX)
PRI_DCAN1TX: U1.89 (CAN1TX)
PRI_EXP_EN_1: U1.9 (GIOA_2)
PRI_FAULT_N: R1.2, U1.117 (nERROR)
PRI_FCODE_D0: U1.41 (N2HET1_15)
PRI_FCODE_D2: U1.91 (N2HET1_24)
PRI_FCODE_D3: U1.139 (N2HET1_16)
PRI_FCODE_STROBE: U1.2 (GIOA_0)
PRI_FEED_WATCHDOG: U1.130 (MIBSPI1NCS_1)
PRI_I2C_RESET_1: U1.140 (N2HET1_18)
PRI_I2C_RESET_2: U1.141 (N2HET1_20)
PRI_I2C_SCL: U1.3 (MIBSPI3NCS_3)
PRI_I2C_SCL2: R69.2, U1.33 (N2HET1_7)
PRI_I2C_SDA: U1.4 (MIBSPI3NCS_2)
PRI_I2C_SDA2: R70.2, U1.35 (N2HET1_9)
PRI_IN_COMMAND_N: U1.24 (N2HET1_3)
PRI_KGND: C98.2, C99.2, U1.19 (KELVIN_GND)
PRI_LIHU_L0: U1.16 (GIOA_6)
PRI_LIHU_L1: U1.1 (GIOB_3)
PRI_MRAM_CLK: U1.95 (MIBSPI1CLK)
PRI_MRAM_MISO: U1.94 (MIBSPI1SOMI)
PRI_MRAM_MOSI: U1.93 (MIBSPI1SIMO)
PRI_MRAM_NCS: U1.105 (MIBSPI1NCS_0)
PRI_ONEWIRE: U1.125 (N2HET1_14)
PRI_OSCIN: C98.1, U1.18 (OSCIN), Y3.1
PRI_OSCOUT: C99.1, U1.20 (OSCOUT), Y3.3
PRI_PB_ENABLE: U1.107 (N2HET1_28)
PRI_POK: R38.2, U1.46 (nPORRST)
PRI_PWR_FLAG_AX5043: U1.133 (GIOB_1)
PRI_PWR_FLAG_SSPA: U1.126 (GOIB_0)
PRI_PWR_SW_AX5043: U1.124 (N2HET1_12)
PRI_PWR_SW_SSPA: U1.118 (N2HET1_10)
PRI_RF_PWR_CNTL: U1.54 (MIBSPI3NENA)
PRI_RTIHU_R0: U1.14 (GIOA_5)
PRI_RTIHU_R1: U1.22 (GIOA_7)
PRI_SDR_CNTL: U1.40 (MIBSPI1NCS_2)
PRI_SSPA_PDET: U1.76 (AD1IN_4)
PRI_UART_RX1: U1.38 (N2HET1_6)
PRI_UART_RX2: U1.131 (LINRX)
PRI_UART_TX1: U1.39 (N2HET1_13)
PRI_UART_TX2: U1.132 (LINTX)
PRI_VER_BIT0: R63.1, U1.64 (AD1IN_20)
PRI_VER_BIT1: R62.1, U1.65 (AD1IN_21)
PRI_VER_BIT2: R61.1, U1.81 (AD1IN_22)
PRI_VER_BIT3: R60.1, U1.84 (AD1IN_23)

Notes on the sheet:
HARDWARE REV
HW SENSE
