zmetzing/rt-ihu/pcb/rtihu.kicad_sch

## KiCad design pcb/rtihu.kicad_sch (2025-01-14)

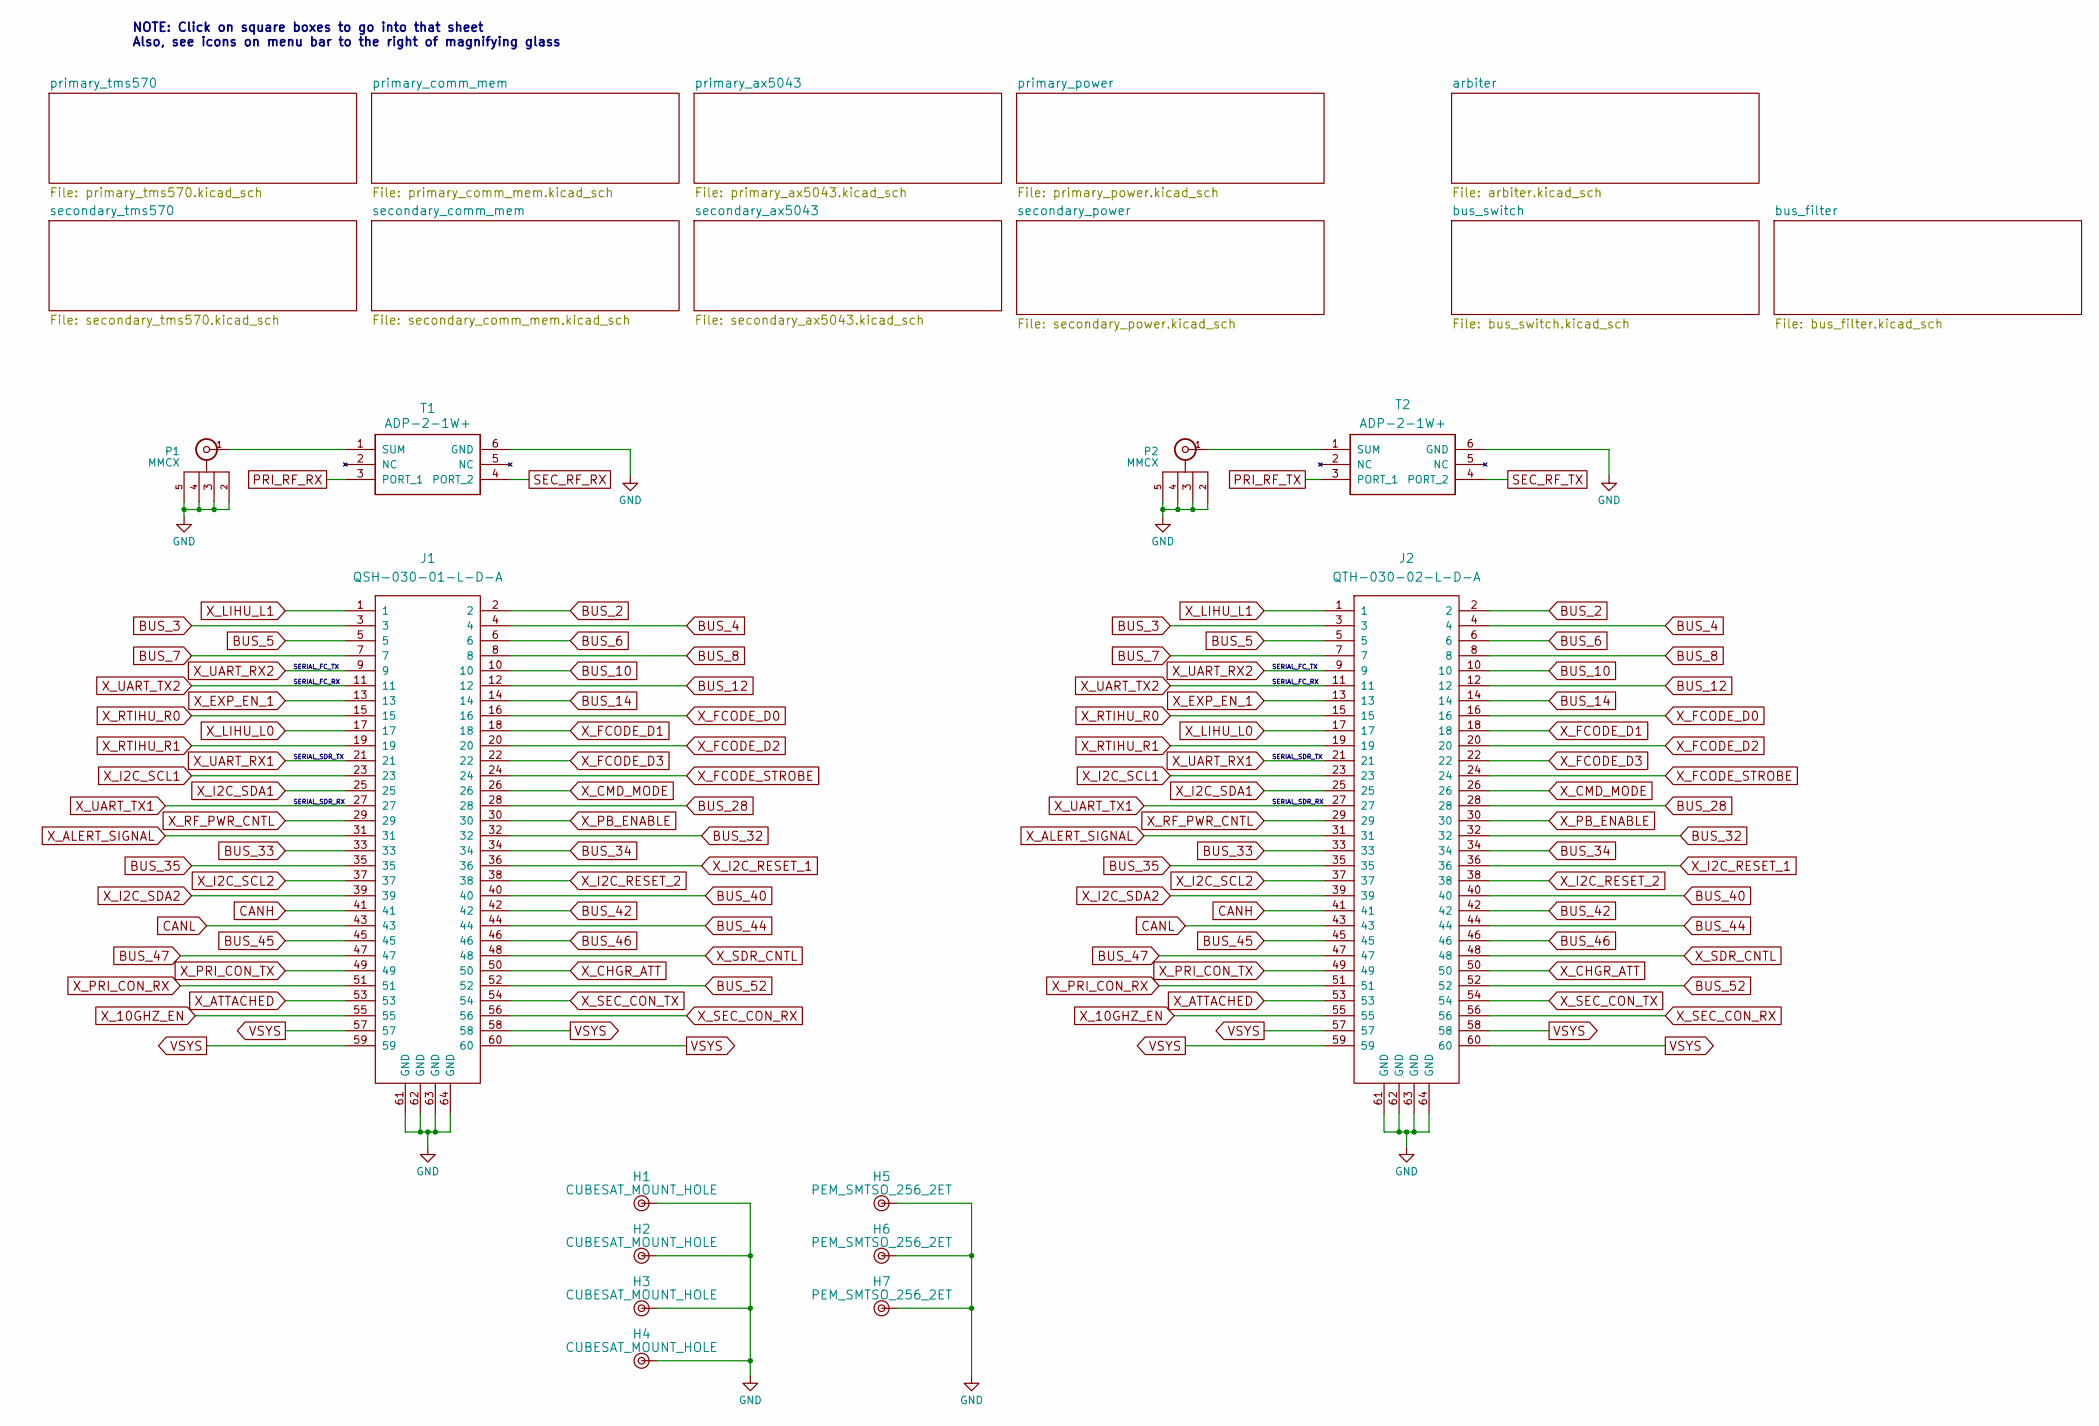
[picture p21: schematic rtihu.kicad_sch]

Parts:
H1, H2, H3, H4: CUBESAT_MOUNT_HOLE
H5, H6, H7: PEM_SMTSO_256_2ET
J1: QSH-030-01-L-D-A
J2: QTH-030-02-L-D-A
P1, P2: MMCX
T1, T2: ADP-2-1W+

Connections:
BUS_2: J1.2, J2.2
BUS_3: J1.3, J2.3
BUS_4: J1.4, J2.4
BUS_5: J1.5, J2.5
BUS_6: J1.6, J2.6
BUS_7: J1.7, J2.7
BUS_8: J1.8, J2.8
BUS_10: J1.10, J2.10
BUS_12: J1.12, J2.12
BUS_14: J1.14, J2.14
BUS_28: J1.28, J2.28
BUS_32: J1.32, J2.32
BUS_33: J1.33, J2.33
BUS_34: J1.34, J2.34
BUS_35: J1.35, J2.35
BUS_40: J1.40, J2.40
BUS_42: J1.42, J2.42
BUS_44: J1.44, J2.44
BUS_45: J1.45, J2.45
BUS_46: J1.46, J2.46
BUS_47: J1.47, J2.47
BUS_52: J1.52, J2.52
CANH: J1.41, J2.41
CANL: J1.43, J2.43
GND: H1.1, H2.1, H3.1, H4.1, H5.1, H6.1, H7.1, J1.61 (GND), J1.62 (GND), J1.63 (GND), J1.64 (GND), J2.61 (GND), J2.62 (GND), J2.63 (GND), J2.64 (GND), P1.2 (Body), P1.3, P1.4, P1.5, P2.2 (Body), P2.3, P2.4, P2.5, T1.6 (GND), T2.6 (GND)
unnamed: P1.1 (In), T1.1 (SUM)
unnamed: P2.1 (In), T2.1 (SUM)
PRI_RF_RX: T1.3 (PORT_1)
PRI_RF_TX: T2.3 (PORT_1)
SEC_RF_RX: T1.4 (PORT_2)
SEC_RF_TX: T2.4 (PORT_2)
VSYS: J1.57, J1.58, J1.59, J1.60, J2.57, J2.58, J2.59, J2.60
X_10GHZ_EN: J1.55, J2.55
X_ALERT_SIGNAL: J1.31, J2.31
X_ATTACHED: J1.53, J2.53
X_CHGR_ATT: J1.50, J2.50
X_CMD_MODE: J1.26, J2.26
X_EXP_EN_1: J1.13, J2.13
X_FCODE_D0: J1.16, J2.16
X_FCODE_D1: J1.18, J2.18
X_FCODE_D2: J1.20, J2.20
X_FCODE_D3: J1.22, J2.22
X_FCODE_STROBE: J1.24, J2.24
X_I2C_RESET_1: J1.36, J2.36
X_I2C_RESET_2: J1.38, J2.38
X_I2C_SCL1: J1.23, J2.23
X_I2C_SCL2: J1.37, J2.37
X_I2C_SDA1: J1.25, J2.25
X_I2C_SDA2: J1.39, J2.39
X_LIHU_L0: J1.17, J2.17
X_LIHU_L1: J1.1, J2.1
X_PB_ENABLE: J1.30, J2.30
X_PRI_CON_RX: J1.51, J2.51
X_PRI_CON_TX: J1.49, J2.49
X_RF_PWR_CNTL: J1.29, J2.29
X_RTIHU_R0: J1.15, J2.15
X_RTIHU_R1: J1.19, J2.19
X_SDR_CNTL: J1.48, J2.48
X_SEC_CON_RX: J1.56, J2.56
X_SEC_CON_TX: J1.54, J2.54
X_UART_RX1: J1.21, J2.21
X_UART_RX2: J1.9, J2.9
X_UART_TX1: J1.27, J2.27
X_UART_TX2: J1.11, J2.11

Notes on the sheet:
SERIAL_SDR_TX
SERIAL_SDR_RX
SERIAL_FC_RX
SERIAL_FC_TX
NOTE: Click on square boxes to go into that sheet Also, see icons on menu bar to the right of magnifying glass
