zmetzing/rt-ihu/pcb/secondary_ax5043.kicad_sch

## KiCad design pcb/secondary_ax5043.kicad_sch (2025-01-14)

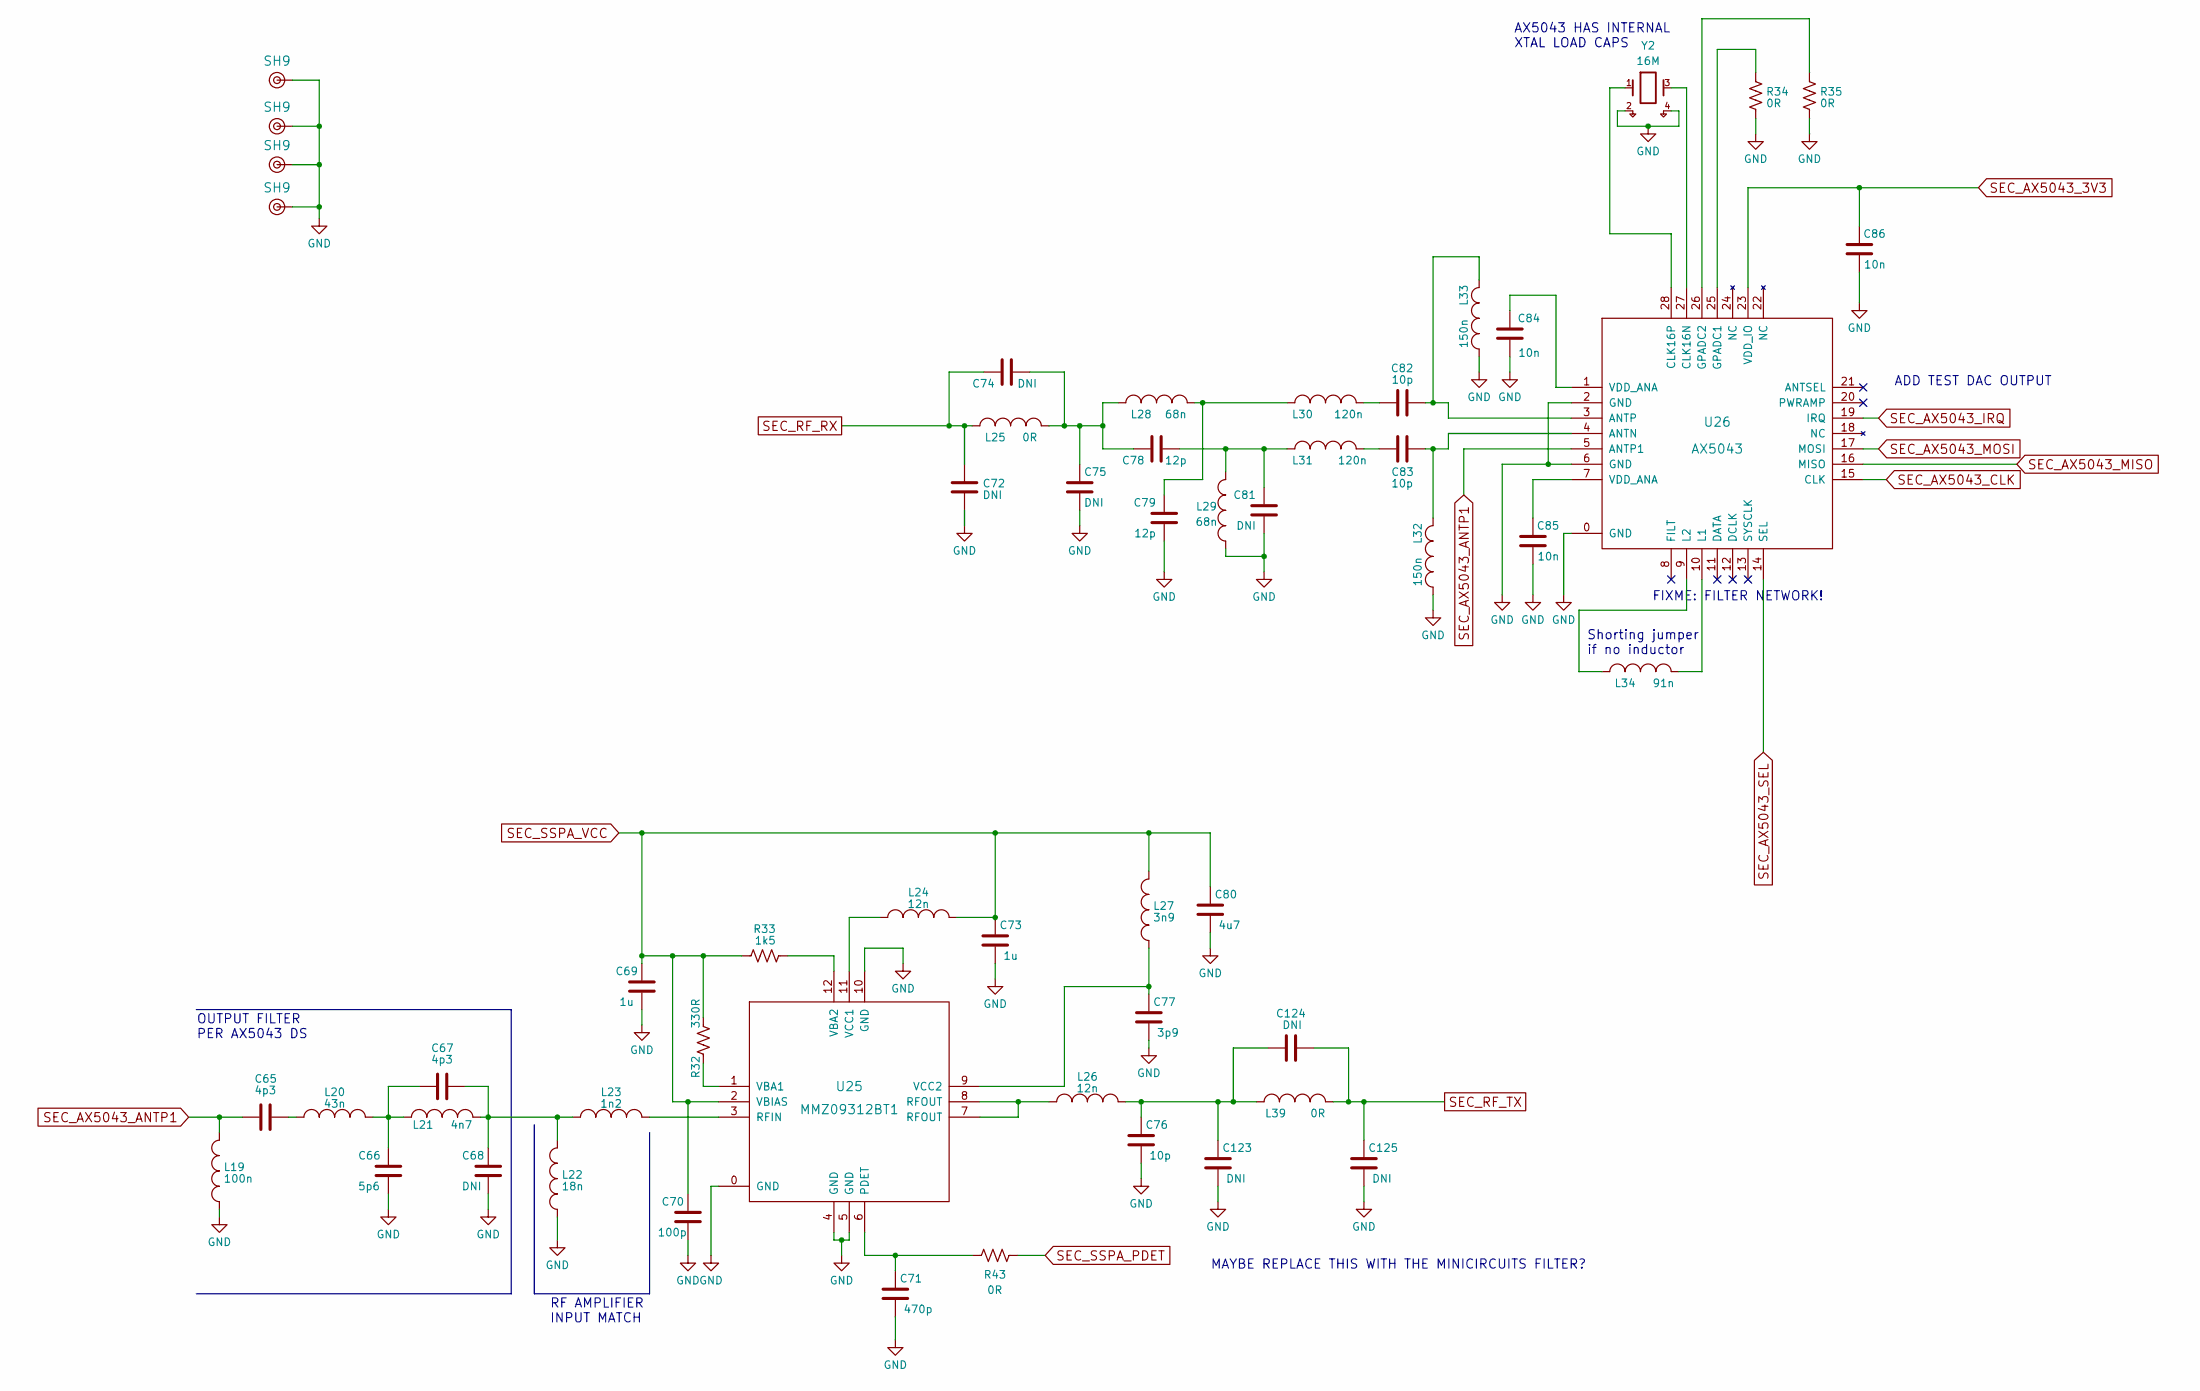
[picture p22: schematic secondary_ax5043.kicad_sch]

Parts:
C65, C67: 4p3
C66: 5p6
C68, C72, C74, C75, C81, C123, C124, C125: DNI
C69, C73: 1u
C70: 100p
C71: 470p
C76, C82, C83: 10p
C77: 3p9
C78, C79: 12p
C80: 4u7
C84, C85, C86: 10n
L19: 100n
L20: 43n
L21: 4n7
L22: 18n
L23: 1n2
L24, L26: 12n
L25, L39: 0R
L27: 3n9
L28, L29: 68n
L30, L31: 120n
L32, L33: 150n
L34: 91n
R32: 330R
R33: 1k5
R34, R35, R43: 0R
SH9: (no value)
U25: MMZ09312BT1
U26: AX5043
Y2: 16M

Connections:
GND: C66.2, C68.2, C69.2, C70.2, C71.2, C72.2, C73.2, C75.2, C76.2, C77.2, C79.1, C80.2, C81.1, C84.1, C85.1, C86.1, C123.2, C125.2, L19.1, L22.1, L29.1, L32.1, L33.1, R34.2, R35.2, SH9.1, U25.0 (GND), U25.4 (GND), U25.5 (GND), U25.10 (GND), U26.0 (GND), U26.2 (GND), U26.6 (GND), Y2.2, Y2.4
unnamed: C65.1, L20.1
unnamed: C66.1, C67.2, L20.2, L21.1
unnamed: C67.1, C68.1, L21.2, L22.2, L23.1
unnamed: C71.1, R43.1, U25.6 (PDET)
unnamed: C74.2, C75.1, C78.1, L25.2, L28.1
unnamed: C77.1, L27.1, U25.9 (VCC2)
unnamed: C78.2, C81.2, L29.2, L31.1
unnamed: C79.2, L28.2, L30.1
unnamed: C82.1, L30.2
unnamed: C82.2, L33.2, U26.3 (ANTP)
unnamed: C83.1, L32.2, U26.4 (ANTN)
unnamed: C83.2, L31.2
unnamed: C84.2, U26.1 (VDD_ANA)
unnamed: C85.2, U26.7 (VDD_ANA)
unnamed: C76.1, C123.1, C124.1, L26.2, L39.1
unnamed: L23.2, U25.3 (RFIN)
unnamed: L24.1, U25.11 (VCC1)
unnamed: L26.1, U25.7 (RFOUT), U25.8 (RFOUT)
unnamed: L34.1, U26.9 (L2)
unnamed: L34.2, U26.10 (L1)
unnamed: R32.2, U25.1 (VBA1)
unnamed: R33.2, U25.12 (VBA2)
unnamed: R34.1, U26.25 (GPADC1)
unnamed: R35.1, U26.26 (GPADC2)
unnamed: U26.27 (CLK16N), Y2.3
unnamed: U26.28 (CLK16P), Y2.1
SEC_AX5043_3V3: C86.2, U26.23 (VDD_IO)
SEC_AX5043_ANTP1: C65.2, L19.2, U26.5 (ANTP1)
SEC_AX5043_CLK: U26.15 (CLK)
SEC_AX5043_IRQ: U26.19 (IRQ)
SEC_AX5043_MISO: U26.16 (MISO)
SEC_AX5043_MOSI: U26.17 (MOSI)
SEC_AX5043_SEL: U26.14 (SEL)
SEC_RF_RX: C72.1, C74.1, L25.1
SEC_RF_TX: C124.2, C125.1, L39.2
SEC_SSPA_PDET: R43.2
SEC_SSPA_VCC: C69.1, C70.1, C73.1, C80.1, L24.2, L27.2, R32.1, R33.1, U25.2 (VBIAS)

Notes on the sheet:
FIXME: FILTER NETWORK!
RF AMPLIFIER INPUT MATCH
AX5043 HAS INTERNAL XTAL LOAD CAPS
ADD TEST DAC OUTPUT
Shorting jumper if no inductor
MAYBE REPLACE THIS WITH THE MINICIRCUITS FILTER?
OUTPUT FILTER PER AX5043 DS
