zmetzing/rt-ihu/pcb/secondary_comm_mem.kicad_sch

## KiCad design pcb/secondary_comm_mem.kicad_sch (2025-01-14)

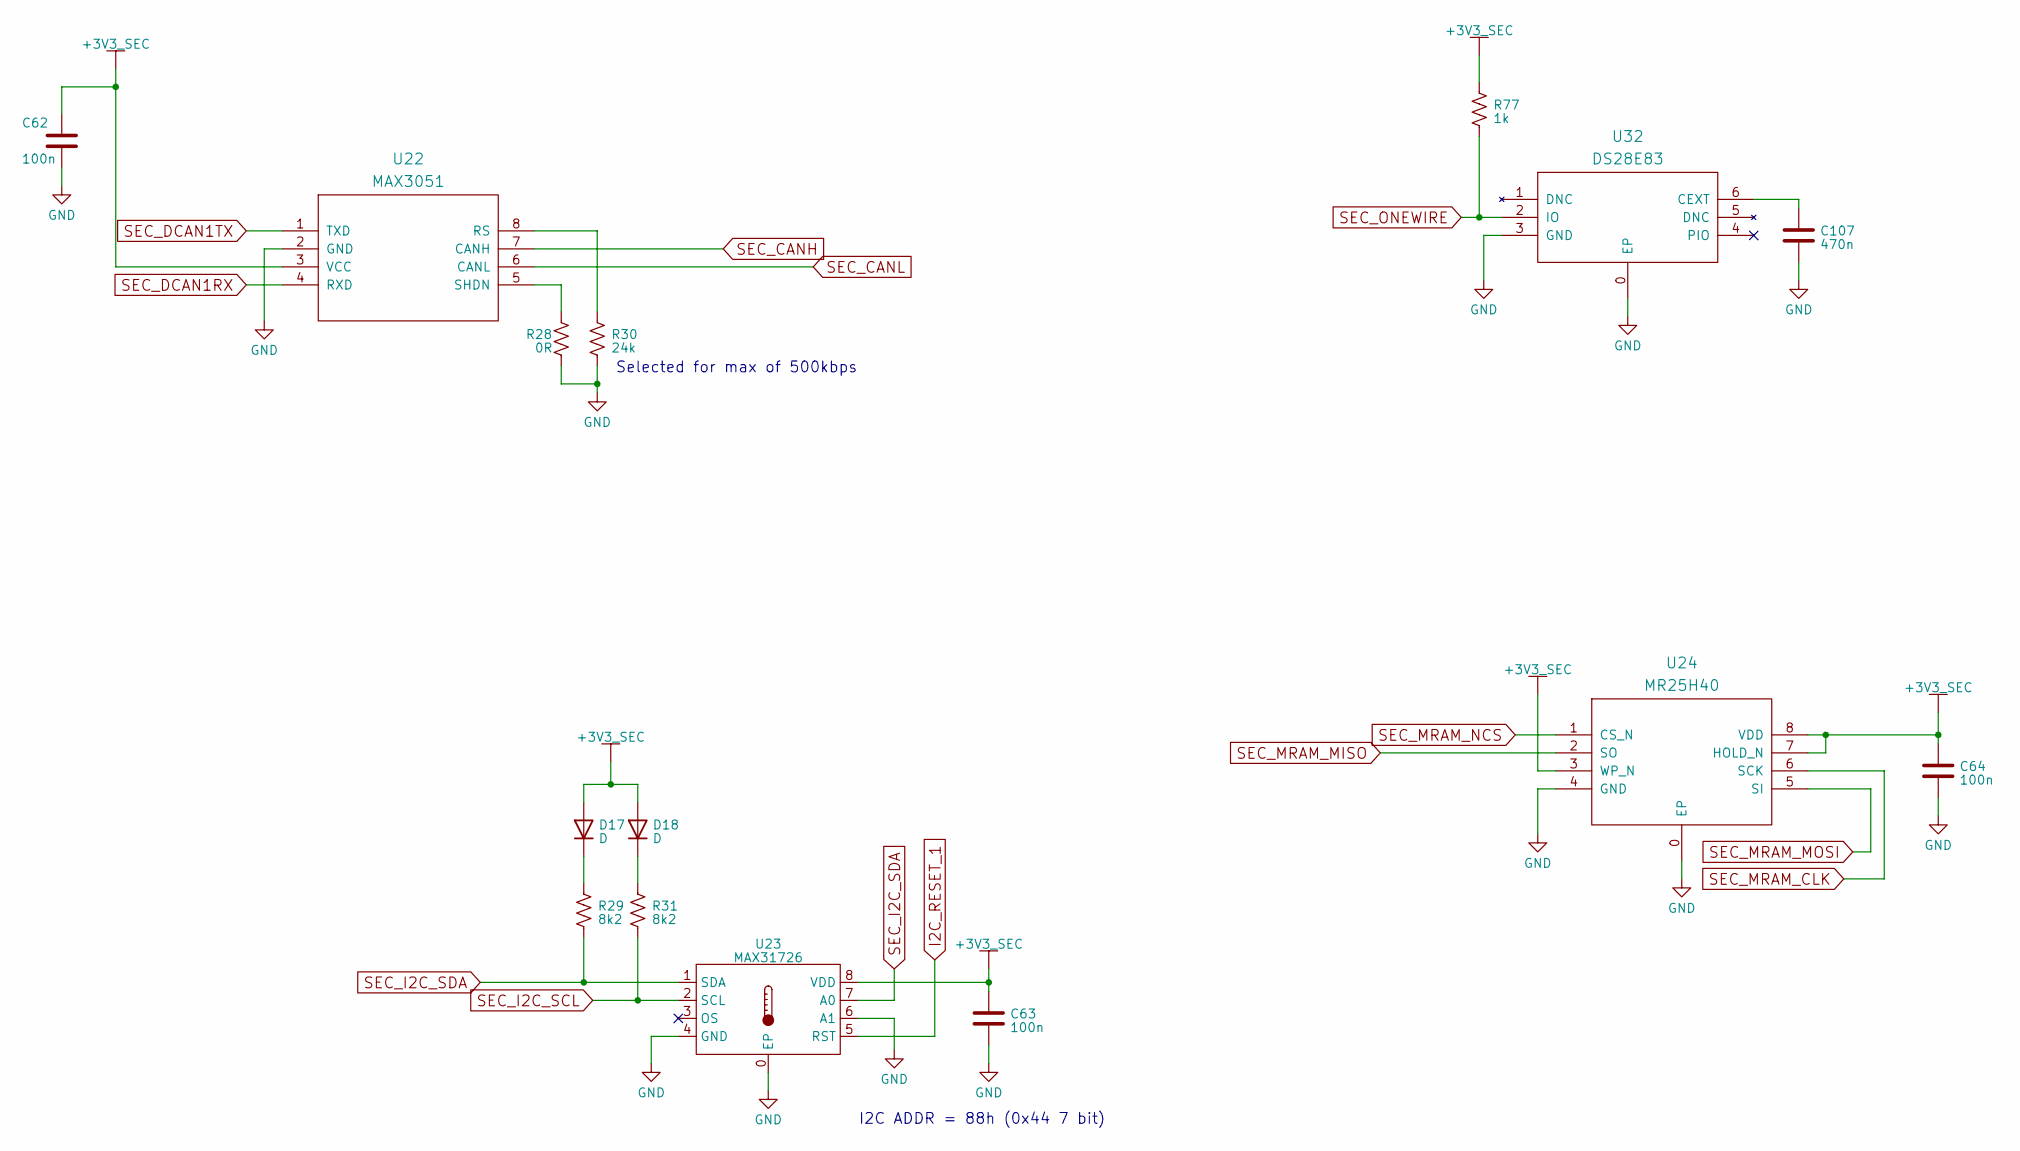
[picture p23: schematic secondary_comm_mem.kicad_sch]

Parts:
C62, C63, C64: 100n
C107: 470n
D17, D18: D
R28: 0R
R29, R31: 8k2
R30: 24k
R77: 1k
U22: MAX3051
U23: MAX31726; TDFN_T833_2
U24: MR25H40
U32: DS28E83

Connections:
+3V3_SEC: C62.1, C63.1, C64.1, D17.2 (A), D18.2 (A), R77.1, U22.3 (VCC), U23.8 (VDD), U24.3 (WP_N), U24.7 (HOLD_N), U24.8 (VDD)
GND: C62.2, C63.2, C64.2, C107.2, R28.2, R30.2, U22.2 (GND), U23.0 (EP), U23.4 (GND), U23.6 (A1), U24.0 (EP), U24.4 (GND), U32.0 (EP), U32.3 (GND)
I2C_RESET_1: U23.5 (RST)
unnamed: C107.1, U32.6 (CEXT)
unnamed: D17.1 (K), R29.1
unnamed: D18.1 (K), R31.1
unnamed: R28.1, U22.5 (SHDN)
unnamed: R30.1, U22.8 (RS)
SEC_CANH: U22.7 (CANH)
SEC_CANL: U22.6 (CANL)
SEC_DCAN1RX: U22.4 (RXD)
SEC_DCAN1TX: U22.1 (TXD)
SEC_I2C_SCL: R31.2, U23.2 (SCL)
SEC_I2C_SDA: R29.2, U23.1 (SDA), U23.7 (A0)
SEC_MRAM_CLK: U24.6 (SCK)
SEC_MRAM_MISO: U24.2 (SO)
SEC_MRAM_MOSI: U24.5 (SI)
SEC_MRAM_NCS: U24.1 (CS_N)
SEC_ONEWIRE: R77.2, U32.2 (IO)

Notes on the sheet:
Selected for max of 500kbps
I2C ADDR = 88h (0x44 7 bit)
