zmetzing/rt-ihu/pcb/secondary_power.kicad_sch

## KiCad design pcb/secondary_power.kicad_sch (2025-01-14)

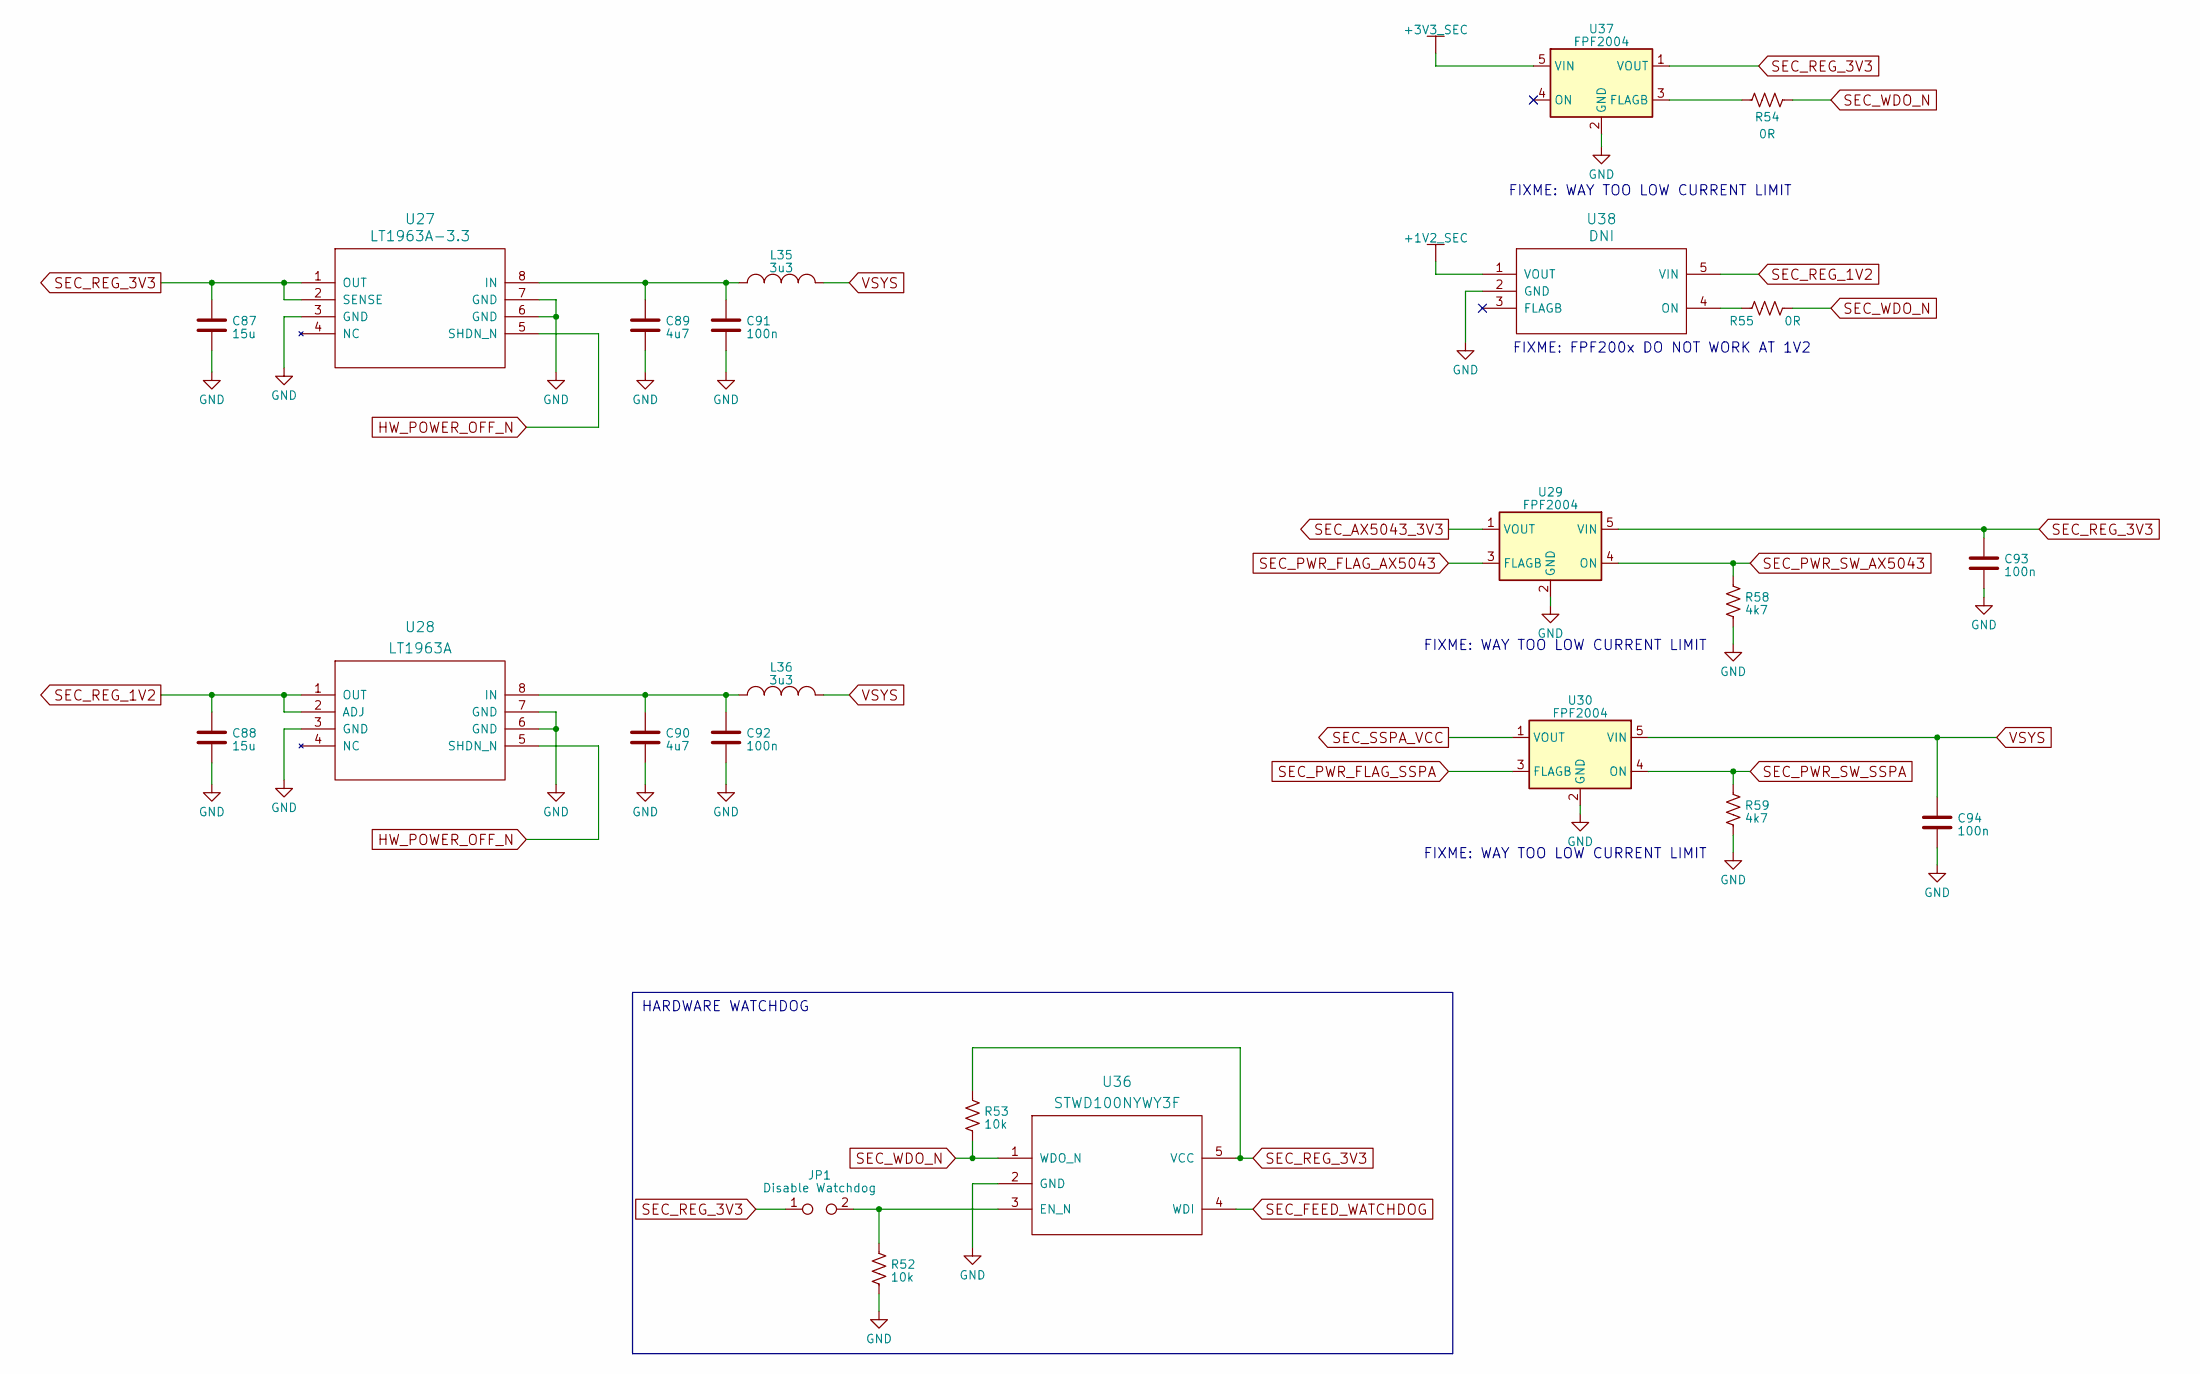
[picture p24: schematic secondary_power.kicad_sch]

Parts:
C87, C88: 15u
C89, C90: 4u7
C91, C92, C93, C94: 100n
JP1: Disable Watchdog
L35, L36: 3u3
R52, R53: 10k
R54, R55: 0R
R58, R59: 4k7
U27: LT1963A-3.3
U28: LT1963A
U29, U30, U37: FPF2004; SOT-353_SC-70-5
U36: STWD100NYWY3F
U38: DNI

Connections:
+1V2_SEC: U38.1 (VOUT)
+3V3_SEC: U37.5 (VIN)
GND: C87.2, C88.2, C89.2, C90.2, C91.2, C92.2, C93.2, C94.2, R52.2, R58.2, R59.2, U27.3 (GND), U27.6 (GND), U27.7 (GND), U28.3 (GND), U28.6 (GND), U28.7 (GND), U29.2 (GND), U30.2 (GND), U36.2 (GND), U37.2 (GND), U38.2 (GND)
HW_POWER_OFF_N: U27.5 (SHDN_N), U28.5 (SHDN_N)
unnamed: C89.1, C91.1, L35.1, U27.8 (IN)
unnamed: C90.1, C92.1, L36.1, U28.8 (IN)
unnamed: JP1.2, R52.1, U36.3 (EN_N)
unnamed: R54.1, U37.3 (FLAGB)
unnamed: R55.1, U38.4 (ON)
SEC_AX5043_3V3: U29.1 (VOUT)
SEC_FEED_WATCHDOG: U36.4 (WDI)
SEC_PWR_FLAG_AX5043: U29.3 (FLAGB)
SEC_PWR_FLAG_SSPA: U30.3 (FLAGB)
SEC_PWR_SW_AX5043: R58.1, U29.4 (ON)
SEC_PWR_SW_SSPA: R59.1, U30.4 (ON)
SEC_REG_1V2: C88.1, U28.1 (OUT), U28.2 (ADJ), U38.5 (VIN)
SEC_REG_3V3: C87.1, C93.1, JP1.1, R53.1, U27.1 (OUT), U27.2 (SENSE), U29.5 (VIN), U36.5 (VCC), U37.1 (VOUT)
SEC_SSPA_VCC: U30.1 (VOUT)
SEC_WDO_N: R53.2, R54.2, R55.2, U36.1 (WDO_N)
VSYS: C94.1, L35.2, L36.2, U30.5 (VIN)

Notes on the sheet:
FIXME: WAY TOO LOW CURRENT LIMIT
HARDWARE WATCHDOG
FIXME: FPF200x DO NOT WORK AT 1V2
