zmetzing/rt-ihu/pcb/secondary_tms570.kicad_sch

## KiCad design pcb/secondary_tms570.kicad_sch (2025-01-14)

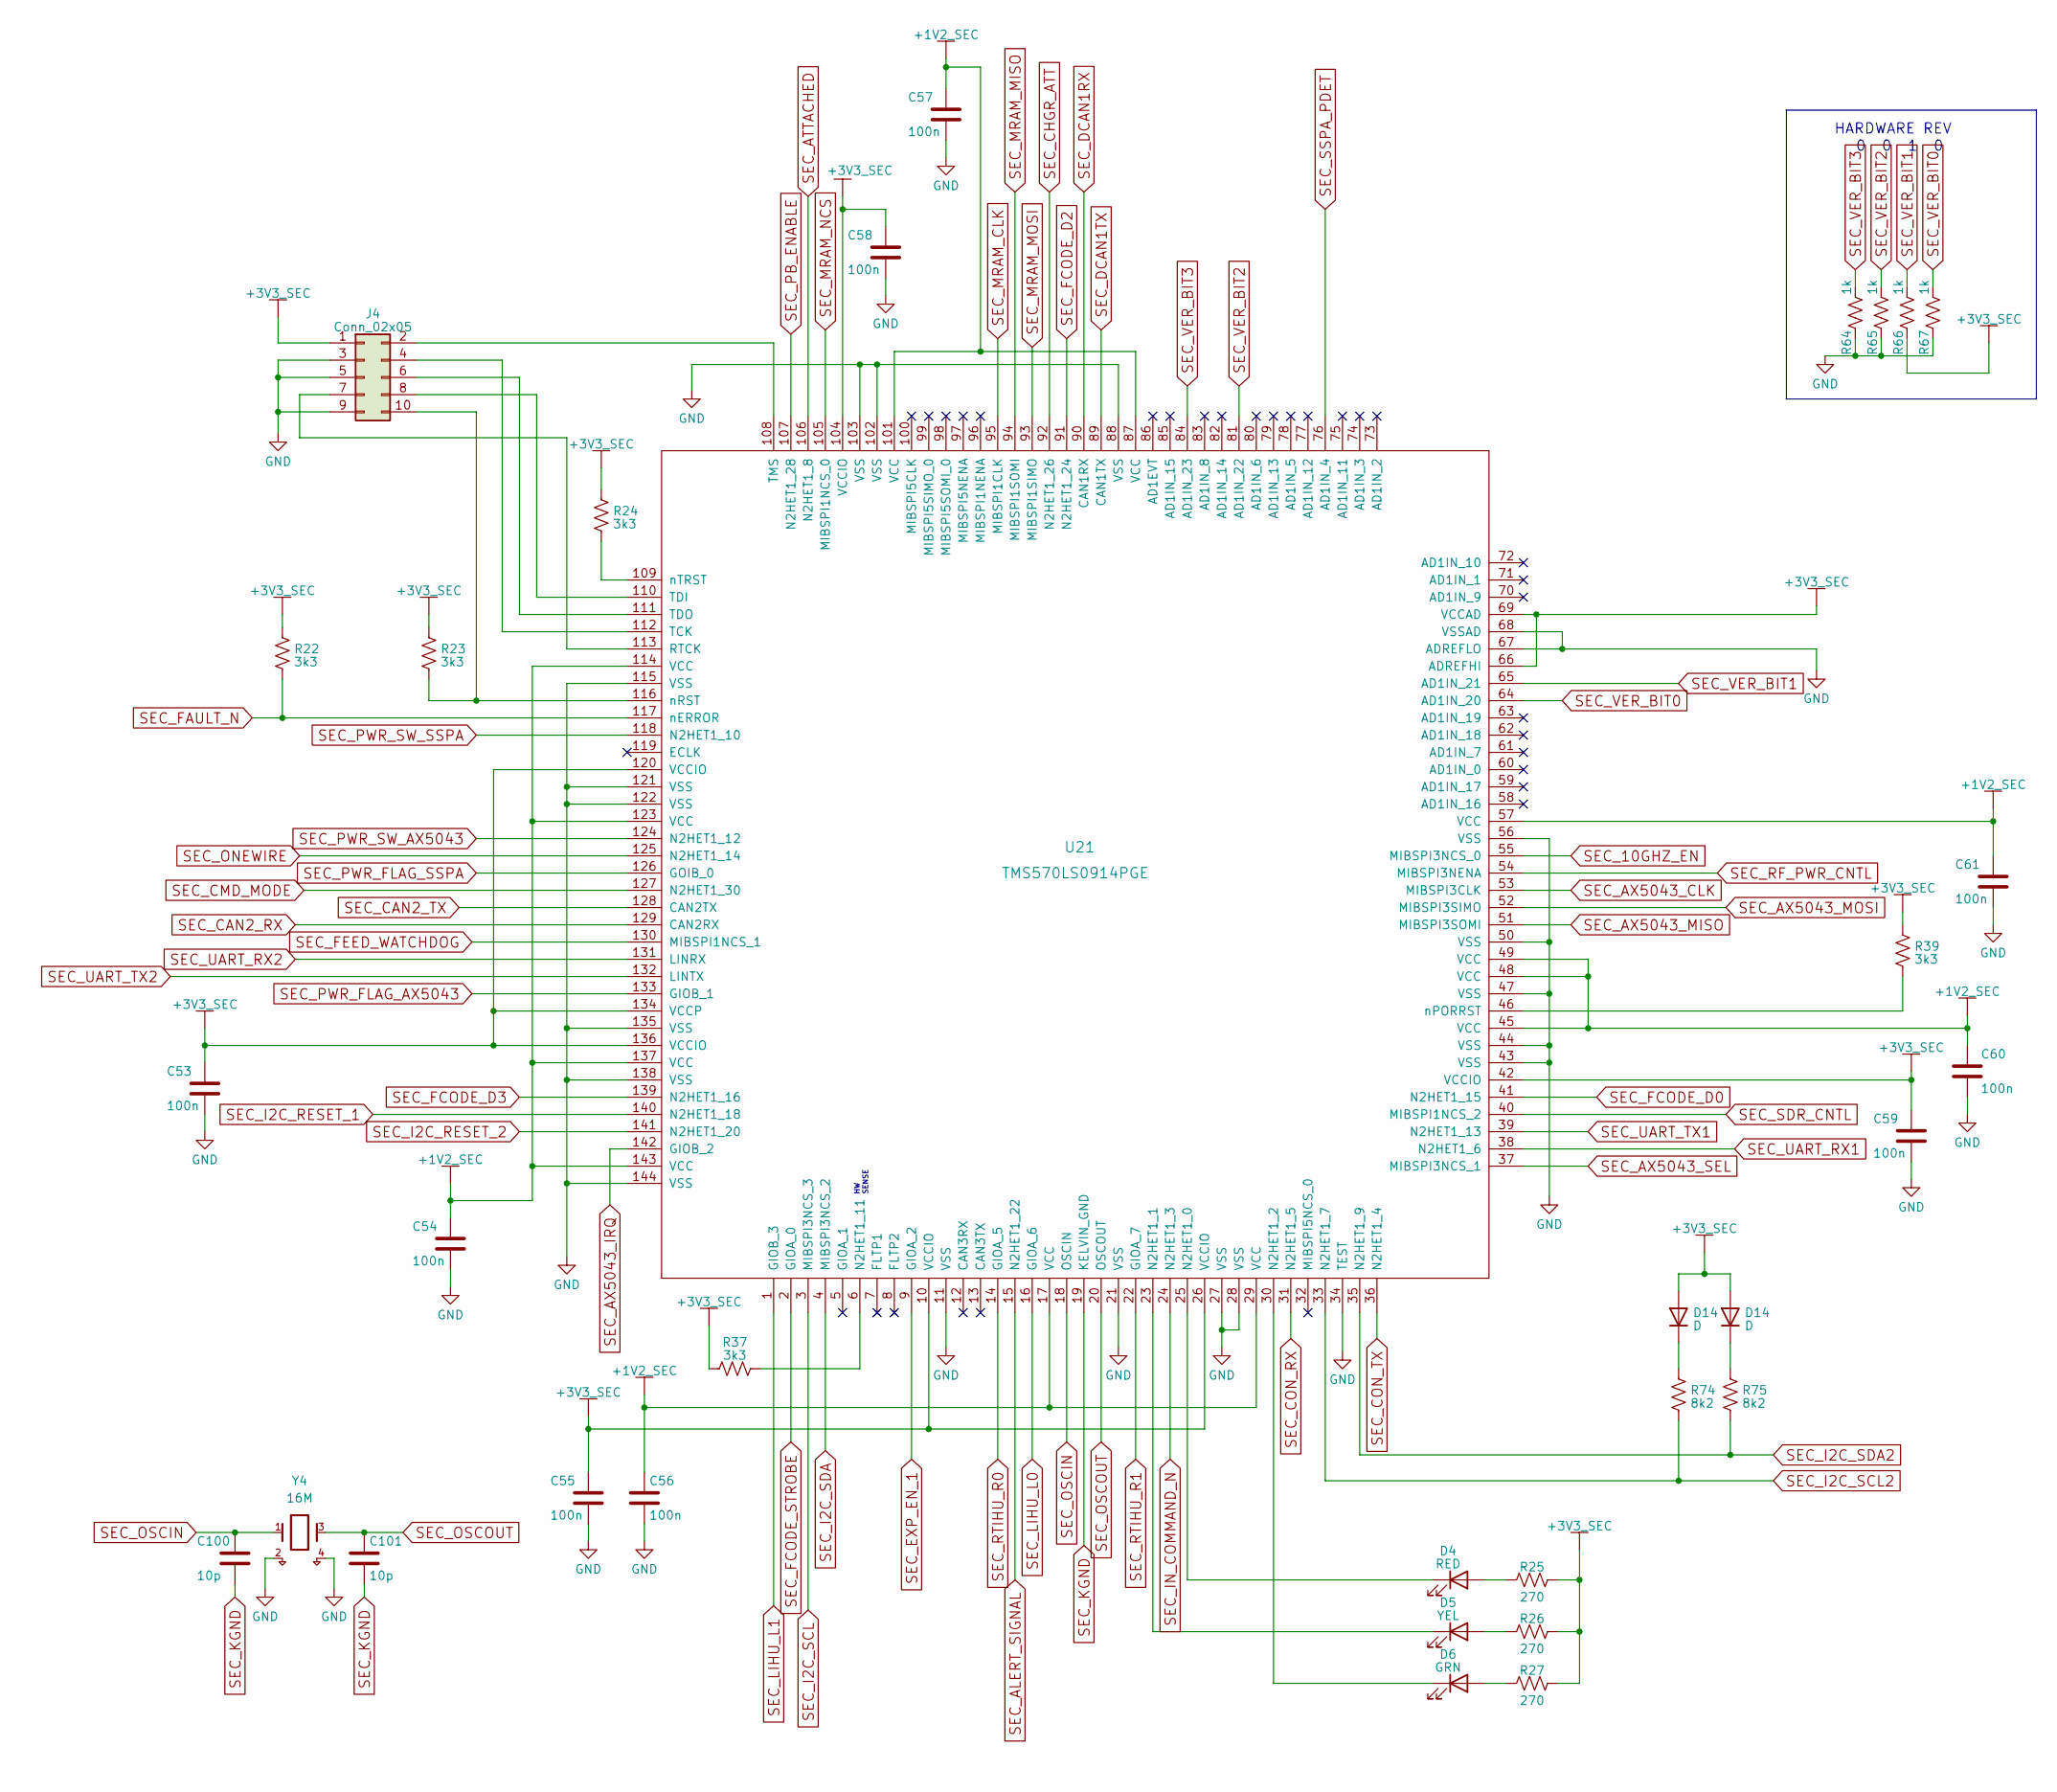
[picture p25: schematic secondary_tms570.kicad_sch]

Parts:
C53, C54, C55, C56, C57, C58, C59, C60, C61: 100n
C100, C101: 10p
D4: RED
D5: YEL
D6: GRN
D14: D
J4: Conn_02x05
R22, R23, R24, R37, R39: 3k3
R25, R26, R27: 270
R64, R65, R66, R67: 1k
R74, R75: 8k2
U21: TMS570LS0914PGE
Y4: 16M

Connections:
+1V2_SEC: C54.1, C56.1, C57.1, C60.1, C61.1, U21.17 (VCC), U21.29 (VCC), U21.45 (VCC), U21.48 (VCC), U21.49 (VCC), U21.57 (VCC), U21.87 (VCC), U21.101 (VCC), U21.114 (VCC), U21.123 (VCC), U21.137 (VCC), U21.143 (VCC)
+3V3_SEC: C53.1, C55.1, C58.1, C59.1, D14.2 (A), J4.1, R22.1, R23.1, R24.1, R25.2, R26.2, R27.2, R37.1, R39.1, R66.2, U21.10 (VCCIO), U21.26 (VCCIO), U21.42 (VCCIO), U21.66 (ADREFHI), U21.69 (VCCAD), U21.104 (VCCIO), U21.120 (VCCIO), U21.134 (VCCP), U21.136 (VCCIO)
GND: C53.2, C54.2, C55.2, C56.2, C57.2, C58.2, C59.2, C60.2, C61.2, J4.3, J4.5, J4.9, R64.2, R65.2, R67.2, U21.11 (VSS), U21.21 (VSS), U21.27 (VSS), U21.28 (VSS), U21.34 (TEST), U21.43 (VSS), U21.44 (VSS), U21.47 (VSS), U21.50 (VSS), U21.56 (VSS), U21.67 (ADREFLO), U21.68 (VSSAD), U21.88 (VSS), U21.102 (VSS), U21.103 (VSS), U21.115 (VSS), U21.121 (VSS), U21.122 (VSS), U21.135 (VSS), U21.138 (VSS), U21.144 (VSS), Y4.2, Y4.4
unnamed: D4.1 (K), U21.25 (N2HET1_0)
unnamed: D4.2 (A), R25.1
unnamed: D5.1 (K), U21.23 (N2HET1_1)
unnamed: D5.2 (A), R26.1
unnamed: D6.1 (K), U21.30 (N2HET1_2)
unnamed: D6.2 (A), R27.1
unnamed: D14.1 (K), R74.1, R75.1
unnamed: J4.2, U21.108 (TMS)
unnamed: J4.4, U21.112 (TCK)
unnamed: J4.6, U21.111 (TDO)
unnamed: J4.7, U21.113 (RTCK)
unnamed: J4.8, U21.110 (TDI)
unnamed: J4.10, R23.2, U21.116 (nRST)
unnamed: R24.2, U21.109 (nTRST)
unnamed: R37.2, U21.6 (N2HET1_11)
unnamed: R39.2, U21.46 (nPORRST)
SEC_10GHZ_EN: U21.55 (MIBSPI3NCS_0)
SEC_ALERT_SIGNAL: U21.15 (N2HET1_22)
SEC_ATTACHED: U21.106 (N2HET1_8)
SEC_AX5043_CLK: U21.53 (MIBSPI3CLK)
SEC_AX5043_IRQ: U21.142 (GIOB_2)
SEC_AX5043_MISO: U21.51 (MIBSPI3SOMI)
SEC_AX5043_MOSI: U21.52 (MIBSPI3SIMO)
SEC_AX5043_SEL: U21.37 (MIBSPI3NCS_1)
SEC_CAN2_RX: U21.129 (CAN2RX)
SEC_CAN2_TX: U21.128 (CAN2TX)
SEC_CHGR_ATT: U21.92 (N2HET1_26)
SEC_CMD_MODE: U21.127 (N2HET1_30)
SEC_CON_RX: U21.31 (N2HET1_5)
SEC_CON_TX: U21.36 (N2HET1_4)
SEC_DCAN1RX: U21.90 (CAN1RX)
SEC_DCAN1TX: U21.89 (CAN1TX)
SEC_EXP_EN_1: U21.9 (GIOA_2)
SEC_FAULT_N: R22.2, U21.117 (nERROR)
SEC_FCODE_D0: U21.41 (N2HET1_15)
SEC_FCODE_D2: U21.91 (N2HET1_24)
SEC_FCODE_D3: U21.139 (N2HET1_16)
SEC_FCODE_STROBE: U21.2 (GIOA_0)
SEC_FEED_WATCHDOG: U21.130 (MIBSPI1NCS_1)
SEC_I2C_RESET_1: U21.140 (N2HET1_18)
SEC_I2C_RESET_2: U21.141 (N2HET1_20)
SEC_I2C_SCL: U21.3 (MIBSPI3NCS_3)
SEC_I2C_SCL2: R74.2, U21.33 (N2HET1_7)
SEC_I2C_SDA: U21.4 (MIBSPI3NCS_2)
SEC_I2C_SDA2: R75.2, U21.35 (N2HET1_9)
SEC_IN_COMMAND_N: U21.24 (N2HET1_3)
SEC_KGND: C100.2, C101.2, U21.19 (KELVIN_GND)
SEC_LIHU_L0: U21.16 (GIOA_6)
SEC_LIHU_L1: U21.1 (GIOB_3)
SEC_MRAM_CLK: U21.95 (MIBSPI1CLK)
SEC_MRAM_MISO: U21.94 (MIBSPI1SOMI)
SEC_MRAM_MOSI: U21.93 (MIBSPI1SIMO)
SEC_MRAM_NCS: U21.105 (MIBSPI1NCS_0)
SEC_ONEWIRE: U21.125 (N2HET1_14)
SEC_OSCIN: C100.1, U21.18 (OSCIN), Y4.1
SEC_OSCOUT: C101.1, U21.20 (OSCOUT), Y4.3
SEC_PB_ENABLE: U21.107 (N2HET1_28)
SEC_PWR_FLAG_AX5043: U21.133 (GIOB_1)
SEC_PWR_FLAG_SSPA: U21.126 (GOIB_0)
SEC_PWR_SW_AX5043: U21.124 (N2HET1_12)
SEC_PWR_SW_SSPA: U21.118 (N2HET1_10)
SEC_RF_PWR_CNTL: U21.54 (MIBSPI3NENA)
SEC_RTIHU_R0: U21.14 (GIOA_5)
SEC_RTIHU_R1: U21.22 (GIOA_7)
SEC_SDR_CNTL: U21.40 (MIBSPI1NCS_2)
SEC_SSPA_PDET: U21.76 (AD1IN_4)
SEC_UART_RX1: U21.38 (N2HET1_6)
SEC_UART_RX2: U21.131 (LINRX)
SEC_UART_TX1: U21.39 (N2HET1_13)
SEC_UART_TX2: U21.132 (LINTX)
SEC_VER_BIT0: R67.1, U21.64 (AD1IN_20)
SEC_VER_BIT1: R66.1, U21.65 (AD1IN_21)
SEC_VER_BIT2: R65.1, U21.81 (AD1IN_22)
SEC_VER_BIT3: R64.1, U21.84 (AD1IN_23)

Notes on the sheet:
HW SENSE
HARDWARE REV
