zmetzing/rt-ihu/(commit log)

2025-01-14 Commit RT-IHU to GitHub repository
    [arbiter.kicad_sch, bus_filter.kicad_sch, bus_switch.kicad_sch, primary_ax5043.kicad_sch, primary_comm_mem.kicad_sch, primary_power.kicad_sch, primary_tms570.kicad_sch, rtihu.kicad_sch]
2025-01-14 Fixed symbol locations Removed kicad_sym duplicate (conversion)
